iic-jku/TinyWhisper/presentations/README.md

# Presentations

## EasterHegg 2026

EasterHegg #23 took place from April 3 to 6, 2026, in Koblenz, Germany. Matthias (DL9MJ) presented TinyWhisper in his talk "Open-Source Chip Design - A New Playground for Ham Radio?".

- Homepage: https://www.easterhegg.eu/category/easterhegg-2026/
- Slides: [EasterHegg_04042026.pdf](EasterHegg_04042026.pdf)
- Video: https://media.ccc.de/v/eh23-open-source-chip-design-a-new-playground-for-ham-radio

## CERN 2026

During his sabbatical, Harald visited CERN in Switzerland and presented TinyWhisper in his talk "From Schematic to Silicon: Mixed‑Signal IC Design in Open‑Source Flows" on May 4, 2026.

- Slides & Video: https://indico.cern.ch/event/1680490/

## FSiC 2026

The Free Silicon Conference (FSiC) took place from July 6 to 8, 2026, at the University of Ljubljana, Slovenia. Simon (OE3SDE) presented TinyWhisper in his talk "From Idea to Tapeout: An Open-Source Analog Mixed-Signal Design Flow with the IHP Open-PDK".

- Homepage: https://wiki.f-si.org/index.php?title=FSiC2026
- Talk page: https://wiki.f-si.org/index.php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
- Slides: [FSiC2026_OSICD-Flow_Final.pdf](https://wiki.f-si.org/images/8/86/FSiC2026_OSICD-Flow_Final.pdf)

## QSP Article

The Austrian Experimental Radio Society (Österreichischer Versuchssenderverband - ÖVSV) is celebrating its 100th anniversary in 2026. This milestone marks a century of technical innovation, experimentation, and community in the amateur radio world. To mark this occasion, Simon (OE3SDE) submitted a QSP article (German only) for the anniversary issue, which will be published in August.

- Copies of the ÖVSV amateur radio journal QSP can be downloaded here approximately six months after publication: https://www.oevsv.at/downloads/
