iic-jku/TinyWhisper/enclosure/README.md

# 3D-printed Enclosure

- 3D drawing with [FreeCAD](https://www.freecad.org/)
- 3D printing @ JKU / JMU
