iic-jku/TinyWhisper/ihp130/macros/README.md

# Macros

Every folder here is one macro with its own `Makefile` and `README.md`, following the same conventions as the chip top-level (`make help`, `make all`, `make clean`). The chip builds them through `make build-<macro>` and cleans them through `make clean-all` in the top-level [`Makefile`](../Makefile). The three macros are the three kinds of block a new one starts from:

| Macro | Kind | Source of truth | Flow |
| --- | --- | --- | --- |
| [`riscv/`](riscv/) | digital | SystemVerilog in `rtl/` | Verilator lint, Icarus Verilog and cocotb simulation, LibreLane hardening with DRC and LVS inside the run, a committed XSPICE model for the mixed-signal Xschem simulation, FPGA emulation on three boards |
| [`iqmod/`](iqmod/) | analog | Xschem schematics and hand-drawn GDS in `layout/` | Xschem testbenches, KLayout and Magic DRC, LVS and PEX, LEF, Liberty and Verilog stub export by Magic, CACE characterization |
| [`coupled_resonator_lc_bpf/`](coupled_resonator_lc_bpf/) | schematic-only | Xschem schematics | Xschem testbenches |

The `Makefile` in this folder has one job: it starts a new macro as a renamed copy of an existing one.

## Directory Structure

```text
📁 macros/
├─ 📁 coupled_resonator_lc_bpf/   schematic-only macro, see coupled_resonator_lc_bpf/README.md
├─ 📁 iqmod/                      analog macro, see iqmod/README.md
├─ 📁 riscv/                      digital macro, see riscv/README.md
├─ 📁 scripts/
│  └─ rename_gds_cells.py         renames the cells inside a GDS, used by make macro
├─ Makefile
└─ README.md
```

## Makefile Targets

### Show Available Targets

```sh
make help
```

### PDK Guard

`make macro` needs the `ihp-sg13g2` PDK, only `help` is exempt. The target renames the cells inside the copied GDS with KLayout and produces a macro that the chip flow builds against `ihp-sg13g2`, so a wrong `$PDK` is caught before it starts:

```sh
$ make macro FROM=iqmod NAME=mixer
Makefile:18: *** PDK is "ihp-sg13cmos5l", but the macros need "ihp-sg13g2". Run `sak-pdk ihp-sg13g2` in this shell and retry, or pass REQUIRED_PDK= to skip this check.  Stop.
```

The check is a parse-time conditional at the top of the Makefile, the same one every macro and IP Makefile carries. Switch the PDK with `sak-pdk ihp-sg13g2`, or pass `REQUIRED_PDK=` to skip the check.

### Start a New Macro from an Existing One

```sh
make macro FROM=<macro> NAME=<name>
```

`FROM` is the macro to copy, `iqmod` for an analog block, `riscv` for a digital one, `coupled_resonator_lc_bpf` for a schematic-only one, or any macro of your own that is already here. `NAME` is the name of the new macro: a lowercase letter followed by lowercase letters, digits or underscores, so that it works as a file name, a GDS cell name and a Verilog module name alike. The top cell follows the convention of the copied macro, so `NAME=amp` gives `amp_top` with the `amp_mfb_lpf`, `amp_mixer` and `amp_spdt_switch` cells from `iqmod`, and `NAME=cpu` gives the module `cpu_top` from `riscv`.

The target refuses to run when `NAME` exists already. Otherwise it does, in this order:

1. Copies every file of `FROM` that git knows about, tracked or untracked but not ignored. LibreLane runs, `sim_build/`, `__pycache__/` and the other ignored build outputs stay behind. A tracked file missing from the working tree, for example after `make clean` in `FROM`, is skipped. Outside a git checkout it falls back to copying the whole folder.
2. Runs `make clean` in the copy, so that the committed build outputs of the copied macro (`final/`, `netlist/`, `render/img/`, the reports) are gone as well.
3. Renames every file and folder whose name carries `FROM`.
4. Replaces `FROM` inside every text file, in its three spellings `iqmod`, `Iqmod` and `IQMOD`. That covers `TOP` in the `Makefile` and in every `fpga/<board>/Makefile`, `DESIGN_NAME` and `VERILOG_FILES` in `flow/librelane/config.yaml`, the symbol instances and the `.include` lines in the Xschem testbenches, `name:`, `template:` and `script:` in the CACE yaml, the file names in the plot scripts, the module names and include guards in the RTL, and `lib_name` and `lib_path` in the `.klib` library maps.
5. Renames the cells inside every GDS in `layout/` with [`scripts/rename_gds_cells.py`](scripts/rename_gds_cells.py). The DRC, LVS and PEX targets pass the file name as the cell name, so the two must match. A `.klay.gds` references cells from the libraries that its `.klay.klib` maps to other GDS files, and each link is stored inside the GDS by library name and cell name, where no text edit reaches it. The script processes the files in dependency order, libraries before the layouts that use them, and relinks every reference to the renamed cell of the renamed library, which is what KLayout resolves through its Library Manager plugin when you open the layout afterwards. It runs without the PDK, so the PCells stay frozen exactly as the source saved them instead of being re-evaluated against the installed PDK. The geometry does not change, an XOR of every layer against the source with the library maps resolved is empty.
6. Lists what still carries the old name. Markdown files and notebooks are left alone on purpose, they describe the copied design rather than reference it, and a blind rename would turn their prose into nonsense. Anything else in that list is something the target could not know about.

The copy is a complete macro that builds as one: `make all` in the new folder passes exactly as it does in the source, because nothing but names has changed. So the copy is the moment to commit, before the real work starts.

Run `make all` in the copy before any single simulation target. Step 2 removed the generated netlists, and the testbenches include them: `final/nl/` in the gate-level cocotb simulation of a `riscv` copy, whose XSPICE model stays because `make clean` keeps `netlist/xspice/`. An `iqmod` copy needs more than `make all`. Its 35 Xschem testbenches include nine extracted netlists under legacy names, `netlist/pex/<cell>_pex.spice`, which no target writes (`magic-pex` and `klayout-pex` write `<cell>_magic_pex_<mode>.spice` and `<cell>_klayout_pex_<mode>.spice`). Step 2 deletes them for good, so every testbench stops at its missing include until the `.include` line points at a netlist that exists.

For a new analog macro named `amp` and a new digital macro named `cpu`:

```sh
cd macros
make macro FROM=iqmod NAME=amp
make macro FROM=riscv NAME=cpu
```

> [!NOTE]
> The target runs in the IIC-OSIC-TOOLS container: it needs GNU `find`, `grep`, `sed` and `xargs`, and `klayout` for the GDS step.

### What Is Left to Do

The new macro still implements the copied design under its new name. What follows is the work the target cannot do.

#### From iqmod (Analog)

1. Replace the design: the schematics and symbols in `schematic/xschem/`, the layout sources in `layout/` (`<NAME>_top.klay.gds` and the `.klay.gds` files it pulls in through the `.klib` library maps, down to the unit cell `.gds` files) and the export `layout/<NAME>_top.gds`, see [Layout Sources and the Exported Tapeout GDS](iqmod/README.md#layout-sources-and-the-exported-tapeout-gds). Keep the box on the `prBoundary` layer (`189/0`) around the top cell and resize it with the macro, `make check-boundary` verifies it.
2. Rewrite the testbenches in `testbenches/xschem/` and the plot scripts in `testbenches/xschem/plot_simulations/` for the new pins and measurements, and the testbench list of `sim-all` in the `Makefile`. `make symbol-pex` rebuilds `<CELL>_pex.sym` from the cell symbol, so only the cell symbols need drawing.
3. Adapt the CACE datasheets in `verification/cace/` with their templates and scripts, or delete the folder together with the `sim-cace` line of `sim-all`.
4. The sizing notebooks in `scripts/sizing/`, the filter designer in `scripts/filter_designer/` and the PWM generator in `scripts/pwm_generator/` are specific to the IQ modulator, adapt or delete them.
5. Rewrite `README.md` and `render/blender/README.md`.

#### From riscv (Digital)

1. Replace the RTL in `rtl/` and adjust `MODULES_SYNTH` and `MODULES_SIM` in the `Makefile` when you add or drop files. `rtl/constants.sv` keeps its name, its macros were renamed with the rest.
2. When the ports change, delete both symbols in `schematic/xschem/` instead of editing them. An edited copy of the riscv symbol looks plausible, but `make symbol-check` rejects every pin that no longer matches a port. Harden once, scaffold the symbol from the ports of the hardened design, arrange it, and only then run the full flow:

    ```sh
    make librelane        # harden the new design
    make copy-netlist     # brings netlist/pnl/<TOP>.pnl.v into the tree
    make symbol-gl        # scaffold schematic/xschem/<TOP>.sym from its ports
    xschem schematic/xschem/<TOP>.sym   # rename pins to house style, arrange, draw the body
    make all
    ```

    The XSPICE model in `netlist/xspice/` is a committed source file of this macro that `clean` keeps, and `generate-xspice` rebuilds it only while the free-running frequency generation in `rtl/memory.sv` is active, see [Generate XSPICE File](riscv/README.md#generate-xspice-file). Wire the Xschem testbench to the finished symbol afterwards, because its pins are what the testbench connects to by coordinate. See [Build the Xschem Symbol](riscv/README.md#build-the-xschem-symbol).
3. Update `CLOCK_PORT` and `DIE_AREA` in `flow/librelane/config.yaml`, the pin placement in `flow/librelane/pin_order.cfg`, and the constraints in `impl.sdc` and `signoff.sdc`.
4. Rewrite the testbenches in `testbenches/verilog/`, `testbenches/cocotb/` and `testbenches/xschem/`.
5. Update `DUT_SRCS` in `fpga/dut.mk` and the pin constraint file in each `fpga/<board>/` you care about to the ports of the new design. Delete the board folders you do not need, the dispatcher derives its board list from the folders that are there. See [fpga/README.md](riscv/fpga/README.md).
6. Rewrite `README.md`, `fpga/README.md` and `render/blender/README.md`.

#### From coupled_resonator_lc_bpf (Schematic-Only)

1. Replace the schematics and symbols in `schematic/xschem/`, the testbench in `testbenches/xschem/`, and the testbench list of `sim-all` in the `Makefile`.
2. The filter design sheet in `scripts/` is specific to the coupled-resonator filter, adapt or delete it.
3. Rewrite `README.md`.

### Register the Macro at the Chip Top-Level

There is no central macro list. A new macro is added in these places, all relative to `ihp130/`:

1. `Makefile`: a `build-<NAME>` target, its line in `build-macros`, and a `clean` line in `clean-all`.
2. `rtl/tinywhisper_core.sv`: instantiate the macro.
3. `flow/librelane/config.yaml`: a `MACROS` entry with the view paths (`dir::../../macros/<NAME>/final/...`) and the instance placement. The placement of an analog macro snaps to the Metal3 routing grid, see [doc/floorplan.md](../doc/floorplan.md).
4. `flow/librelane/pdn_cfg.tcl`: a `define_pdn_grid -macro` block when the power pins of the macro are not on the layers of the default grid, see the `iqmod_top` block at the end of the file.
5. `schematic/xschem/xschemrc`: a `source` line for the `xschemrc` of the new macro, without it the symbols of the macro do not resolve at the chip top-level.
6. `schematic/xschem/tinywhisper.sch` or `tinywhisper_top.sch`: place the symbol of the macro where the chip instantiates it.
7. `testbenches/cocotb/tinywhisper_top_tb.py`: the `sources` list names the netlist or RTL and the stub of every macro.
8. The documentation: [doc/floorplan.md](../doc/floorplan.md), [doc/specifications.md](../doc/specifications.md), [doc/pinout.md](../doc/pinout.md) when pins change, and the chip [README.md](../README.md).

`.gitignore` and `REUSE.toml` need no line: their `ihp130/macros/*/` patterns already cover the build outputs and the files without a license header of every macro, so a new macro passes `reuse lint` and keeps its simulation outputs out of `git status` from the first build. Add the macro to git before running `reuse lint`: git does not report the ignored paths inside a folder it does not track yet, so the lint lists the build outputs of an untracked macro.
