iic-jku/TinyWhisper/ihp130/doc/README.md

# Documentation

Reference material for this chip and for the IHP SG13G2 Open-PDK it is built on.

## This chip

| Document | Contents |
| --- | --- |
| [specifications.md](specifications.md) | Top-level specifications: technology, supplies, clock, corner list, macro inventory, functional behaviour of every block. |
| [pinout.md](pinout.md) | The full 56-pad table (14 per side), with the `tinywhisper_top` port and the role each pad carries inside `tinywhisper_core`. [pinout.pdf](pinout.pdf) is the drawn version of the same table. |
| [floorplan.md](floorplan.md) | Die and core geometry, hard-macro placement coordinates, the RF and analog routing rules and the floorplan description. |

The three are cross-linked and are written against the design files, not the other way round. If you change a number in [flow/librelane/config.yaml](../flow/librelane/config.yaml), [rtl/](../rtl/) or [packaging/config.yaml](../packaging/config.yaml), mirror it here.

## Tools

| Document | Contents |
| --- | --- |
| [klayout/klayout_cheatsheet.md](klayout/klayout_cheatsheet.md) | KLayout for this PDK: shortcuts, the `SG13_dev` PCell list, layer roles, padframe components, the DRC and LVS menu entries. |
| [librelane/librelane_cheatsheet.md](librelane/librelane_cheatsheet.md) | LibreLane `final/` directory anatomy, non-default routing rules, the complete SG13G2 via and metal-stack tables, the eight LEF/DEF orientations. |
| [naming/](naming/) | The file and VHDL naming conventions this repository follows. |

## PDK

| Document | Contents |
| --- | --- |
| [ihp-sg13g2-Open-PDK/sg13g2_os_layout_cheatsheet.xlsx](ihp-sg13g2-Open-PDK/sg13g2_os_layout_cheatsheet.xlsx) | One sheet of formulas for wire resistance, parasitic capacitance and DC current limits. Read the caveats below before using it. |
| [ihp-sg13g2-Open-PDK/sg13g2_ngspice_mc_mm_guide.md](ihp-sg13g2-Open-PDK/sg13g2_ngspice_mc_mm_guide.md) | How the ngspice model files fit together, what `mm_ok` and `num_sigmas` do, and which corner, Monte Carlo and mismatch runs are possible per device family. |
| [sizing/](sizing/) | gm/ID techsweep plot overviews for the LV and HV MOS devices, the data behind the sizing notebooks in [macros/iqmod/scripts/sizing/](../macros/iqmod/scripts/sizing/). |

## Provenance and caveats

- **The IHP PDF documents are deliberately not tracked here.** `sg13g2_os_layout_rules.pdf` and `sg13g2_os_process_spec.pdf` are listed in [.gitignore](../../.gitignore), so this folder may hold local copies that are invisible to git. Take them from `$PDK_ROOT/$PDK/libs.doc/doc/` when you need them, which also means they are never stale. The layout rules are the authoritative source when a tool deck and a datasheet disagree.
- **The layout cheatsheet is a convenience, not a rule source.** Its resistance columns assume bulk-aluminium resistivity and come out roughly a factor of two optimistic against the `RESISTANCE RPERSQ` values in `sg13g2_tech.lef`, and its "min. Width" column lists 0.42 um for TopMetal1 and 0.2 um for TopMetal2 where the tech LEF says 1.64 um and 2.0 um (0.42 is the TopVia1 cut size). Take widths from the DRC deck, resistance from the tech LEF or from PEX, and the DC current limits from the tables in the [LibreLane cheatsheet](librelane/librelane_cheatsheet.md), which are read out of the tech LEF. The sheet's `Contact` current limit of 0.3 mA per cut exists only there, the tech LEF has no `DCCURRENTDENSITY` entry for `Cont`.
- **Only the files listed above are tracked.** Other folders may appear here in a working copy (tool cheatsheets, course material, vendor PDFs) and are gitignored.
- **Nothing in `doc/` is generated by a make target.** It is all hand-maintained.
