iic-jku/TinyWhisper/ihp130/macros/coupled_resonator_lc_bpf/scripts/Double-Terminated Double-Tuned LC Bandpass Filters.pdf

Double-Terminated Double-Tuned LC Bandpass Filters | TinyWhisper

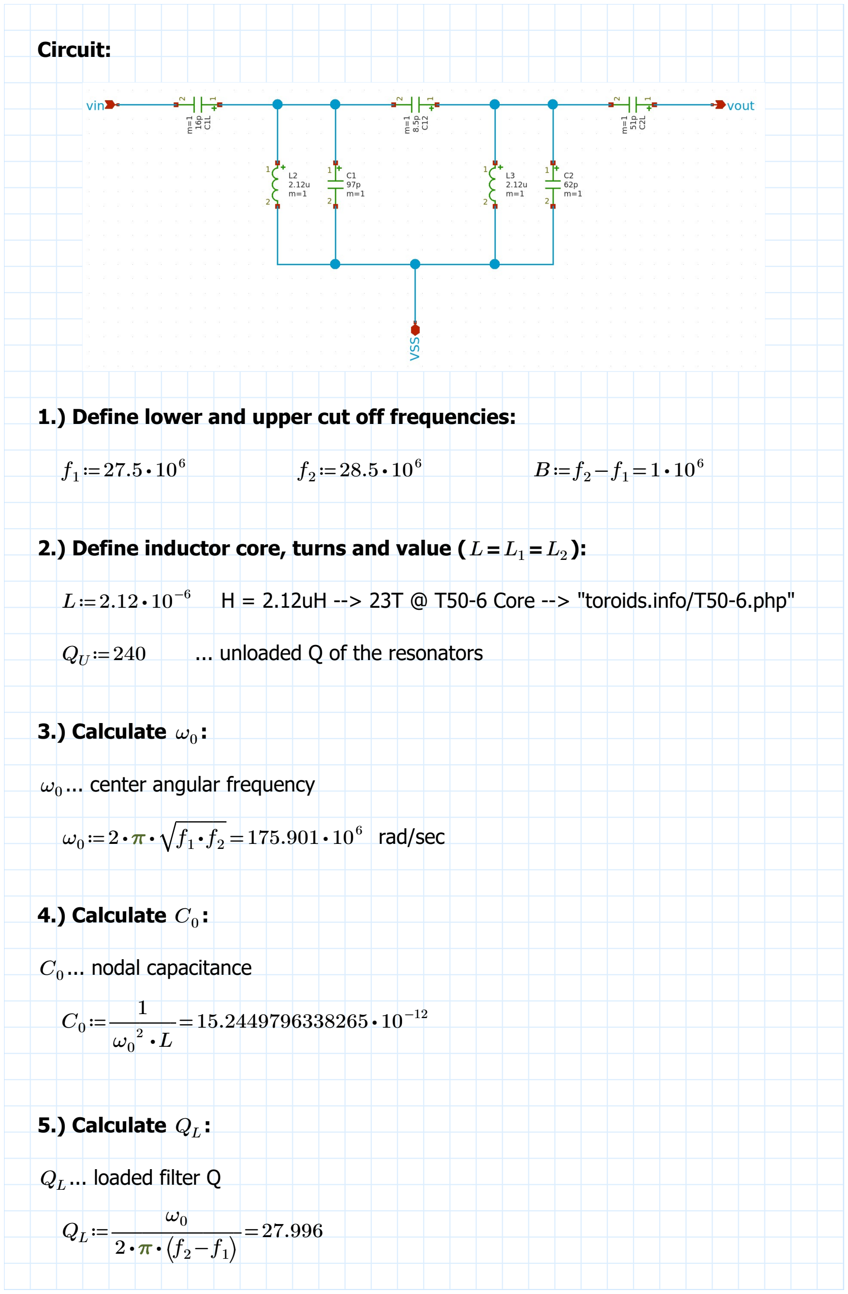
[picture p10: figure]
Circuit:; ... unloaded Q of the resonators; 3.) Calculate ω : 0; ... center angular frequency; rad/sec; 4.) Calculate C : 0; ... nodal capacitance; 5.) Calculate Q : L; ... loaded filter Q

1.) Define lower and upper cut off frequencies:

f1≔27.5 ⋅ 10⁶ | f2≔28.5 ⋅ 10⁶ | B≔f2-f1=1 ⋅ 10⁶
2.) Define inductor core, turns and value (L＝L | ＝ | ): 1 | L2
L≔2.12 ⋅ 10⁻⁶ | H = 2.12uH --> 23T @ T50-6 Core --> "toroids.info/T50-6.php"

Page 1 of 3

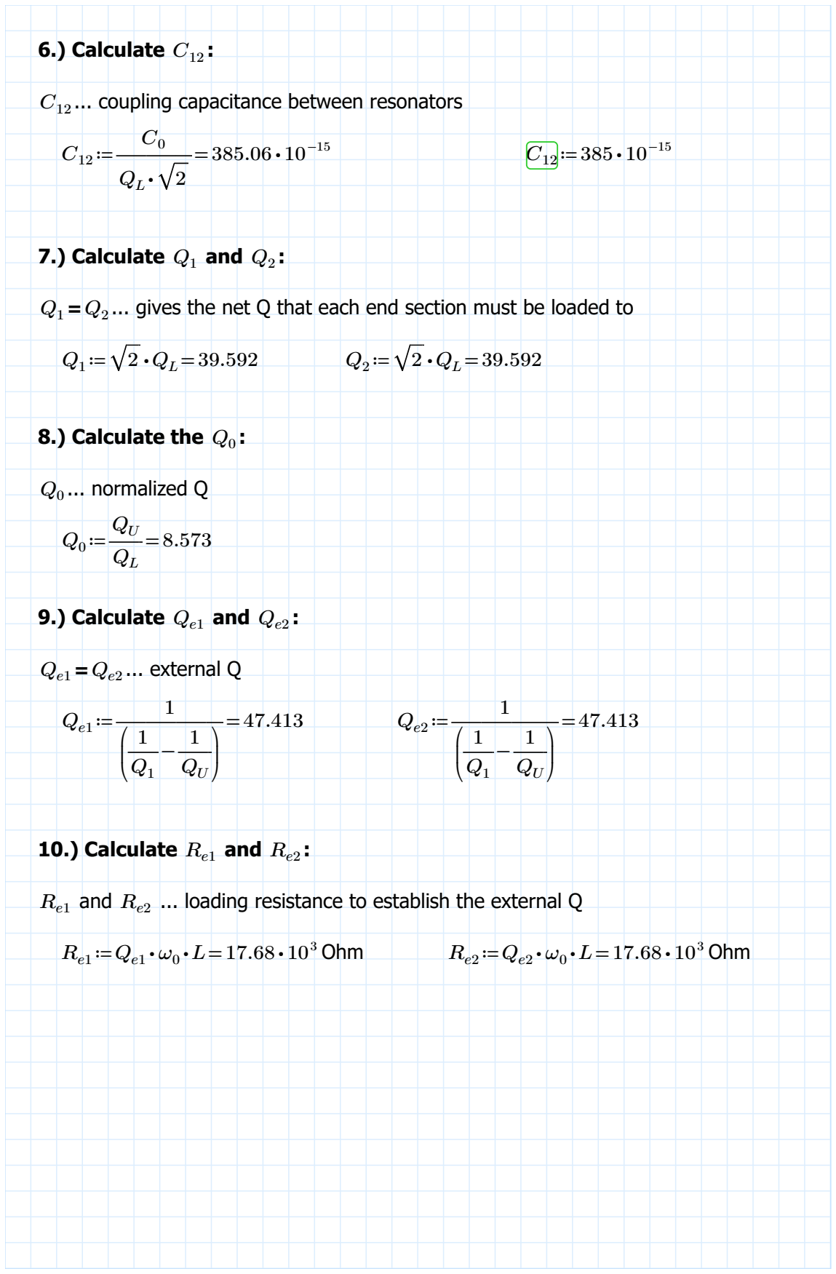
[picture p11: figure]
6.) Calculate C : 12; 7.) Calculate Q and; 8.) Calculate the; ... normalized Q; 9.) Calculate Q; and; Qe1＝Qe2 ... external Q; 10.) Calculate; ⋅L=17.68 ⋅ 10³ Ohm

C ... coupling capacitance between resonators 12

... gives the net Q that each end section must be loaded to

Re1 and Re2 ... loading resistance to establish the external Q

Page 2 of 3

11.) Calculate | C | and | : 1L | C2L
C1L | and C2L ... couple capacitor --> couple input load to | Re1 and output load toRe2
RIN≔1 ⋅ 10³ | Ohm | ... input load
ROUT≔50 | Ohm | ... output load

C1L≔―――――――=

1
ω | ⋅ 0
- R ⋅ e1 | RIN | RIN

2

1.39 ⋅ 10⁻¹² | C1L≔1.4 ⋅ 10⁻¹²

C2L≔――――――――=

1
ω | ⋅ 0
- R ⋅ e2 | ROUT | ROUT

2

6.05 ⋅ 10⁻¹² | C2L≔6.0 ⋅ 10⁻¹²
12.) Calculate | C | and | : 1 | C2
C | and | ... resonator tune capacitors 1 | C2

C1≔C0-C1L-C12=13.46 ⋅ 10⁻¹²

C2≔C0-C2L-C12=8.86 ⋅ 10⁻¹²

Formulas: https://archive.org/details/SolidStateDesignForTheRadioAmateur1986/page/n239

Page 3 of 3
