iic-jku/TinyWhisper/sky130/macros/iqmod/doc/TinyWhisper_SKY130.pdf

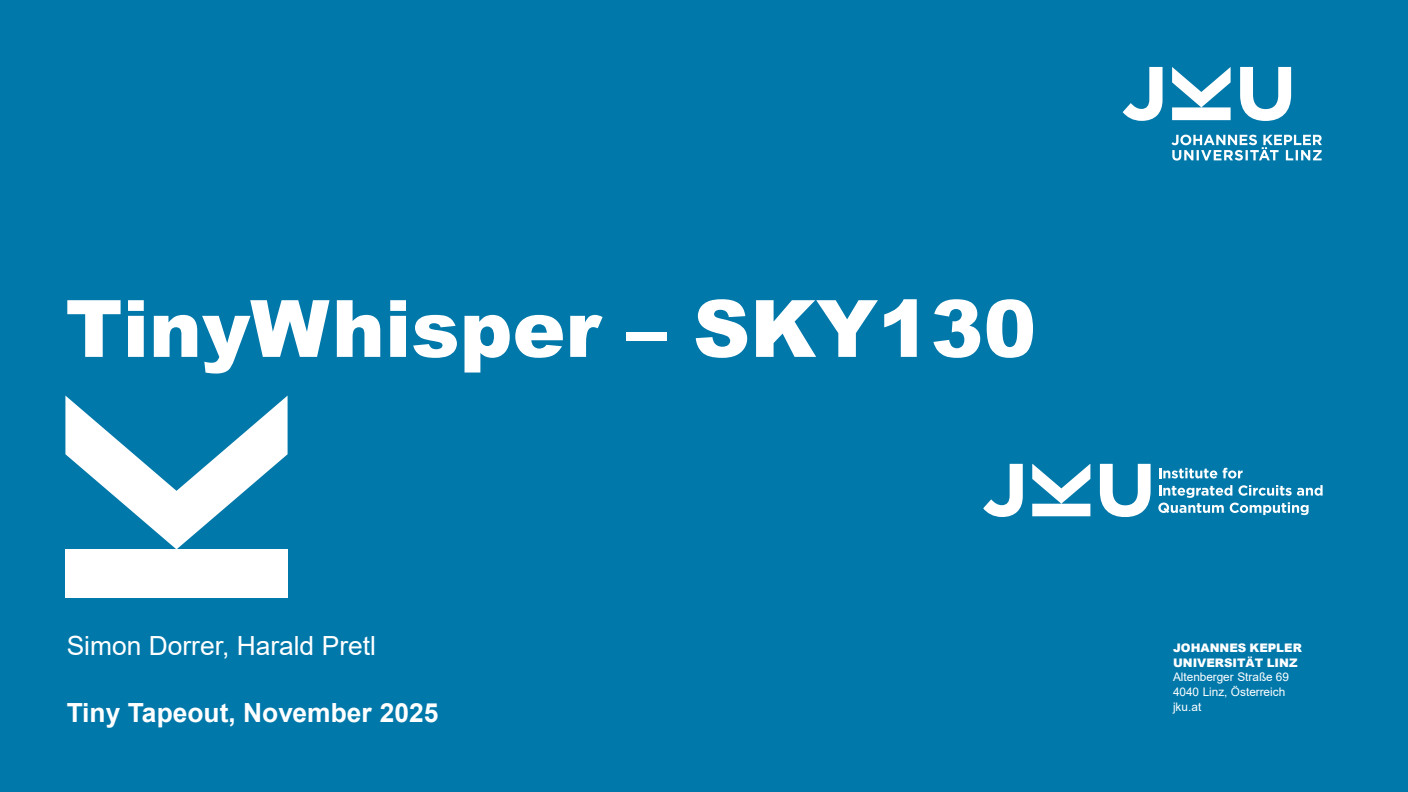
[picture p12: page 1]
JOHANNES KEPLER UNIVERSITÄT LINZ Altenberger Straße 69 4040 Linz, Österreich jku.at; TinyWhisper – SKY130

Simon Dorrer, Harald Pretl

Tiny Tapeout, November 2025

## Top-Level Schematic

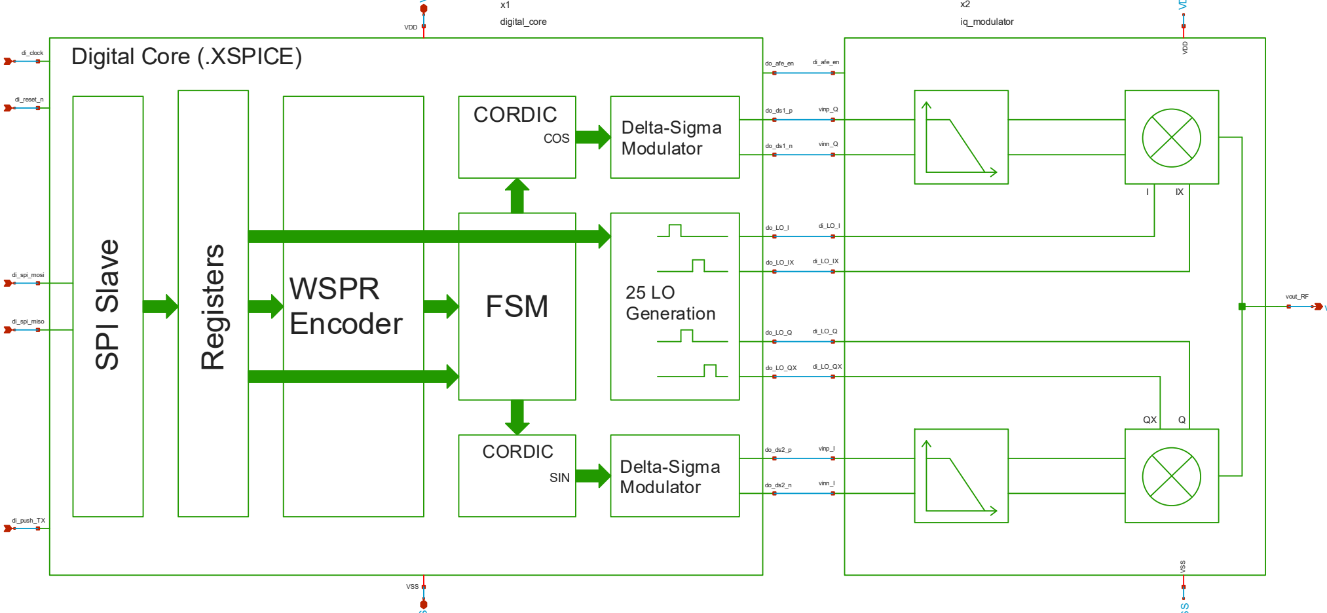
[picture p13: figure]

# Inverter-Based OTA

## Schematic – Inverter

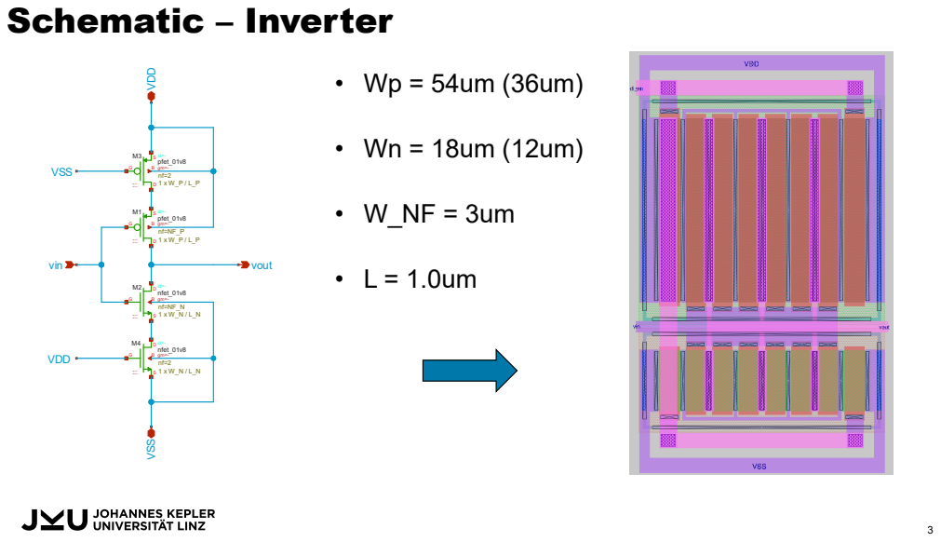
[picture p14: page 4]

## Schematic

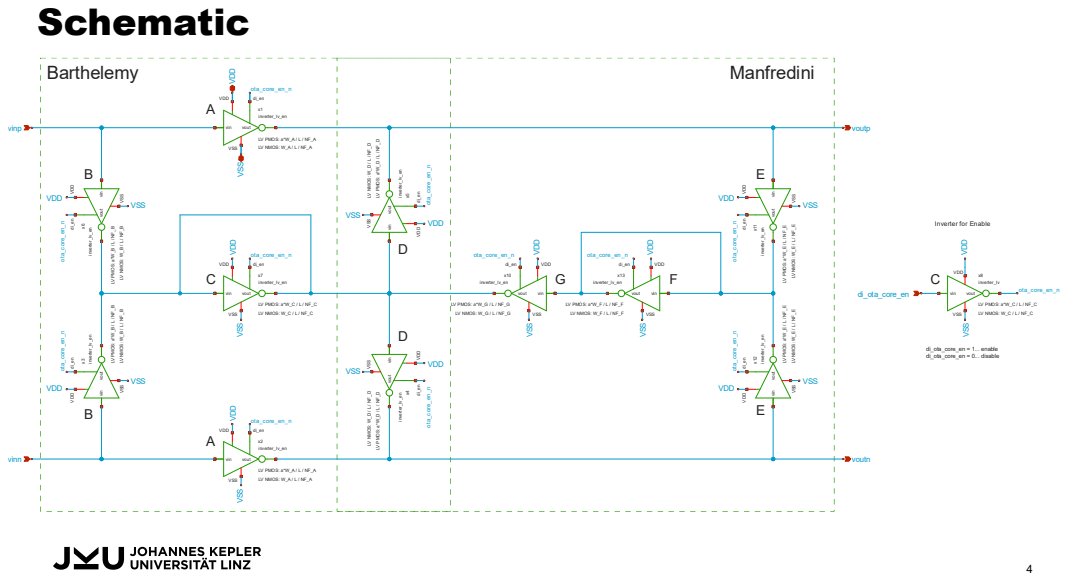
[picture p15: page 5]

## Layout

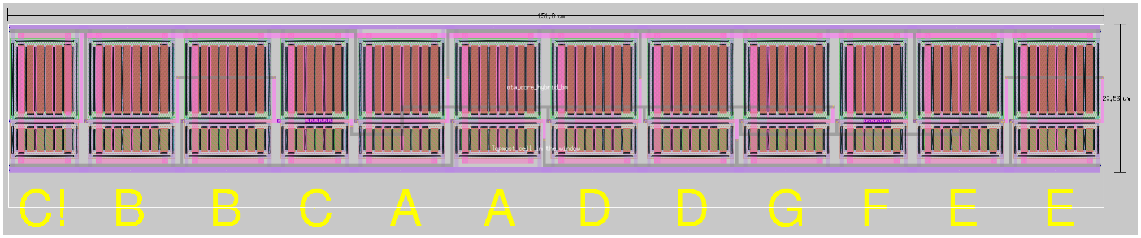
[picture p16: figure]

## DC Testbench – Output Voltage Swing

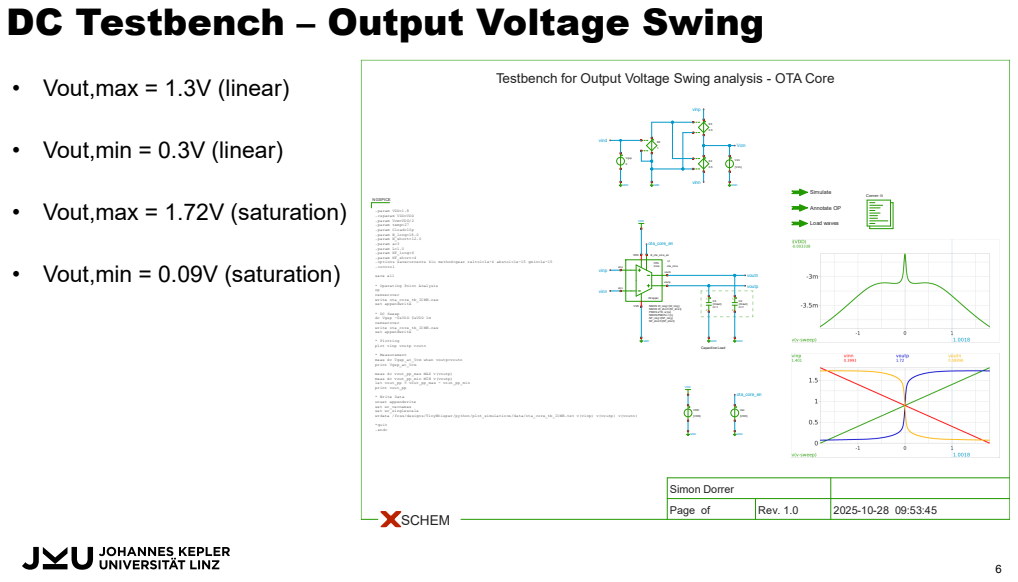
[picture p17: page 7]

• Vout,max = 1.3V (linear)

• Vout,min = 0.3V (linear)

• Vout,max = 1.72V (saturation)

• Vout,min = 0.09V (saturation)

## AC Testbench – Open-Loop Gain

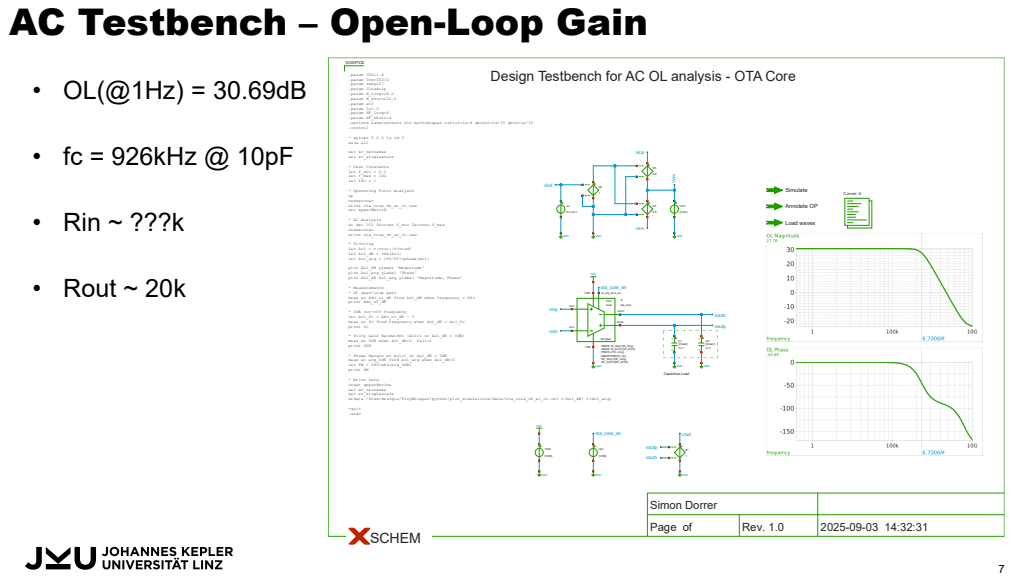
[picture p18: page 8]
• fc = 926kHz @ 10pF; • Rin ~ ???k; • Rout ~ 20k

## CACE – Open-Loop Gain

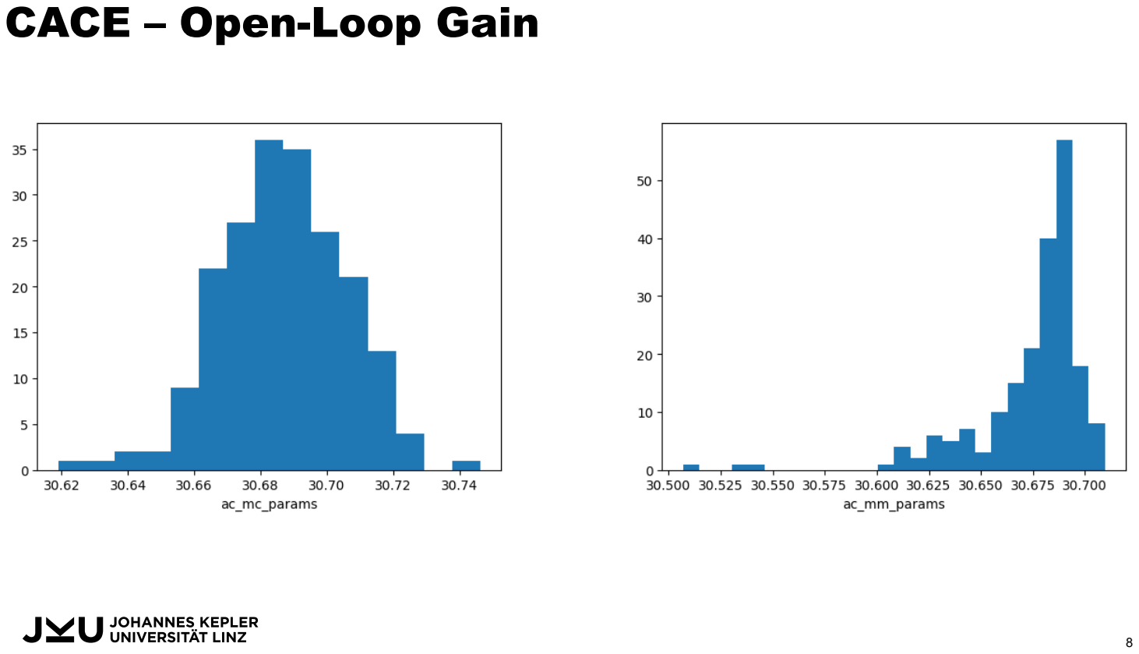
[picture p19: page 9]

## CACE – Corner Frequency

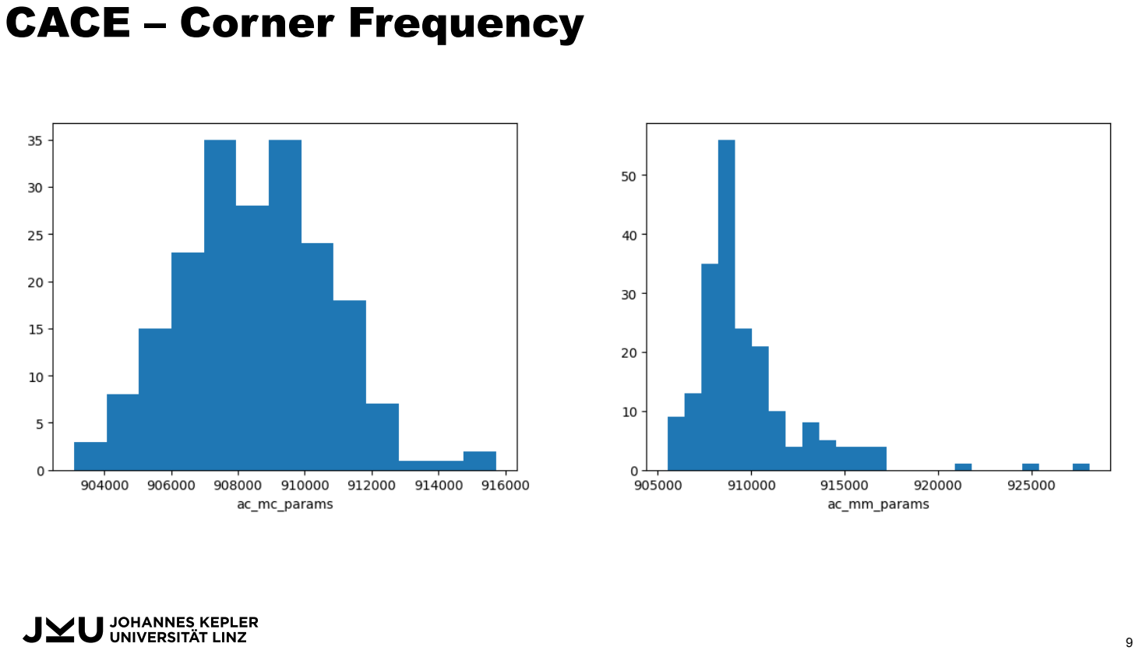
[picture p20: page 10]

# Multiple Feedback Filter

## Schematic

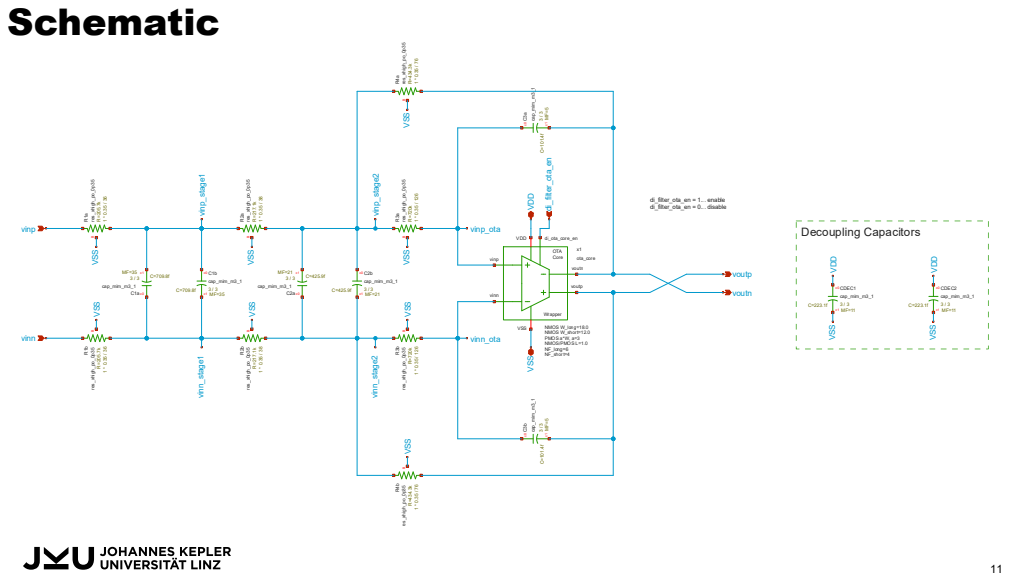
[picture p21: page 12]

## Layout

- ToDo

## AC Testbench – Closed-Loop Gain

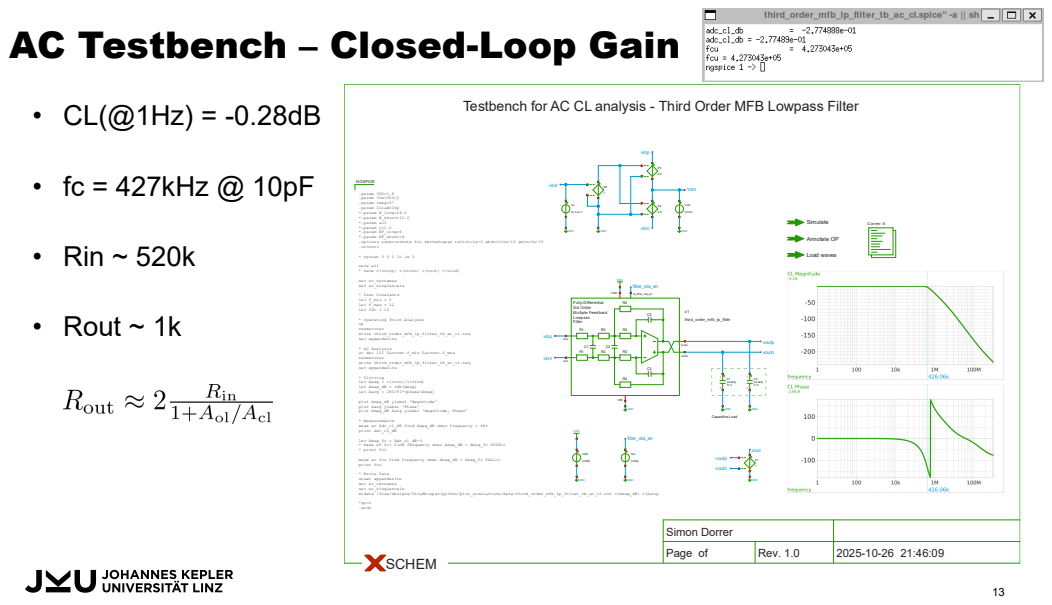
[picture p22: page 14]
• fc = 427kHz @ 10pF; • Rin ~ 520k; • Rout ~ 1k

## CACE – Closed-Loop Gain

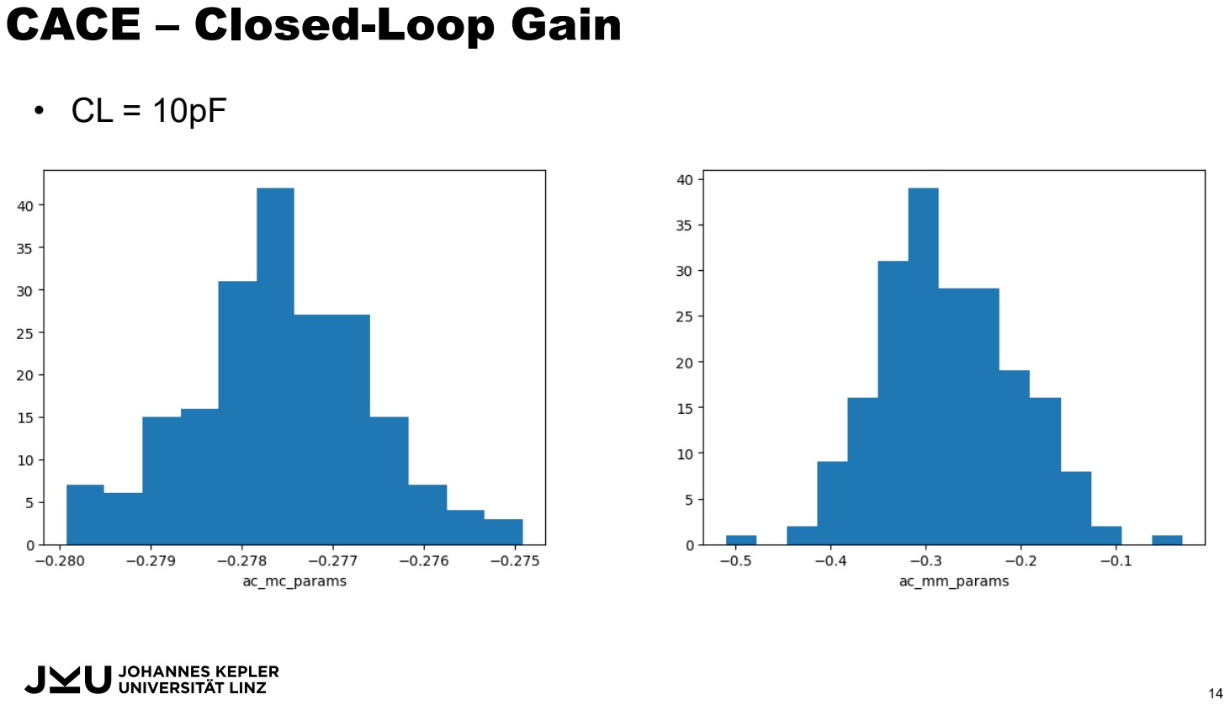
[picture p23: page 15]

- CL = 10pF

## CACE – CMRR

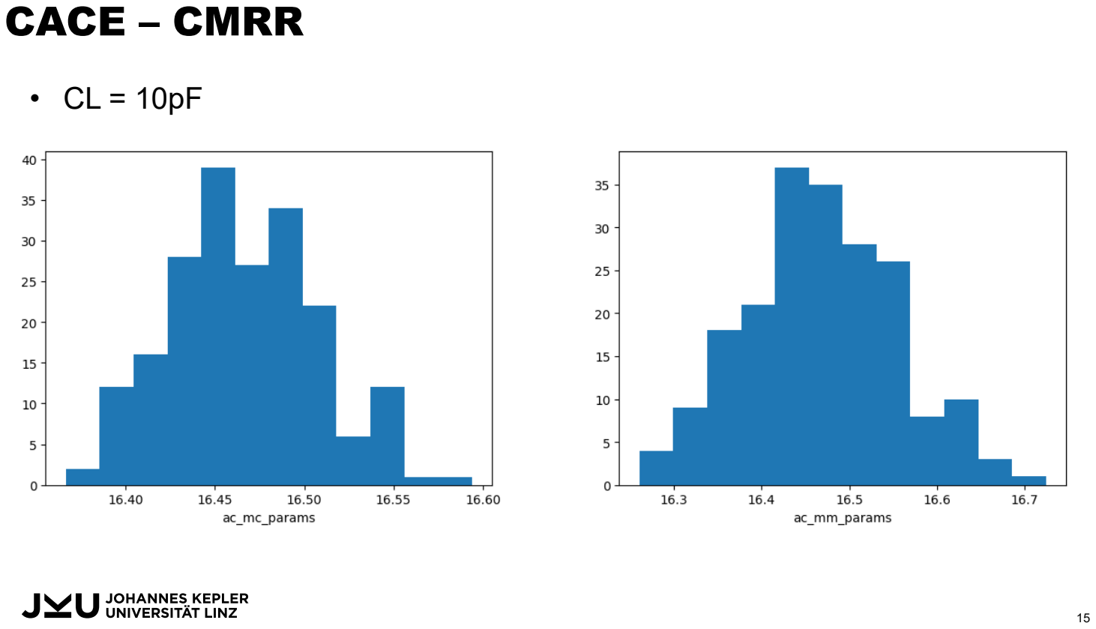
[picture p24: page 16]

- CL = 10pF

## CACE – Corner Frequency

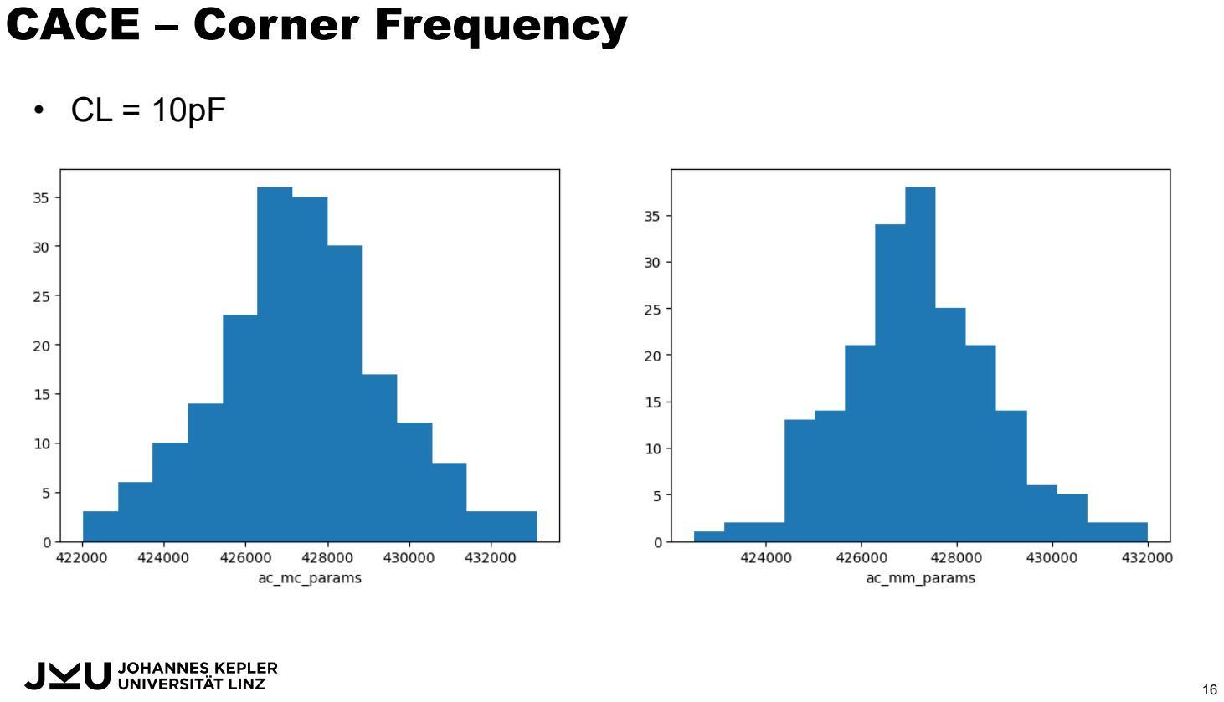
[picture p25: page 17]

- CL = 10pF

## AC Testbench – Loop Gain

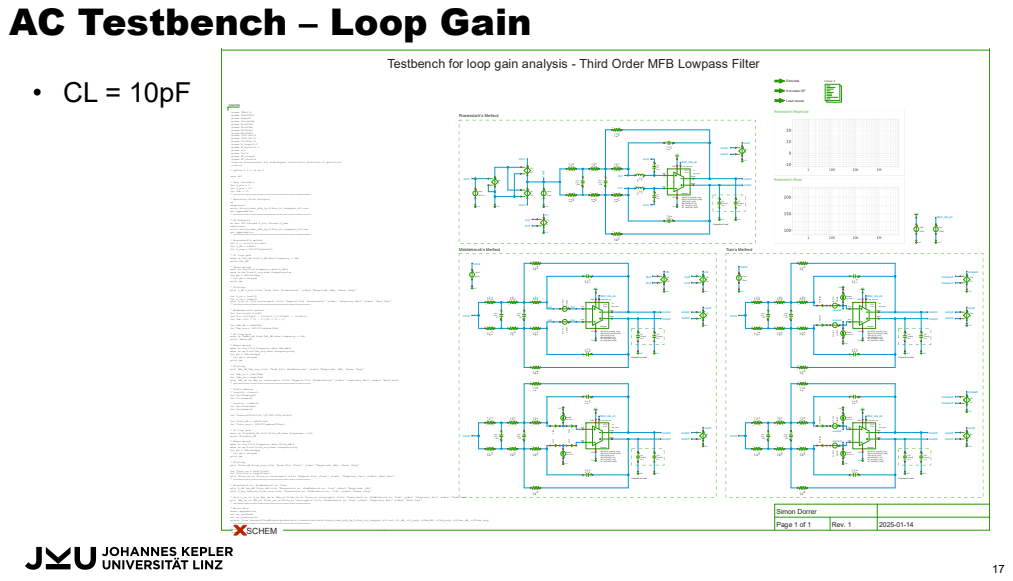
[picture p26: page 18]

## AC Testbench – Loop Gain

- PM = 111°

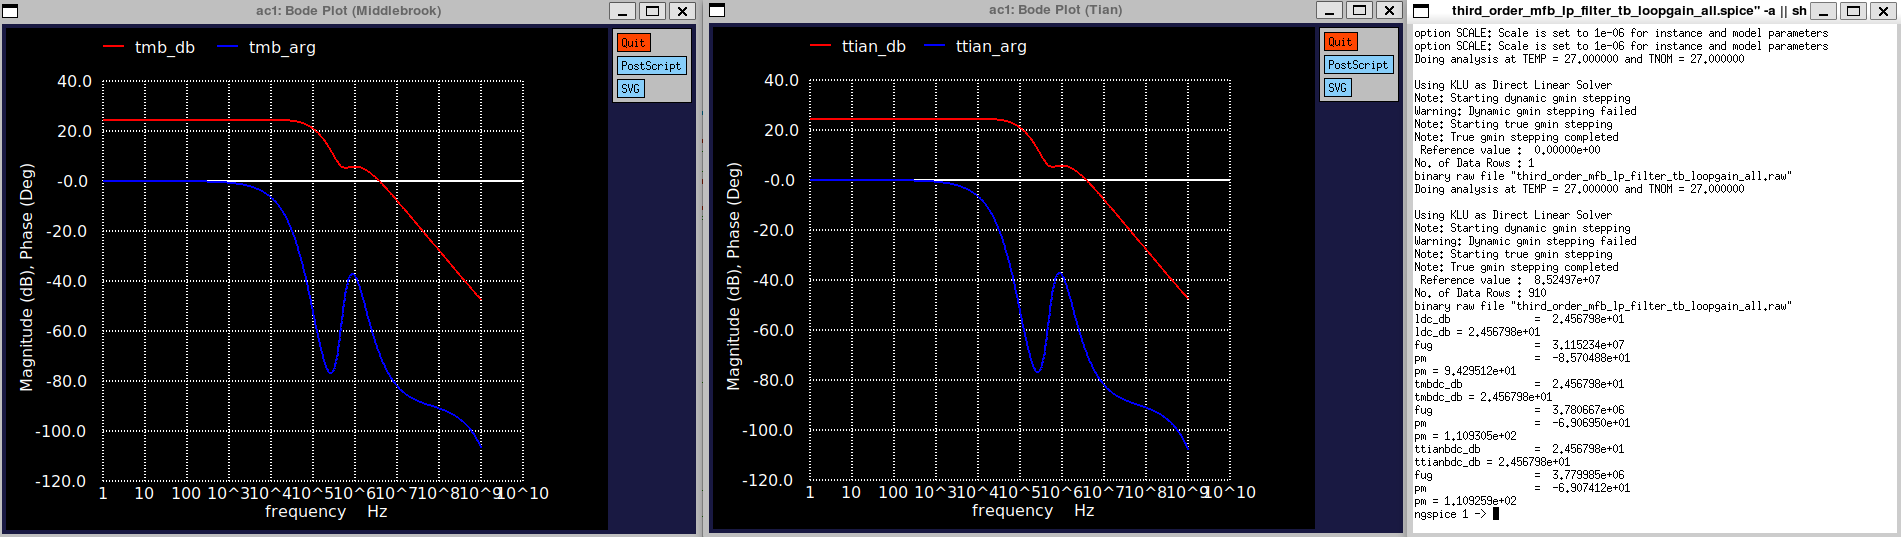
[picture p27: figure]

## Transient Testbench

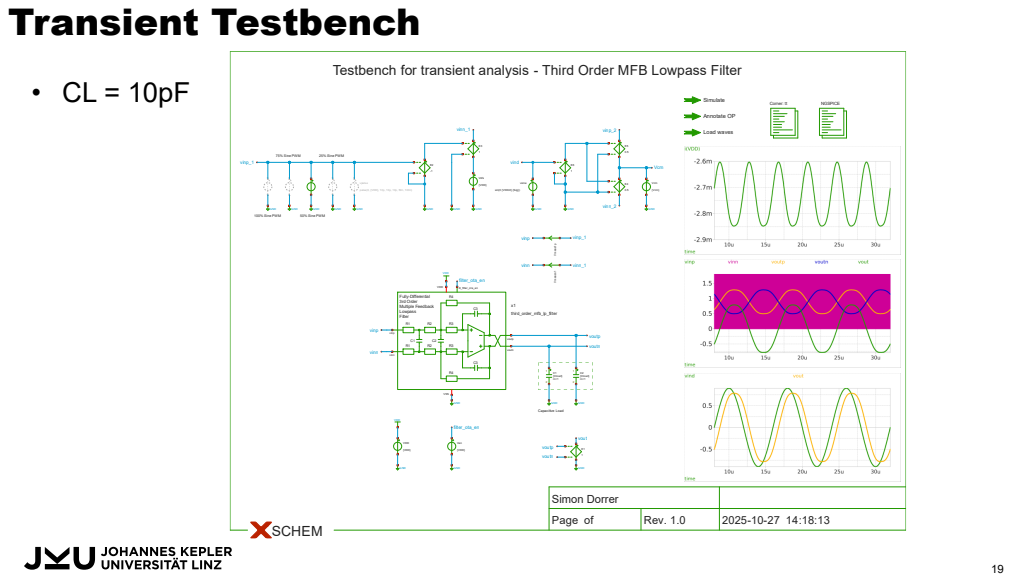
[picture p28: page 20]

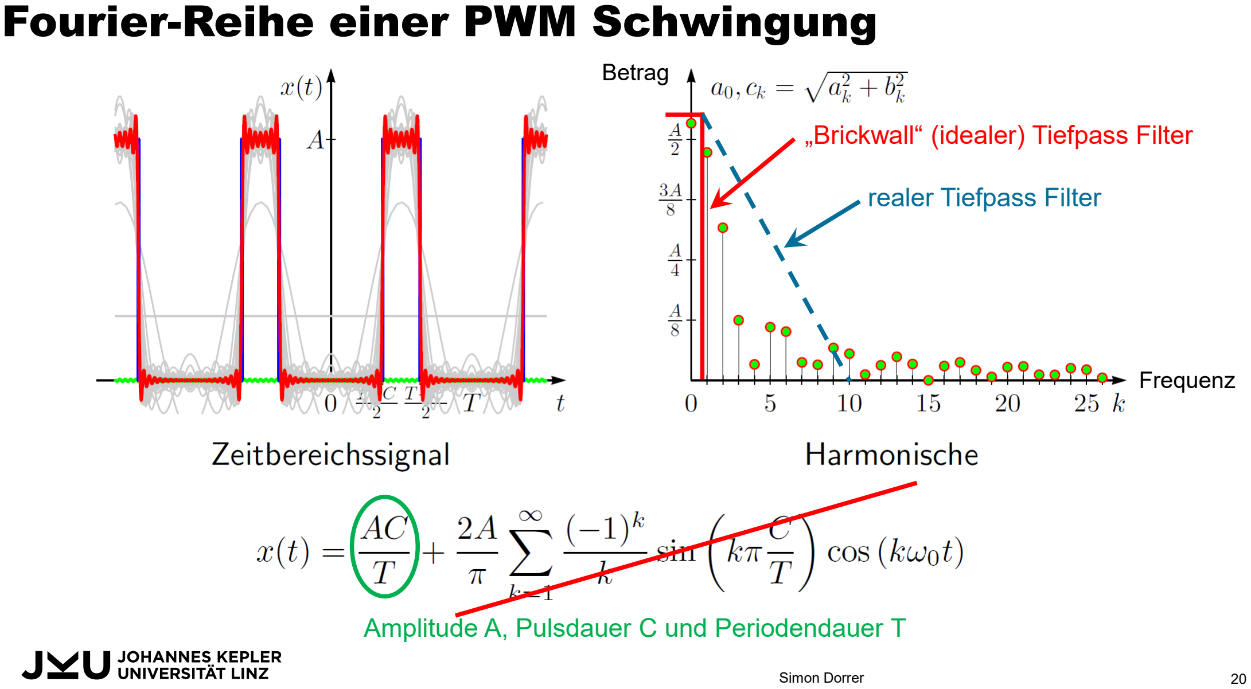
[picture p29: page 21]

### Fourier-Reihe einer PWM Schwingung

Simon Dorrer | 20

Amplitude A, Pulsdauer C und Periodendauer T

„Brickwall“

realer Tiefpass Filter

Frequenz

Betrag

## Simulation Results

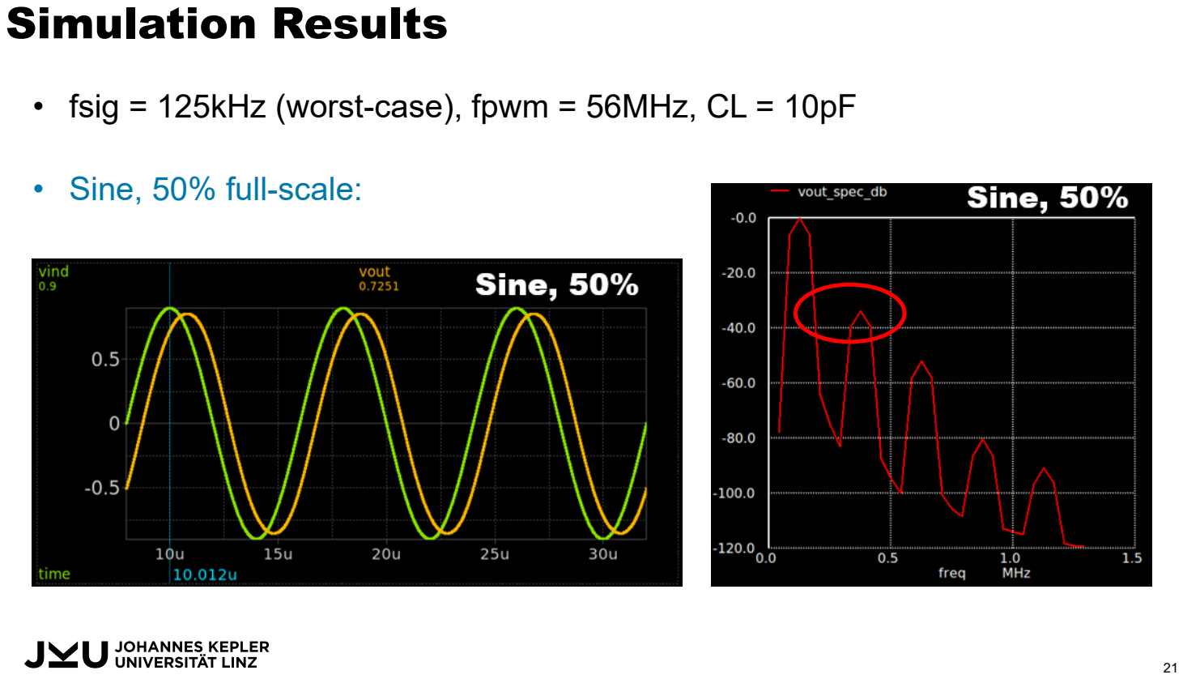
[picture p30: page 22]

- fsig = 125kHz (worst-case), fpwm = 56MHz, CL = 10pF
- Sine, 50% full-scale:

## Simulation Results

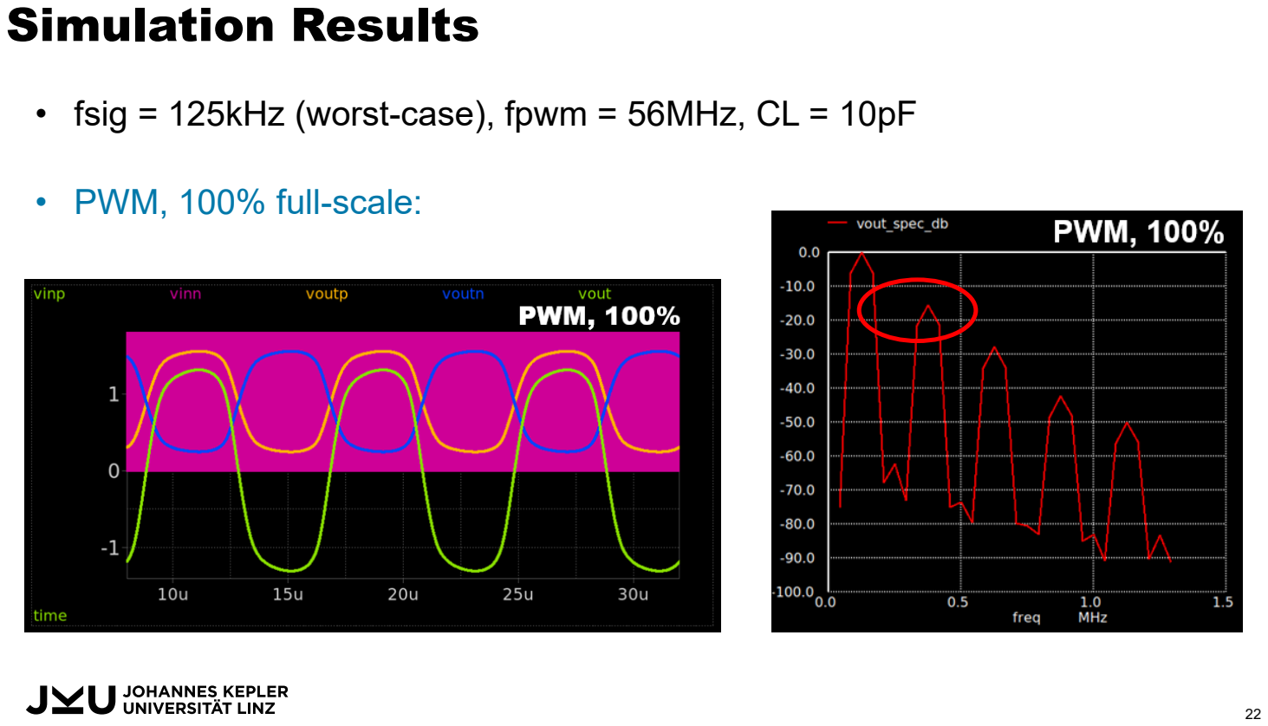
[picture p31: page 23]

- fsig = 125kHz (worst-case), fpwm = 56MHz, CL = 10pF
- PWM, 100% full-scale:

## Simulation Results

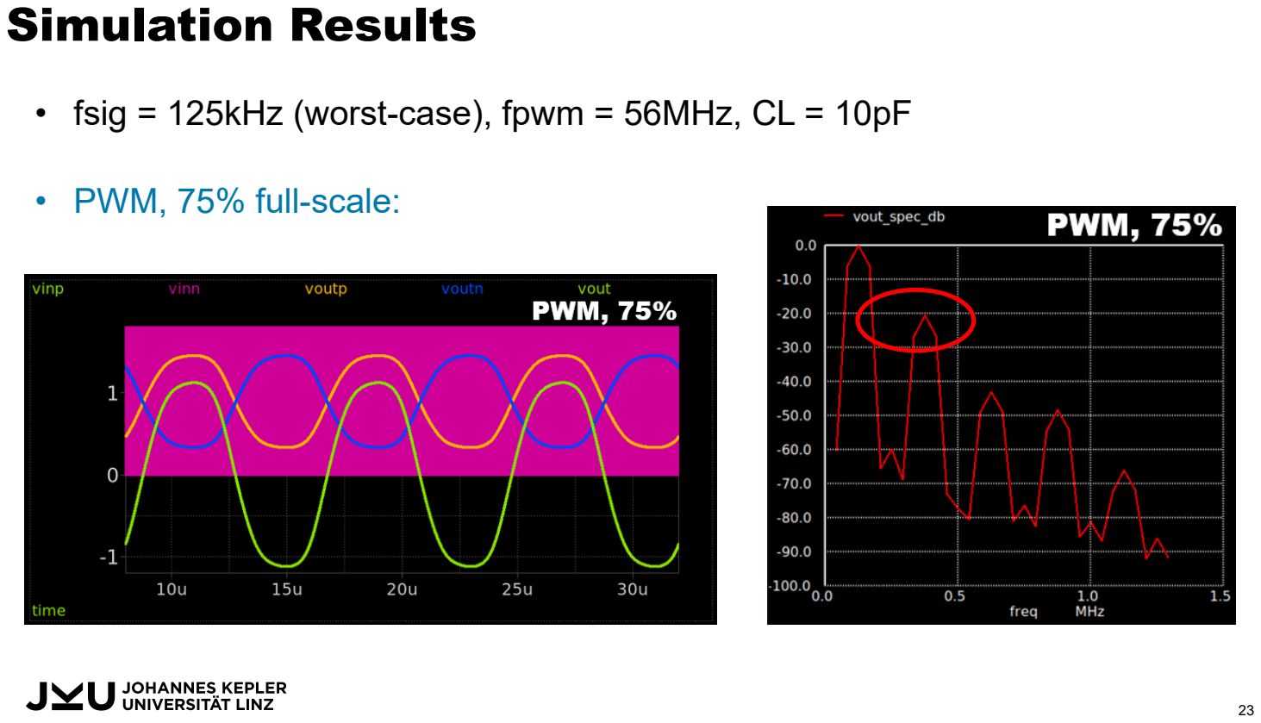
[picture p32: page 24]

- fsig = 125kHz (worst-case), fpwm = 56MHz, CL = 10pF
- PWM, 75% full-scale:

## Simulation Results

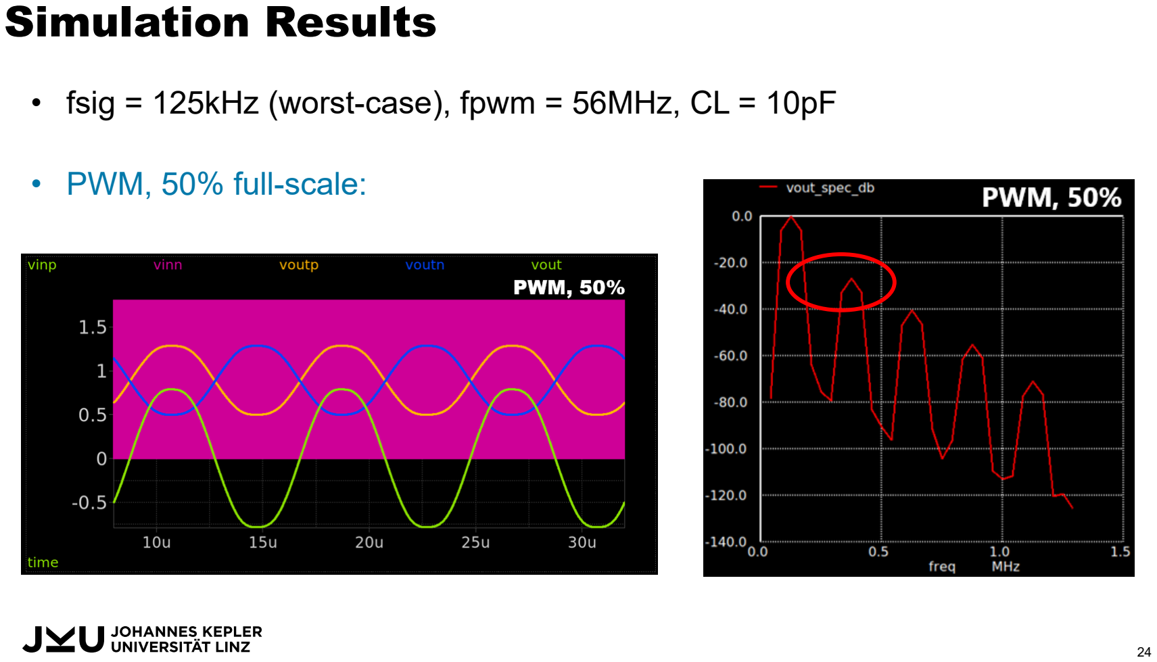
[picture p33: page 25]

- fsig = 125kHz (worst-case), fpwm = 56MHz, CL = 10pF
- PWM, 50% full-scale:

## Simulation Results

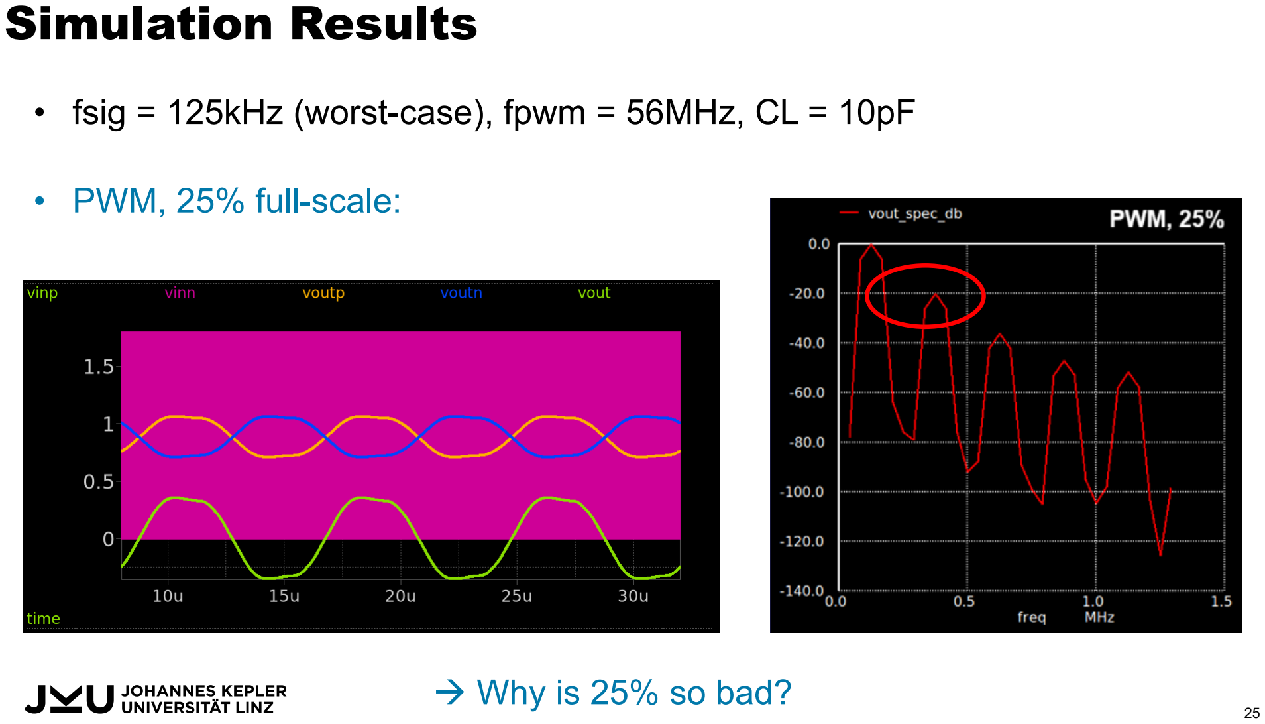
[picture p34: page 26]

- fsig = 125kHz (worst-case), fpwm = 56MHz, CL = 10pF
- PWM, 25% full-scale:

→ Why is 25% so bad?

# Voltage-Mode Passive Mixer

## Schematic – LO Logic

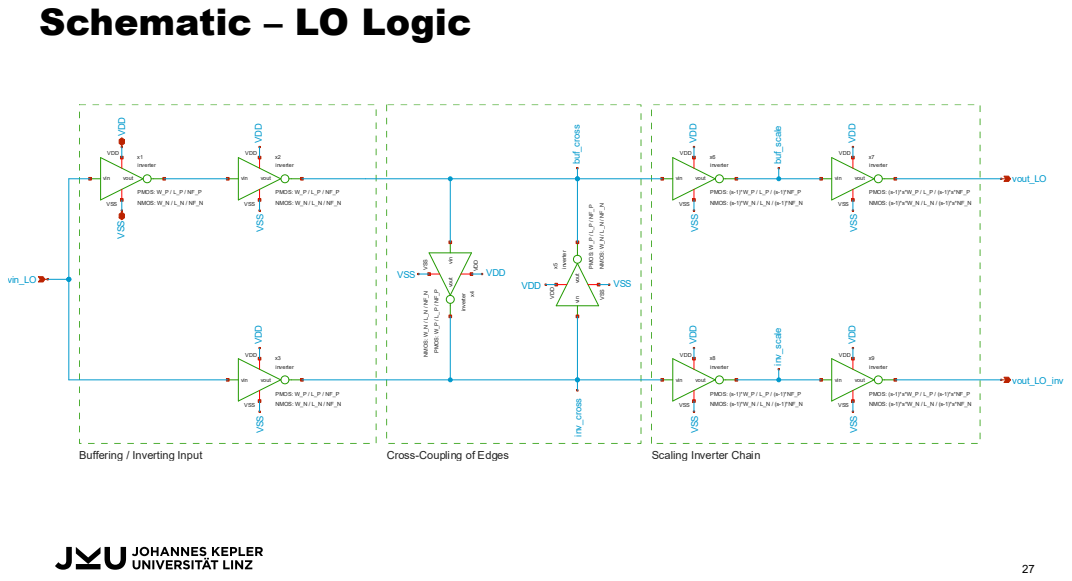
[picture p35: page 28]

## Layout – LO Logic

- ToDo

## Schematic – Transmission Gate /w Dummy

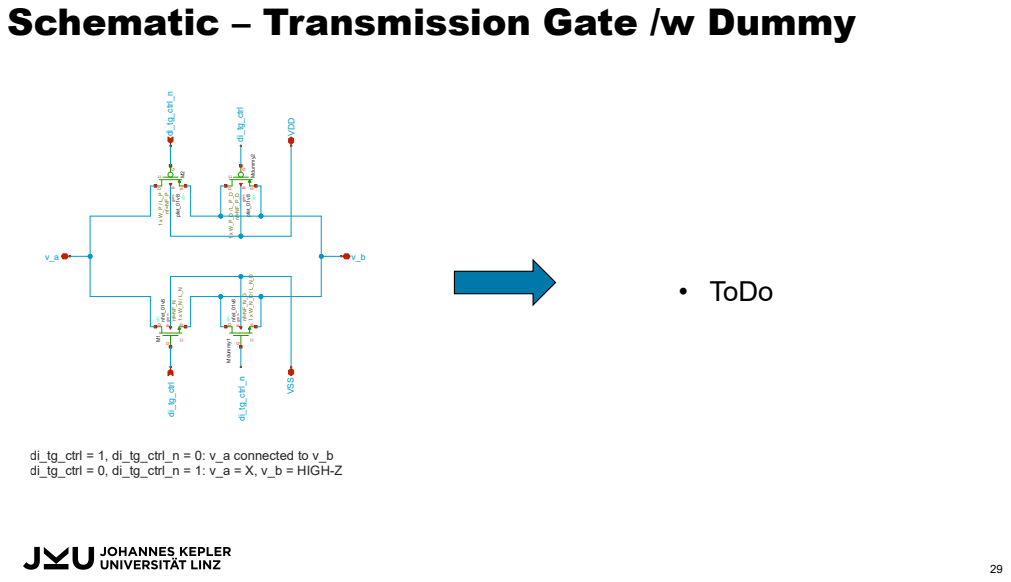
[picture p36: page 30]
• ToDo

## Rdson – Transmission Gate /w Dummy

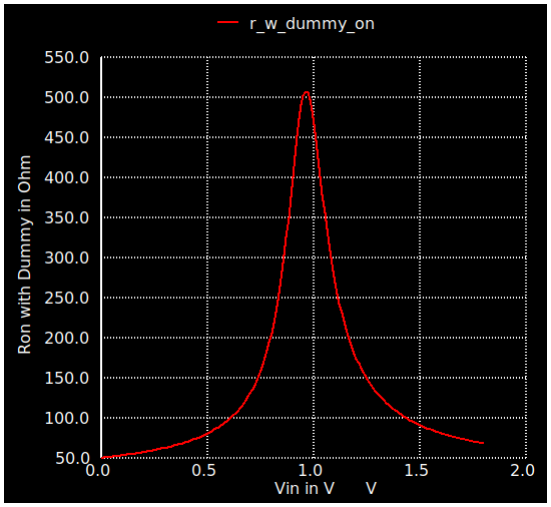
[picture p37: figure]

- Wp = 54um
- Wn = 18um
- W_NF = 3um
- L = 0.15um

## Schematic

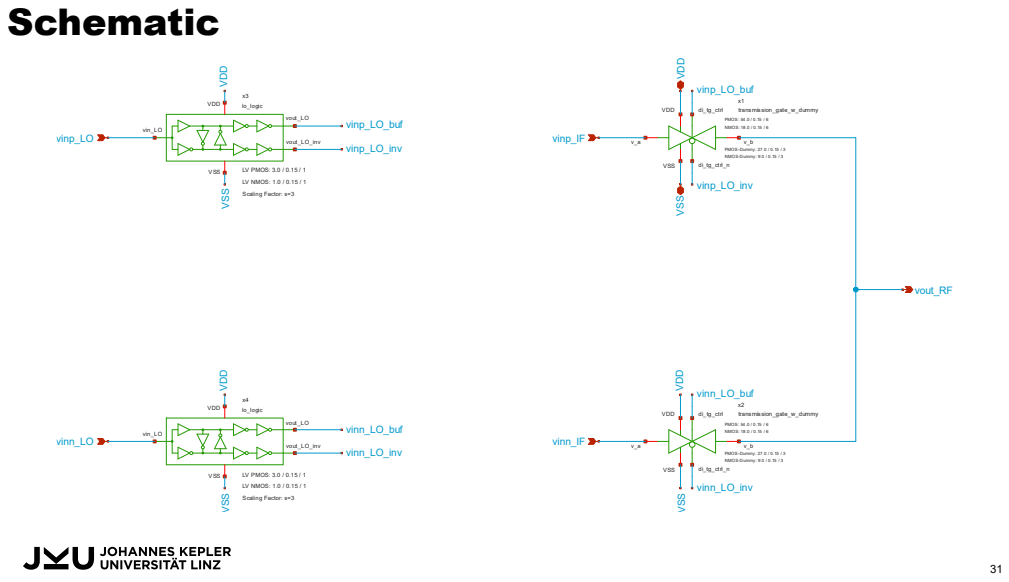
[picture p38: page 32]

## Layout

- ToDo

## Transient Testbench

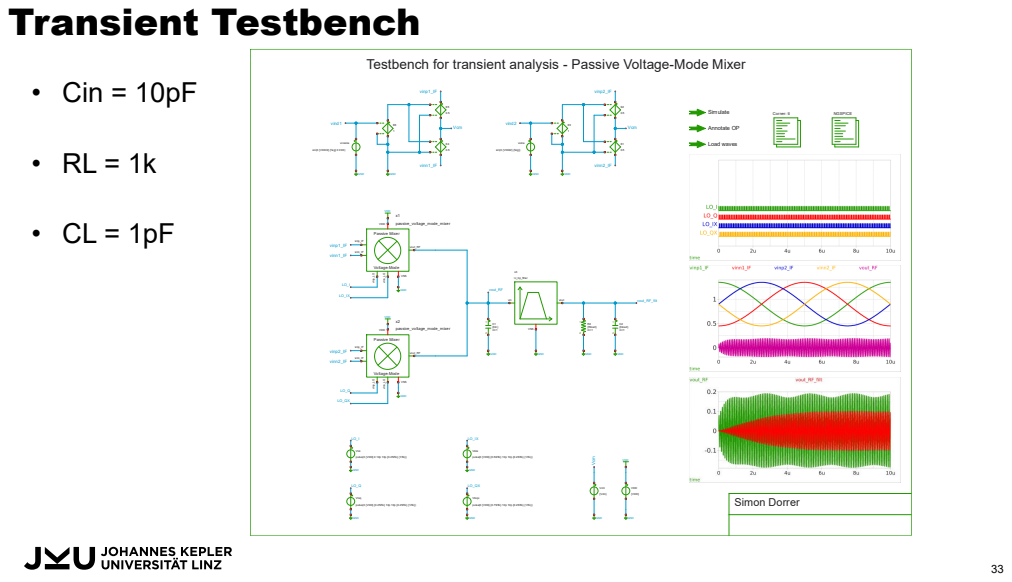
[picture p39: page 34]
• Cin = 10pF

## Simulation Results

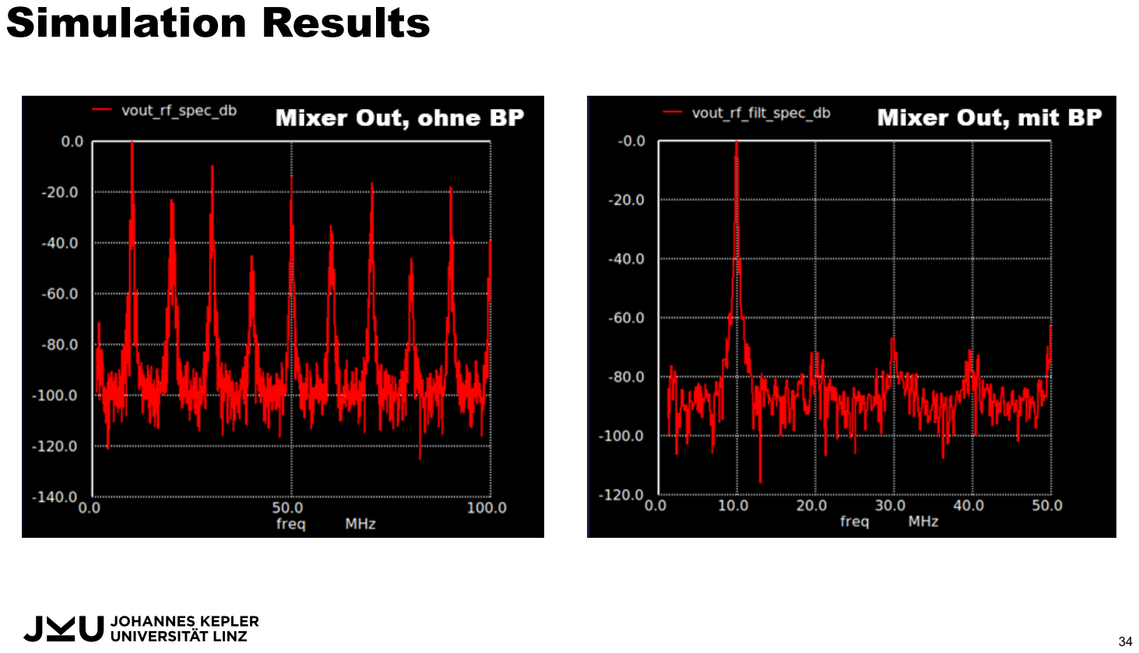
[picture p40: page 35]

# External 3rd Order LC Bandpass Filter

## Design in „Elsie”

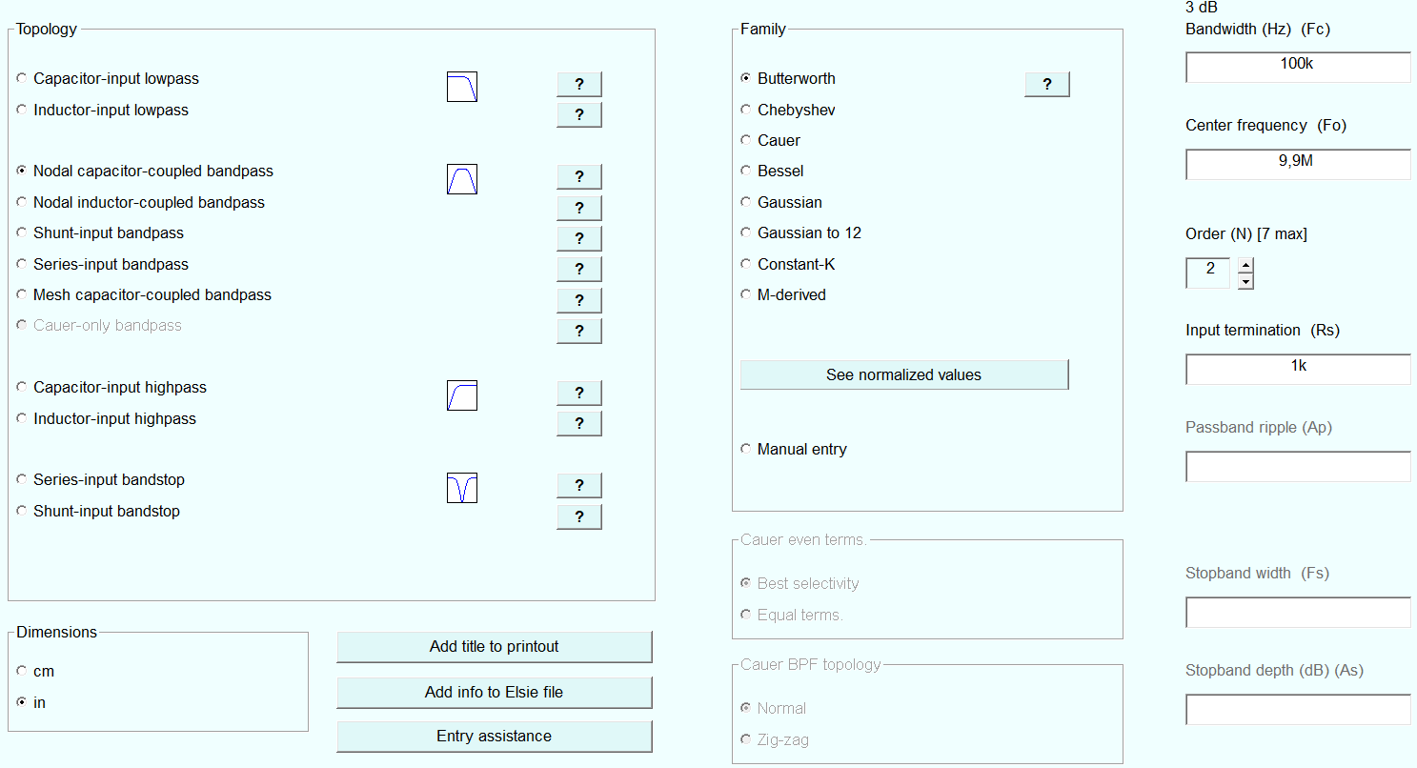
[picture p41: figure]

## Schematic

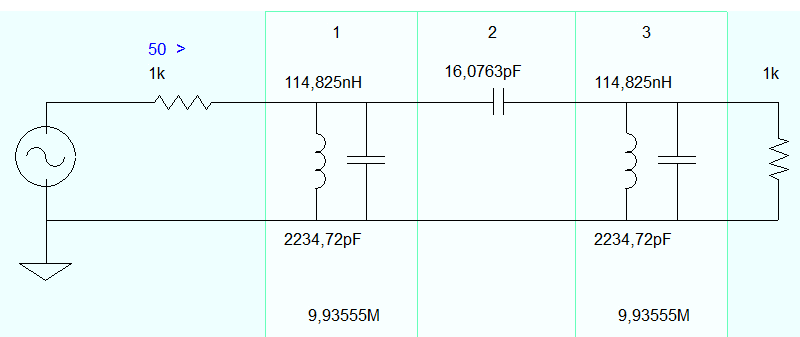
[picture p42: figure]

## Simulation Results

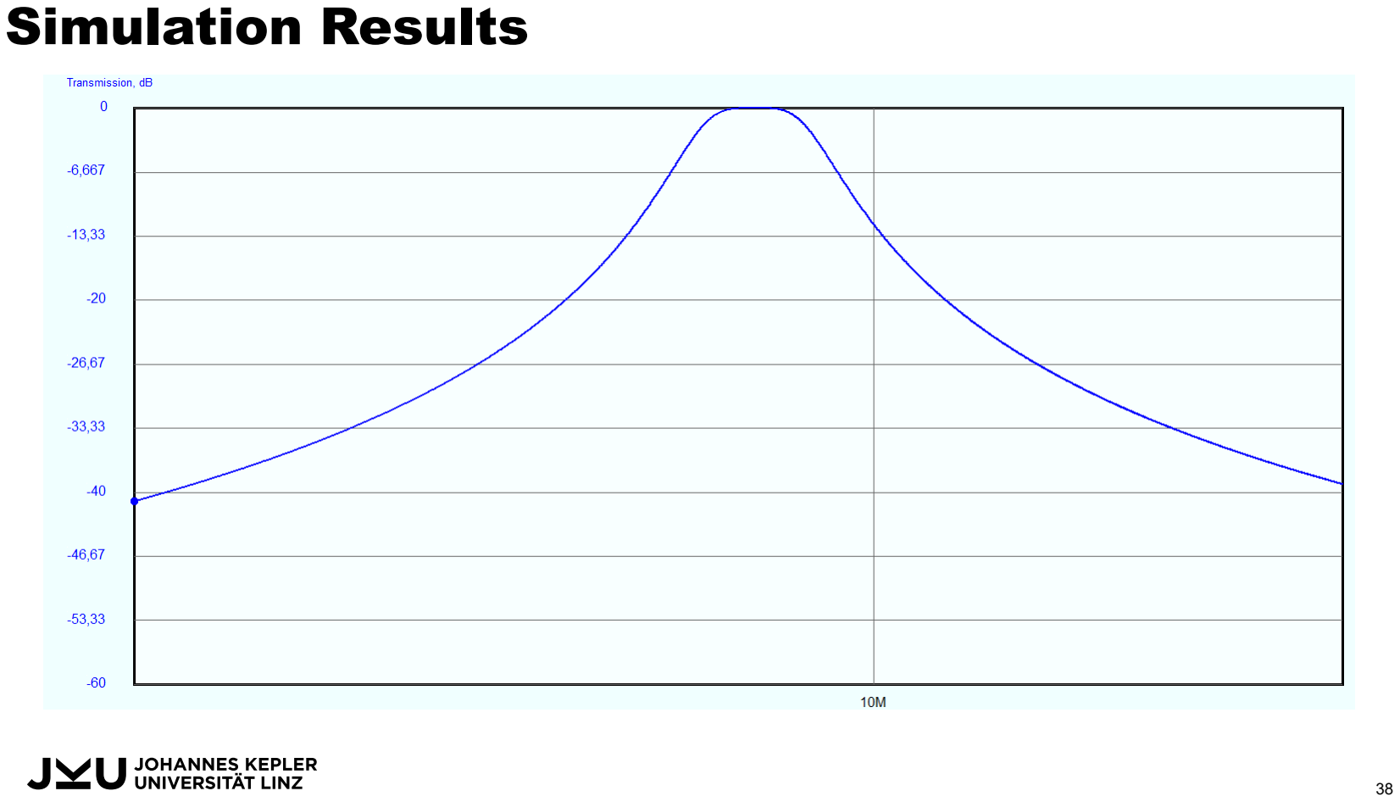
[picture p43: page 39]

## Simulation Results

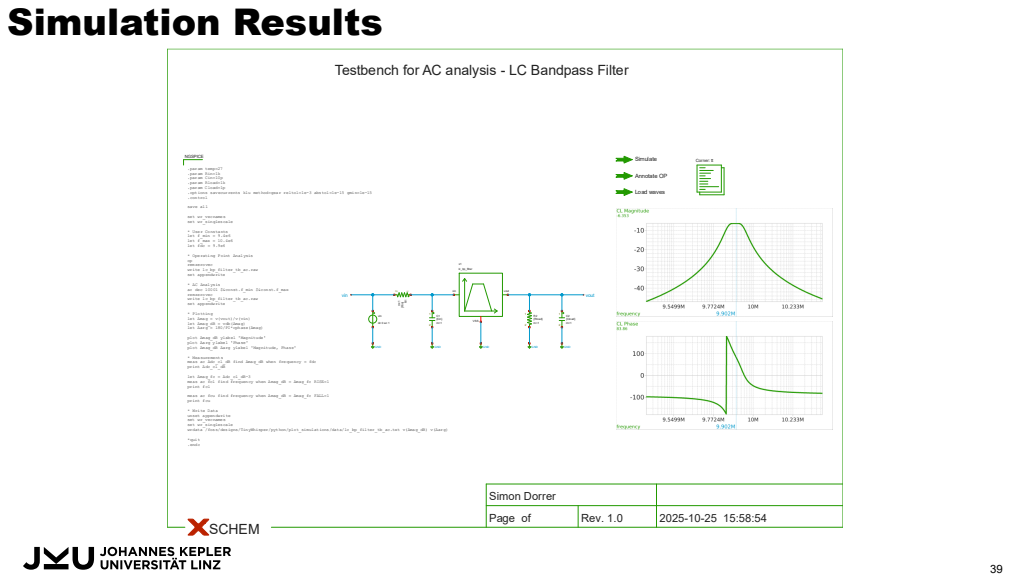
[picture p44: page 40]

# IQ Modulator

## Schematic

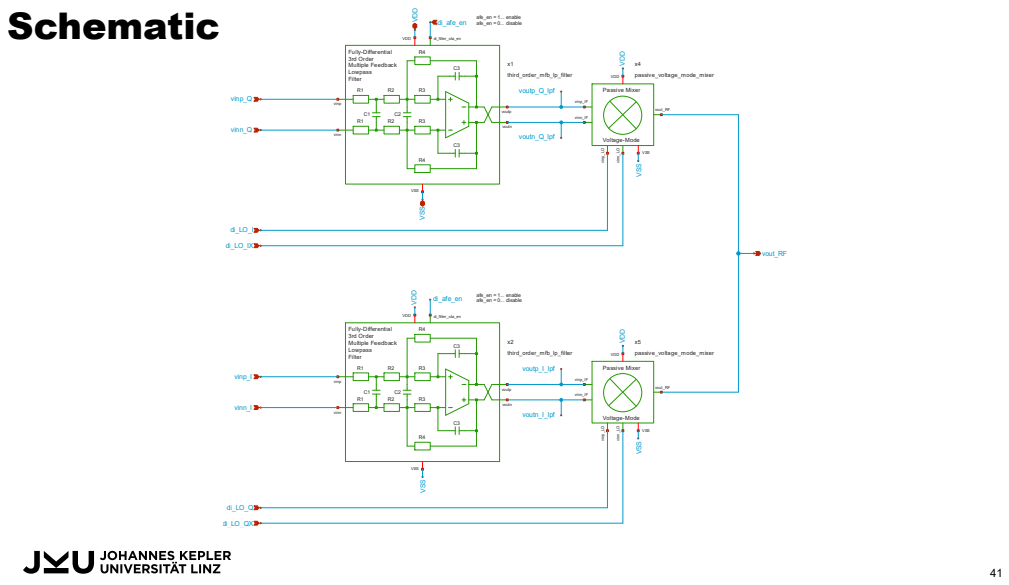
[picture p45: page 42]

## Layout

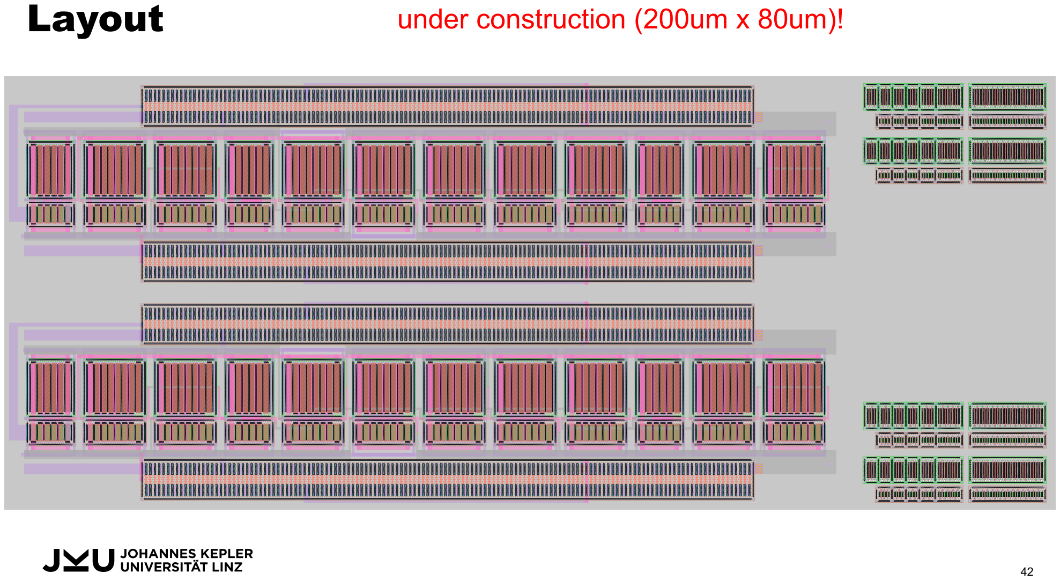
[picture p46: page 43]

under construction (200um x 80um)!

## Transient Testbench

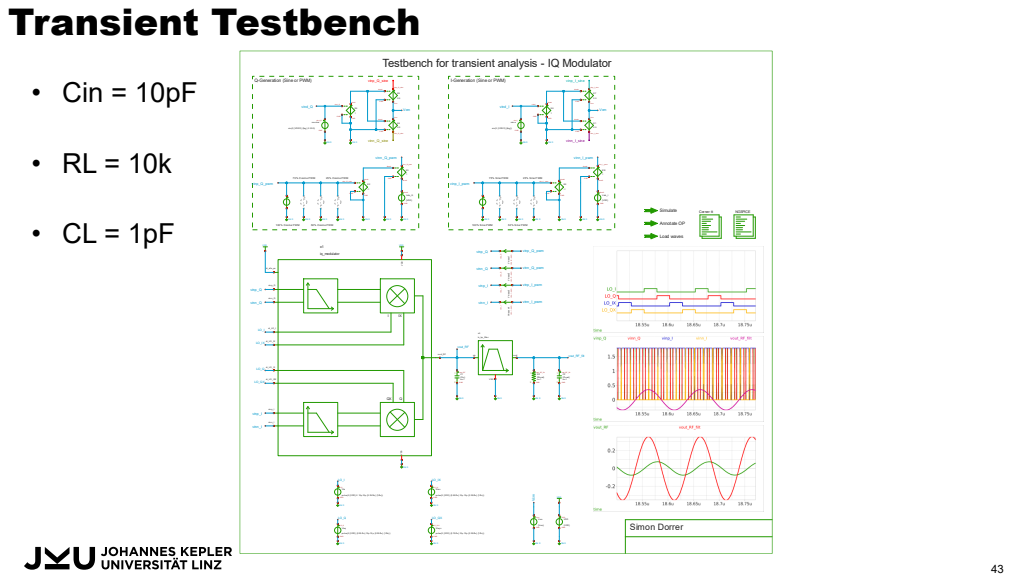
[picture p47: page 44]
• Cin = 10pF

## Simulation Results

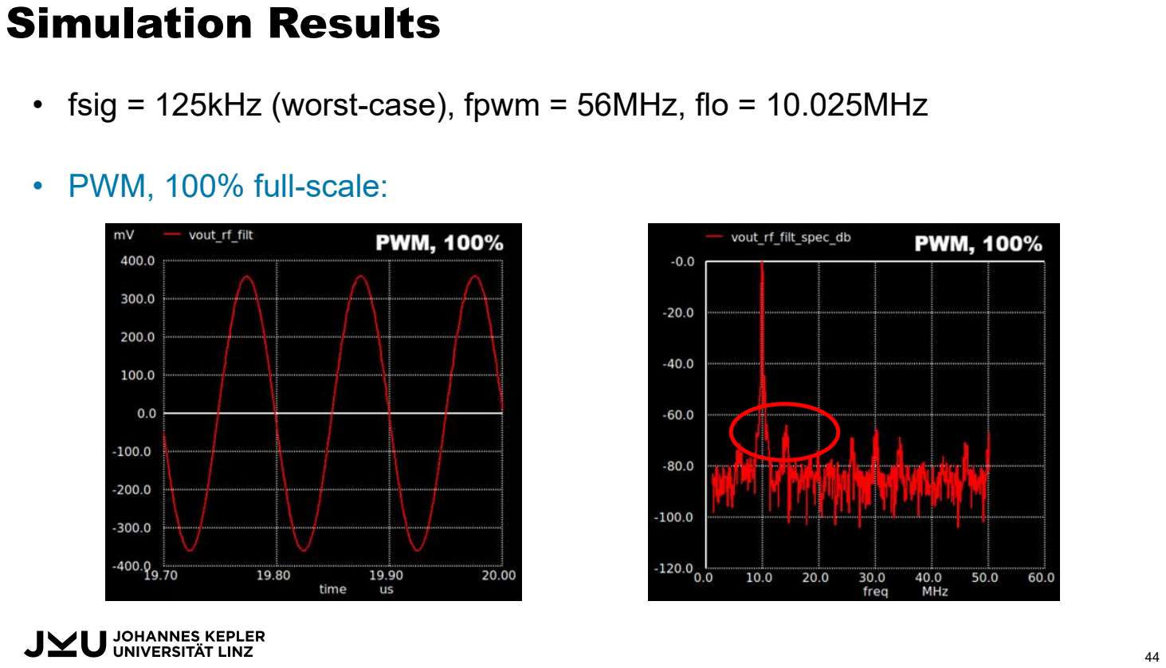
[picture p48: page 45]

- fsig = 125kHz (worst-case), fpwm = 56MHz, flo = 10.025MHz
- PWM, 100% full-scale:

## Simulation Results

- fsig = 125kHz (worst-case), fpwm = 56MHz, flo = 10.025MHz
- PWM, 100% full-scale:

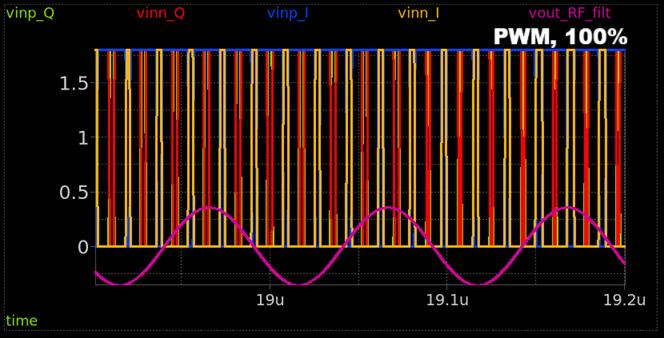
[picture p49: figure]

## Simulation Results

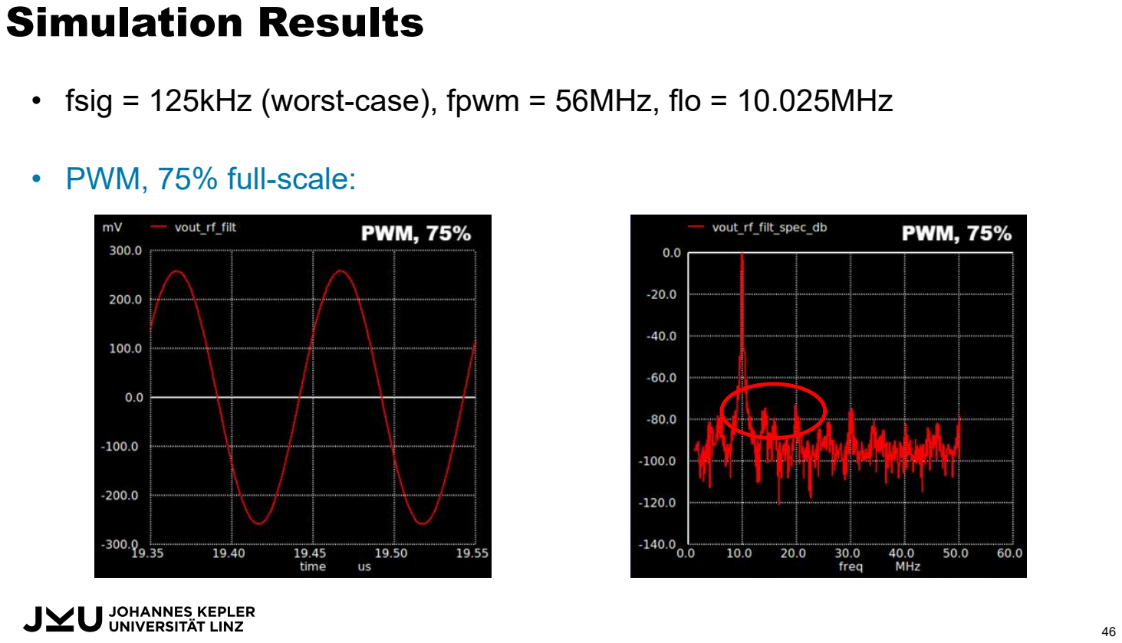
[picture p50: page 47]

- fsig = 125kHz (worst-case), fpwm = 56MHz, flo = 10.025MHz
- PWM, 75% full-scale:

## Simulation Results

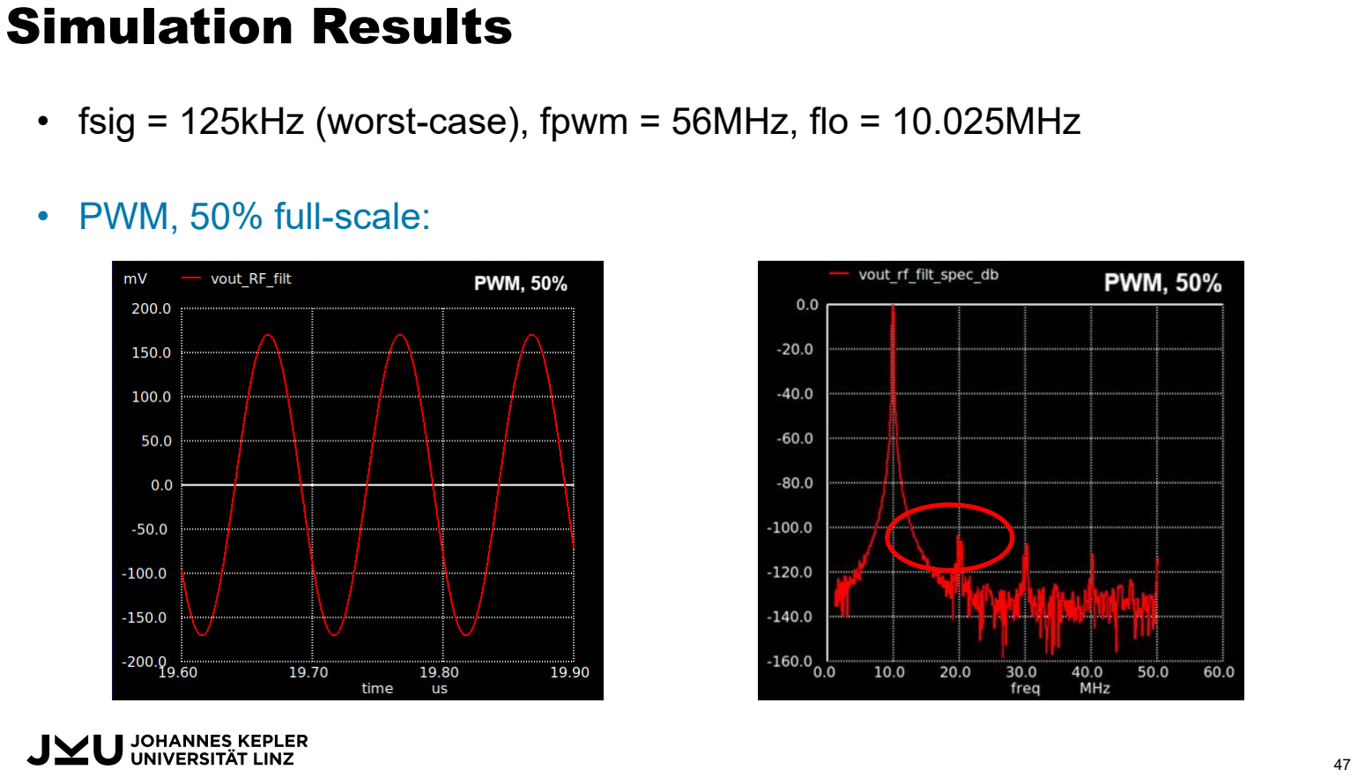
[picture p51: page 48]

- fsig = 125kHz (worst-case), fpwm = 56MHz, flo = 10.025MHz
- PWM, 50% full-scale:

# Digital Core

## Layout – LibreLane / OpenROAD GUI

- ToDo

## Iterative CORDIC

- 10-Bit
- 10+1 Iterations
- 125kHz (worst-case)
- fs = 50MHz (later 56MHz)

## Iterative CORDIC

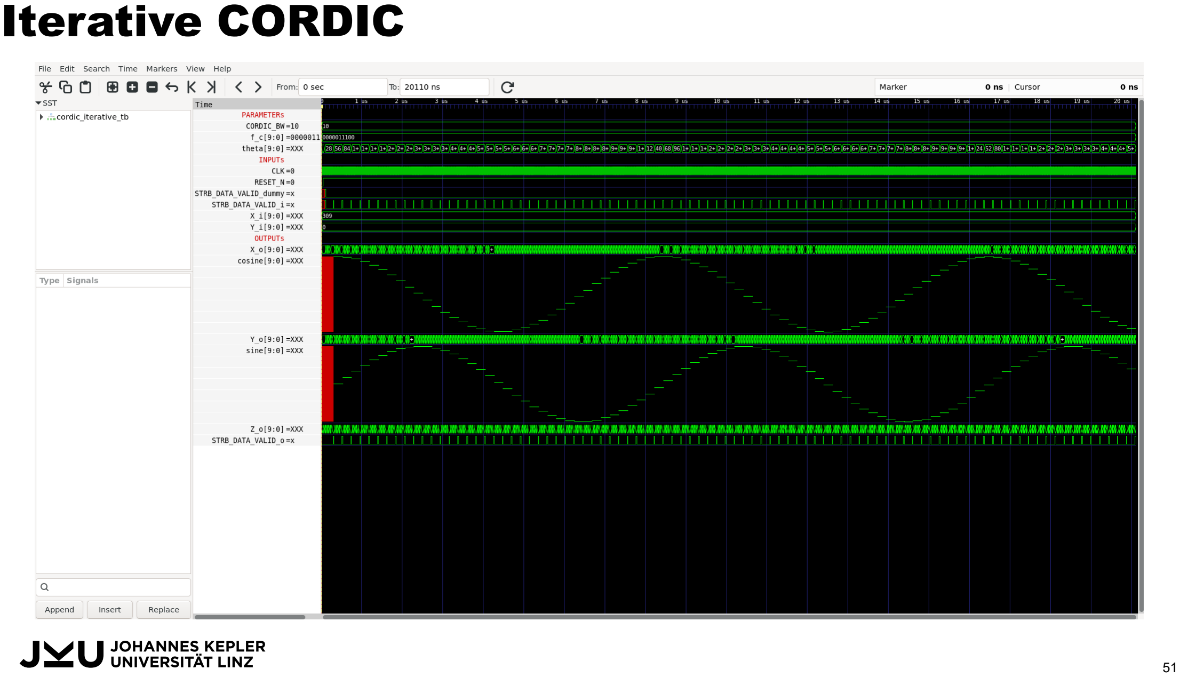
[picture p52: page 52]

## Simulation Results

- ToDo

# WSPR Transmitter

## Schematic

## Layout

- ToDo

## Simulation Results

- ToDo

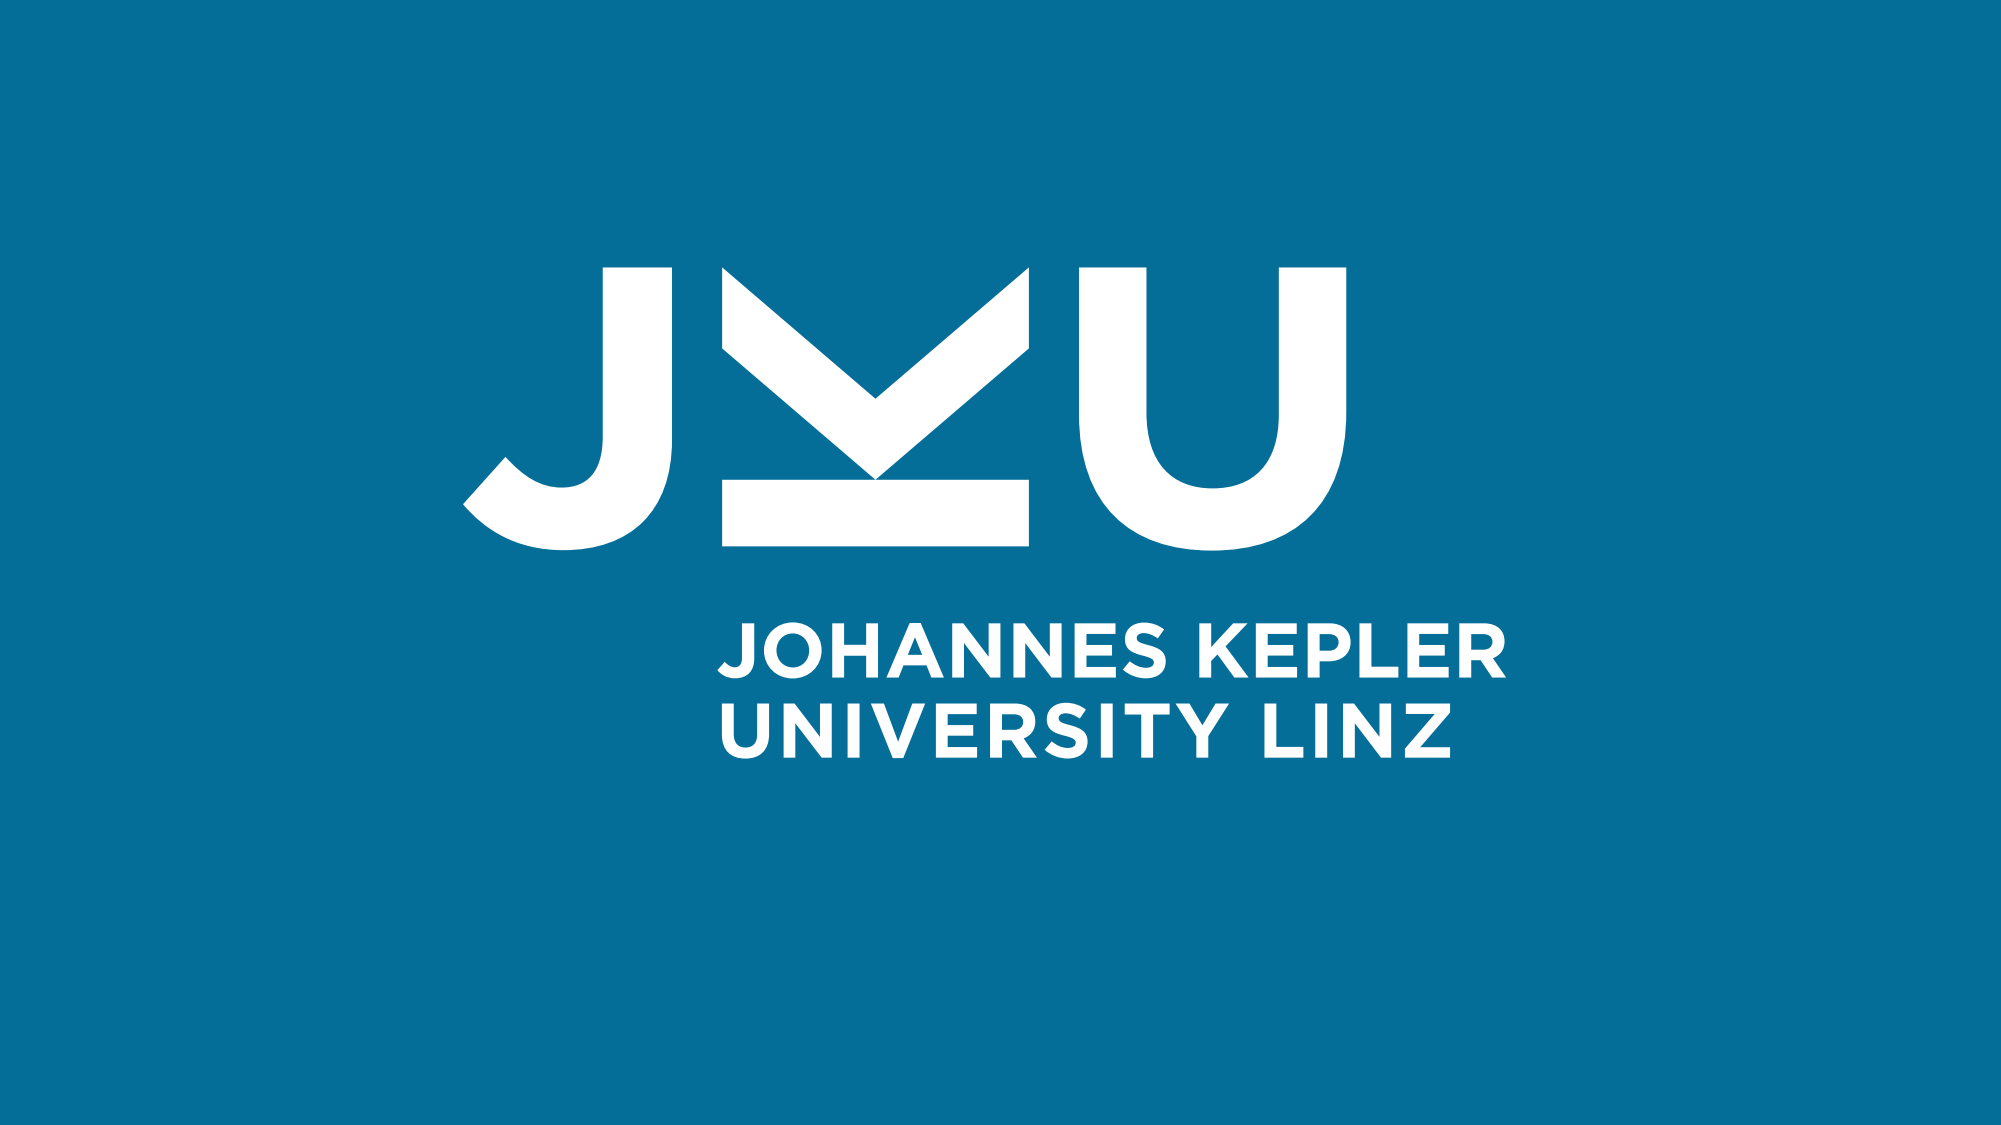
[picture p53: page 58]
