iic-jku/TinyWhisper/doc/fig/fec.tex

\documentclass{standalone}
\usepackage{circuitikz}

\begin{document}
    \begin{circuitikz}
        \tikzset{
            mybox/.style={
                draw, 
                minimum width=0.5cm, 
                minimum height=0.5cm,
                outer sep=0pt
            },
            myxor/.style={
                draw, 
                circle,
                outer sep=0pt,
                inner sep=0pt
            }
        }
        % 31 30 29 28 27 26 25 24 23 22 21 20 19 18 17 16 15 14 13 12 11 10 9  8  7  6  5  4  3  2  1  0
        % 1  1  1  1  0  0  1  0  1  1  0  1  0  0  0  0  0  1  0  1  0  0  1  1  0  1  0  1  0  0  0  1
        \draw(0,0) node[mybox](ra0){};
        \foreach \i in {1,...,31} {
            \draw(ra\the\numexpr\i-1\relax.west) node[mybox, anchor=east] (ra\i) {};
        }

        \foreach \i in {6,8,9,12,14,20,22,23,25,28,29,30,31} {
            \draw[-Triangle](ra\i.north)  to [short] ++(0,1) node[myxor, anchor=south](xa\i){+};
        }

        \foreach \i/\j in {6/8, 8/9, 9/12, 12/14, 14/20, 20/22, 22/23, 23/25, 25/28, 28/29, 29/30, 30/31} {
            \draw[-Triangle] (xa\i.west) -- (xa\j.east);
        }

        \draw[-Triangle](ra0) |- (xa6.east);

        \draw[Triangle-](ra0.east) -- ++(0.5,0) coordinate(mid) -- ++(0.5,0) node[anchor=west](){input};

        % 31 30 29 28 27 26 25 24 23 22 21 20 19 18 17 16 15 14 13 12 11 10 9  8  7  6  5  4  3  2  1  0
        %  1  1  1  0  0  1  0  0  0  1  1  0  0  0  0  1  0  0  1  1  1  1 0  0  0  1  0  0  0  1  1  1
        \draw(0,-1) node[mybox](rb0){};
        \foreach \i in {1,...,31} {
            \draw(rb\the\numexpr\i-1\relax.west) node[mybox, anchor=east] (rb\i) {};
        }

        \foreach \i in {1,2,6,10,11,12,13,16,21,22,26,29,30,31} {
            \draw[-Triangle](rb\i.south)  to [short] ++(0,-1) node[myxor, anchor=north](xb\i){+};
        }

        \foreach \i/\j in {1/2, 2/6, 6/10, 10/11, 11/12, 12/13, 13/16, 16/21, 21/22, 22/26, 26/29, 29/30, 30/31} {
            \draw[-Triangle] (xb\i.west) -- (xb\j.east);
        }

        \draw[-Triangle](rb0) |- (xb1.east);

        \draw[-Triangle](mid) to [short, -*] ++(0,0) |- (rb0.east);

        \draw(ra31) to [open, name=foo] (rb31);
        \draw(foo) ++(-1.5,0) node[spdt](spdt){};
        \draw(spdt.out 1) |- (xa31.west);
        \draw(spdt.out 2) |- (xb31.west);
        \draw(spdt.in) to [short] ++(-1,0) node[anchor=south](){output};

    \end{circuitikz}
\end{document}
