iic-jku/TinyWhisper/ihp130/doc/pinout.pdf

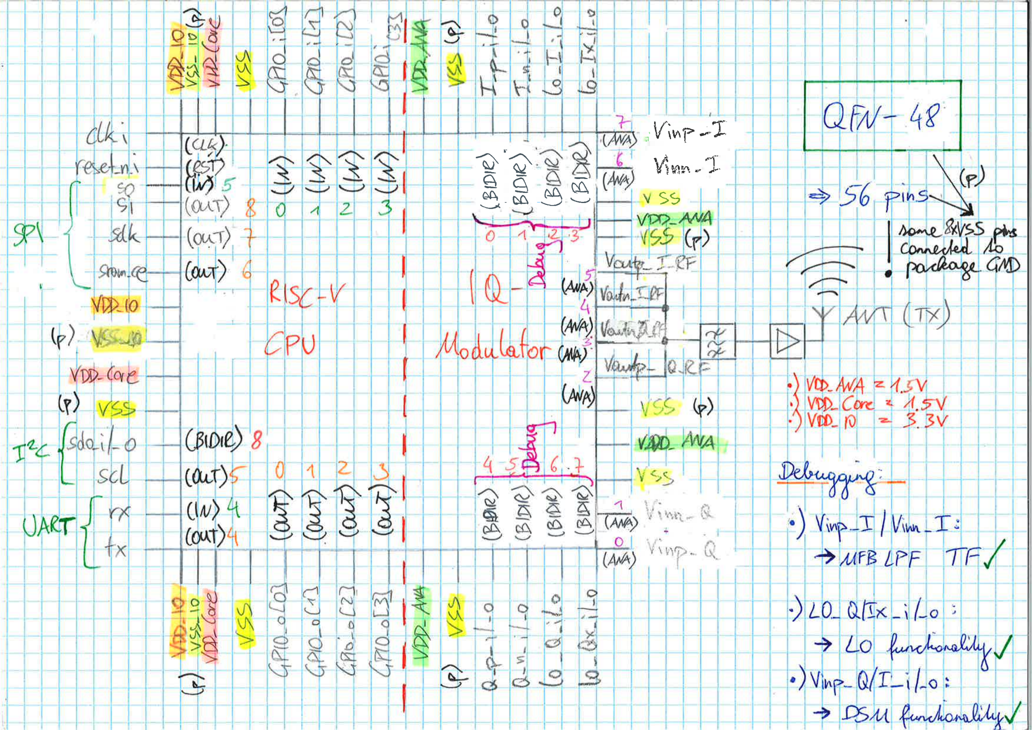
[picture p54: page 1]

\J' G

AA

q2' G
bA AA EA

; \y'i*p .-T,

'v{i'nr*.

- T-
99
