iic-jku/TinyWhisper/sky130/macros/iqmod/doc/wspr_tx_iqmod_mfb_lpf_floorplan.pdf

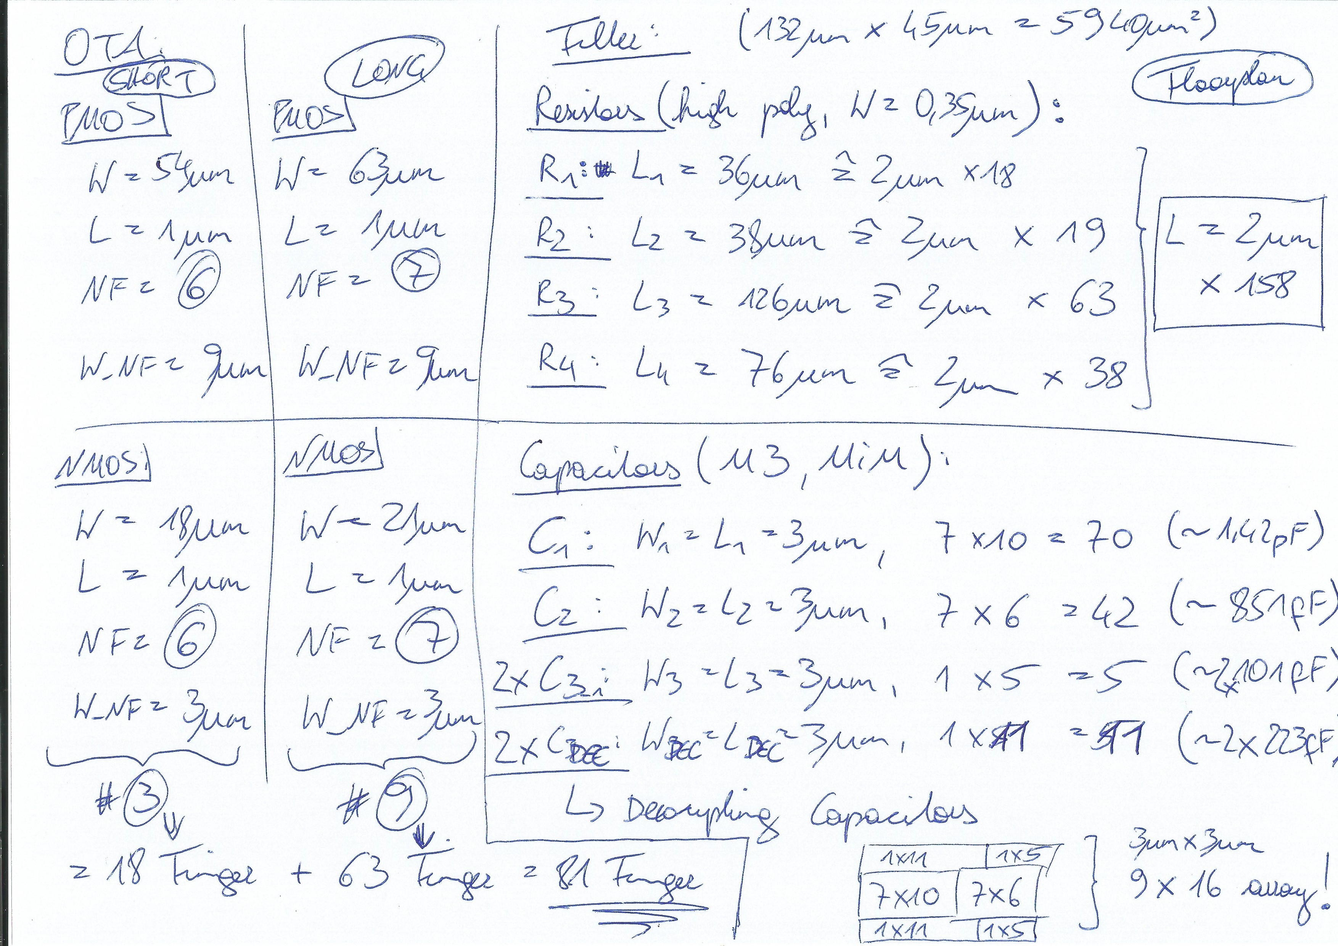
[picture p55: page 1]
