iic-jku/TinyWhisper/sky130/macros/iqmod/scripts/plot_simulations/figures/amplifier/amplifier_core_simplified_tb_ac_ol.pdf

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

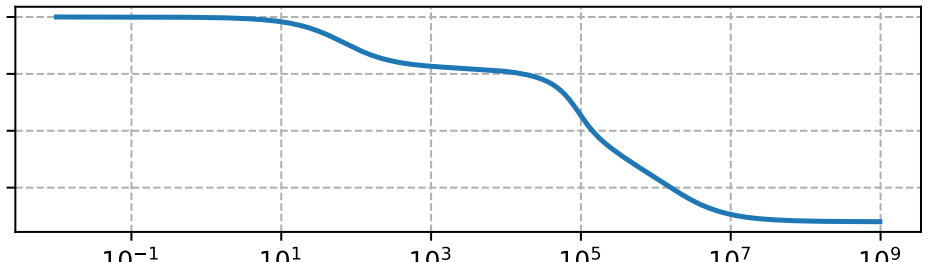
[picture p56: figure]
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
