iic-jku/TinyWhisper/ihp130/release/v.1.0.0/doc/SumbissiontoOpen-Silicon-MPW-IHP.pdf

## Open-Silicon MPW March 2026 Documentation Summary and Submission Guidance

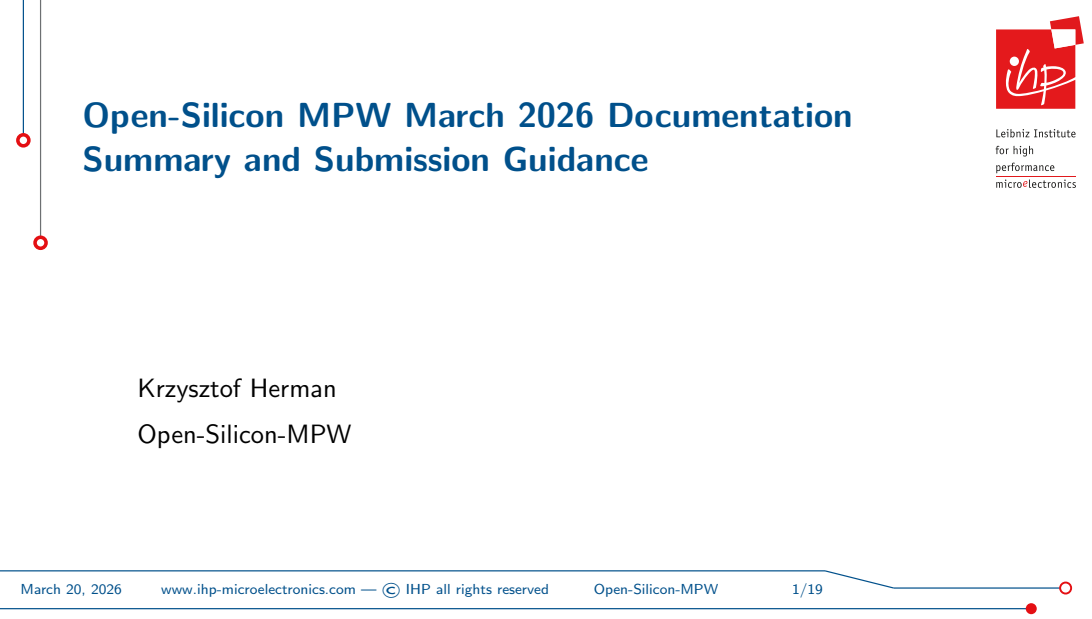
[picture p57: page 1]
March 20, 2026; www.ihp-microelectronics.com — © IHP all rights reserved; Open-Silicon-MPW; Krzysztof Herman

Open-Silicon-MPW

https://github.com/IHP-GmbH/Open-Silicon-MPW

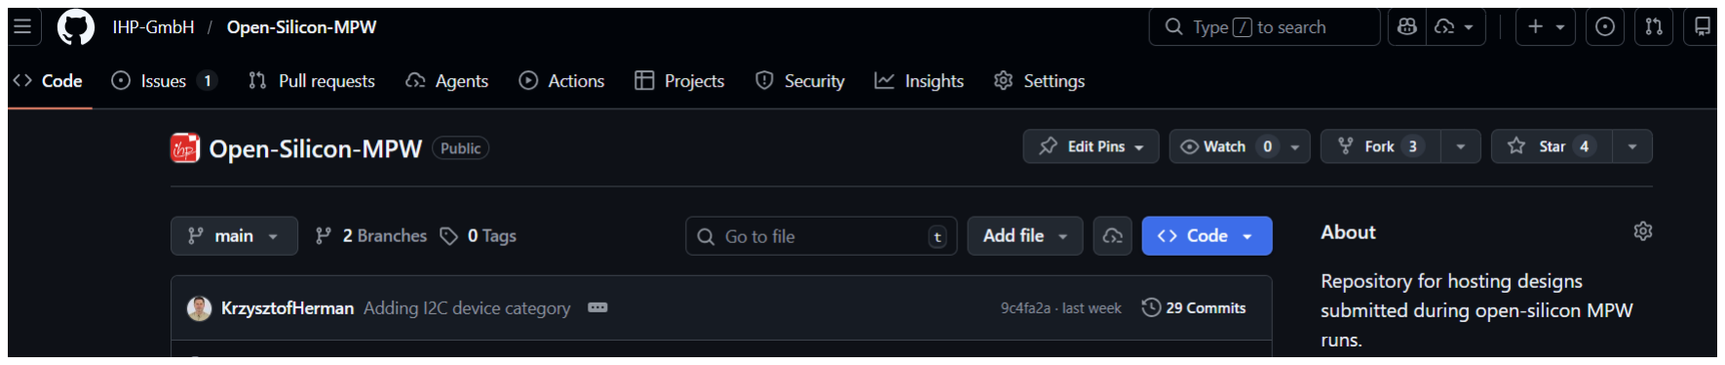
[picture p58: figure]

Aggregates production-ready IPs as submodules
dedicated locations for each MPW run (March2026, July2026 ...)

IP development happens in standalone repositories
Submodule requests include the IP under certain category
Four categories: Analog, Digital, RF, Mixed-Signal
March 20, 2026 | www.ihp-microelectronics.com — © IHP all rights reserved | Open-Silicon-MPW | 2/19

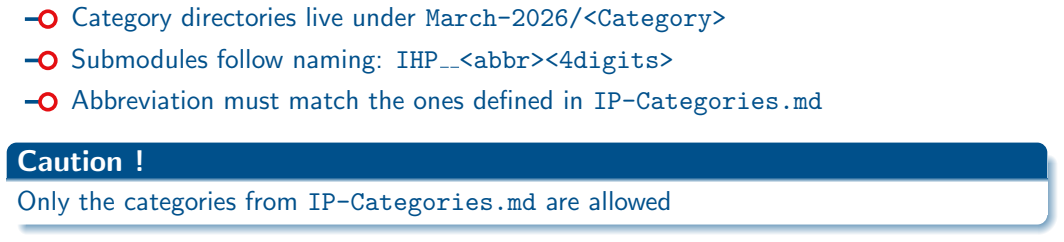
[picture p59: figure]
Category directories live under March-2026/<Category>; Submodules follow naming: IHP <abbr><4digits>; Caution !

Abbreviation must match the ones defined in IP-Categories.md

Only the categories from IP-Categories.md are allowed

March 20, 2026 | www.ihp-microelectronics.com — © IHP all rights reserved | Open-Silicon-MPW | 3/19

IHP OTA1336

Subcategories are standardized and mapped to abbreviations
Abbreviations are used in the top-level IP name and repo path
New subcategories are requested via GitHub issue
- dependencies
- doc
- measurements
- OTA1336-main
- README.md
- release
March 20, 2026 | www.ihp-microelectronics.com — © IHP all rights reserved | Open-Silicon-MPW | 4/19

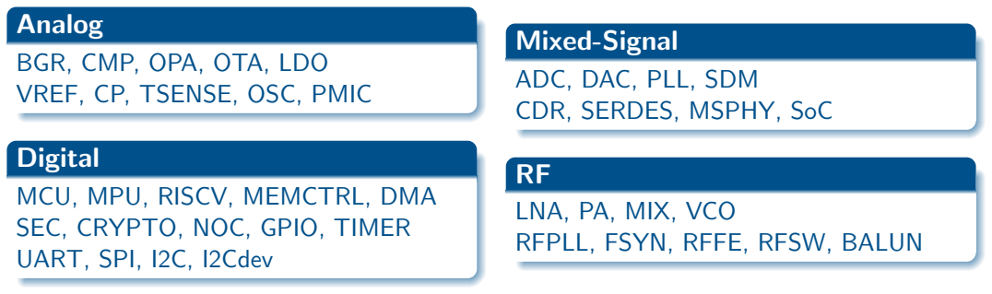
[picture p60: figure]
Analog; BGR, CMP, OPA, OTA, LDO VREF, CP, TSENSE, OSC, PMIC; Digital; MCU, MPU, RISCV, MEMCTRL, DMA SEC, CRYPTO, NOC, GPIO, TIMER UART, SPI, I2C, I2Cdev; Mixed-Signal; ADC, DAC, PLL, SDM CDR, SERDES, MSPHY, SoC; LNA, PA, MIX, VCO RFPLL, FSYN, RFFE, RFSW, BALUN

March 20, 2026 | www.ihp-microelectronics.com — © IHP all rights reserved | Open-Silicon-MPW | 5/19

Select category and subcategory abbreviation
Clone Open-Silicon-MPW to get gen structure.py

Generate IP repo: python3 gen structure.py IHP <subcategory>

Implement design and keep structure intact
Maintain doc/info.json and TRL document
Publish repo and optionally sync shared workflows
March 20, 2026 | www.ihp-microelectronics.com — © IHP all rights reserved | Open-Silicon-MPW | 6/19

<IP>-main/ with layout, netlist, schematic, verification
doc/ with Datasheet, Specification, info.json, TRL
- dependencies/
- doc/
- measurements/
- OTA1336-main/

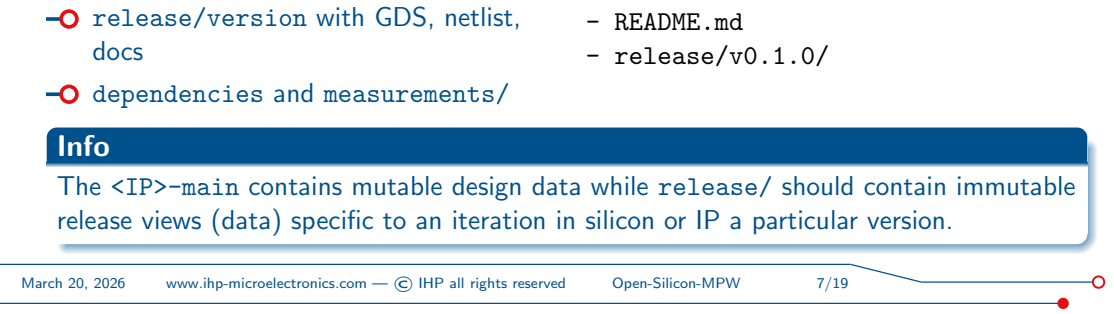
[picture p61: figure]
release/version with GDS, netlist, docs; dependencies and measurements/; - README.md - release/v0.1.0/; Info

The <IP>-main contains mutable design data while release/ should contain immutable release views (data) specific to an iteration in silicon or IP a particular version.

March 20, 2026 | www.ihp-microelectronics.com — © IHP all rights reserved | Open-Silicon-MPW | 7/19

python3 gen structure.py IHP <subcategory>

Clone Open-Silicon-MPW to get gen structure.py

Copy the gen structure.py file to the place you want to store your IP Generate the structure by executing the script
Distribute the files and keep structure intact
March 20, 2026 | www.ihp-microelectronics.com — © IHP all rights reserved | Open-Silicon-MPW | 8/19

The repository and data distribution does not imply a workflow flow. Take your data from your flow and distribute it according the directory structure. In the documentation describe your flow.

Design data

The design data are segmented by function (schematic, layout, netlist etc.) and at the very end by tool specific views (klayout, magic, xschem, Qucs-S).

Follow the naming convention of your IP. All the main views of your final cell should have the same name <IP> with the corresponding extension ie. OTA1336.gds OTA1336.sch.

March 20, 2026 | www.ihp-microelectronics.com — © IHP all rights reserved | Open-Silicon-MPW | 9/19

Caution!
Fill carefully the doc/info.json file.

assign the license
provide the link of your repository

provide the pdk commit as ”pdk version”
specify process: SG13G2, SG13CMOS5L,
information about the layout (top cell name, x and y size of the seal ring) provide relative paths to the final GDS and spice/CDL netlist used for LVS (it is critical for automatic checks of DRC and LVS)
March 20, 2026 | www.ihp-microelectronics.com — © IHP all rights reserved | Open-Silicon-MPW | 10/19

TRL checklists help self-evaluate IP maturity
Templates provided for Analog, Mixed-Signal, RF, and Digital Hard IP

self evaluate your design and provide corresponding level in info.json file

March 20, 2026 | www.ihp-microelectronics.com — © IHP all rights reserved | Open-Silicon-MPW | 11/19

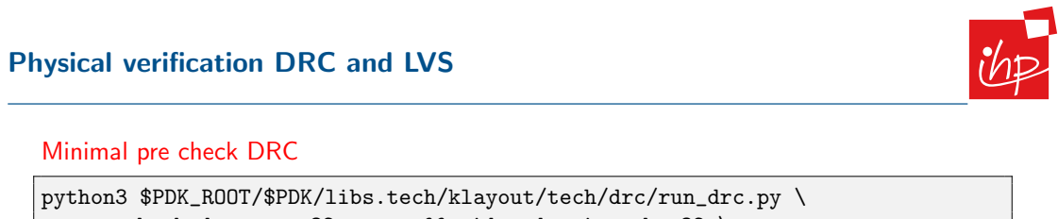
[picture p62: figure]
Physical verification DRC and LVS; Minimal pre check DRC; python3 $PDK_ROOT/$PDK/libs.tech/klayout/tech/drc/run_drc.py \

--precheck_drc --mp=32 --no_offgrid --density_thr=32 \ --no_angle --disable_extra_rules --no_recommended --path=your.gds

Regular DRC

python3 $PDK_ROOT/$PDK/libs.tech/klayout/tech/drc/run_drc.py \ --mp=32 --density_thr=32 --path=your.gds

Regular LVS

python3 $PDK_ROOT/$PDK/libs.tech/klayout/tech/lvs/run_lvs.py --layout=your.gds --layout_netlist=your.cdl

March 20, 2026 | www.ihp-microelectronics.com — © IHP all rights reserved | Open-Silicon-MPW | 12/19

Save a copy of your final gds in under release/v0.1.0/gds/ directory with the following options

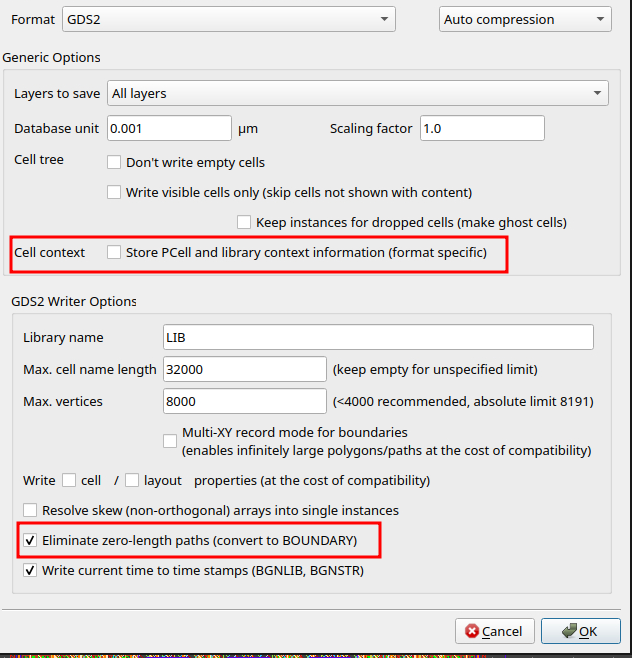
[picture p63: figure]

Save a copy of your final netlist for LVS check in under release/v0.1.0/netlist/ directory

March 20, 2026 | www.ihp-microelectronics.com — © IHP all rights reserved | Open-Silicon-MPW | 13/19

Github repository setup

Go to your github account and create a repository named using the name: IHP <abbr><4digits>

On your local machine inside your project execute:

git init
git add .
git commit -s -m "Initial␣commit"
git branch -M main
git remote add origin https://github.com/<org>/<repo>.git git push -u origin main
March 20, 2026 | www.ihp-microelectronics.com — © IHP all rights reserved | Open-Silicon-MPW | 14/19

Workflow check
The generator script automatically sets up a check-workflow-sync.yml script which will synchronize the central workflows with your repository

You need to activate it!

Workflow activation
manually copy the corresponding workflow from .github/workflows-staged/ to .github/workflows/
March 20, 2026 | www.ihp-microelectronics.com — © IHP all rights reserved | Open-Silicon-MPW | 15/19

Open an issue on Open-Silicon-MPW github webpage with the title: IHP <abbr><4digits> and the following text:

## Submodule request for March-2026 Open-Silicon MPW

### .gitmodules snippet

[submodule "March-2026/<Category>/IHP__<subcategory-abbrev><4digits>"] path = March-2026/<Category>/IHP__<subcategory-abbrev><4digits>
url = https://github.com/<org>/<repo>.git

The hard deadline for this activity is 30-th March 2026, 8 AM CET time if you can do do it earlier

March 20, 2026 | www.ihp-microelectronics.com — © IHP all rights reserved | Open-Silicon-MPW | 16/19

Instantiate a seal-ring around your design
Generate fillers
Clean up DRC errors and make sure that the waived ones are not part of the precheck.
Save your GDS under release/version/gds directory (follow naming convention) using specified klayout options.
Update doc/info.json file (top cell name, sealring size, gds path)

setup repository on github
Rise an issue on the Open-Silicon-MPW repository requesting submission before 30-th March 8 AM CET
March 20, 2026 | www.ihp-microelectronics.com — © IHP all rights reserved | Open-Silicon-MPW | 17/19

By submitting to the open-source silicon MPW program you agree upon the following points:
1. Open Source Licensing Requirement The Participant agrees that all design data submitted for fabrication under this MPW program must be released to the public under the Apache License, Version 2.0 on dedicated Github repository of provider. This includes, but is not limited to:
RTL, layout, GDSII, and associated design files

Documentation and design scripts
Any PDK-specific modifications or enhancements (where applicable)

The release must be completed latest before estimated shipment date of the samples.

March 20, 2026 | www.ihp-microelectronics.com — © IHP all rights reserved | Open-Silicon-MPW | 18/19

2. Measurement and Evaluation Transparency
Document and publish all post-silicon measurement data and evaluation results on the same dedicated Github repository as design data.

This needs to include clear measurement procedures, test setups, and associated test software or scripts where applicable.

March 20, 2026 | www.ihp-microelectronics.com — © IHP all rights reserved | Open-Silicon-MPW | 19/19

## Thank you for your attention!

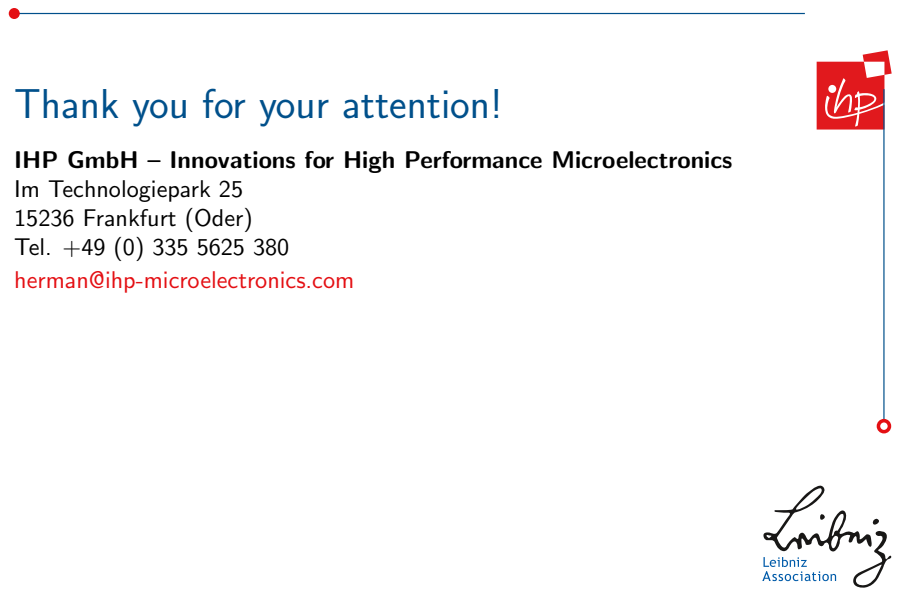
[picture p64: page 20]

IHP GmbH – Innovations for High Performance Microelectronics
Im Technologiepark 25
15236 Frankfurt (Oder)
Tel. +49 (0) 335 5625 380
herman@ihp-microelectronics.com
