iic-jku/TinyWhisper/doc/fig/tinywhisper_top_white.png

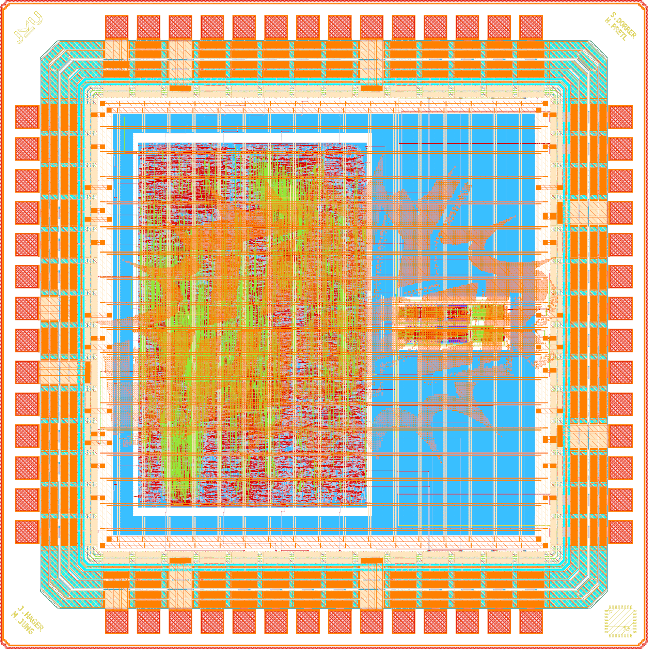
doc/fig/tinywhisper_top_white.png
