iic-jku/TinyWhisper/ihp130/macros/iqmod/render/img/iqmod_top_black.png

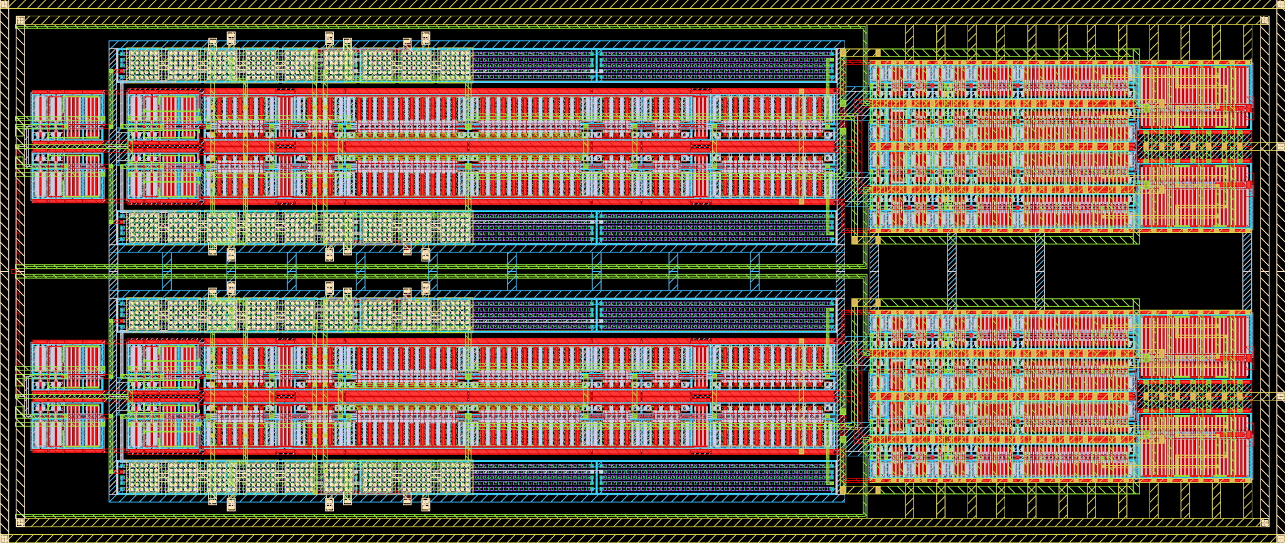
ihp130/macros/iqmod/render/img/iqmod_top_black.png
