iic-jku/TinyWhisper/ihp130/macros/riscv/render/img/riscv_top_black.png

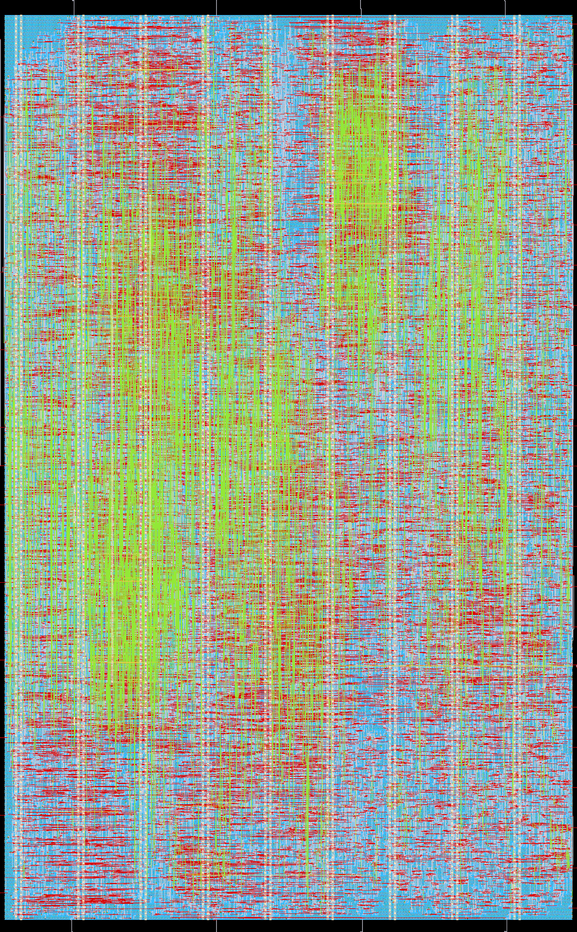
ihp130/macros/riscv/render/img/riscv_top_black.png
