iic-jku/TinyWhisper/ihp130/packaging/render/tinywhisper_bondplan_black.png

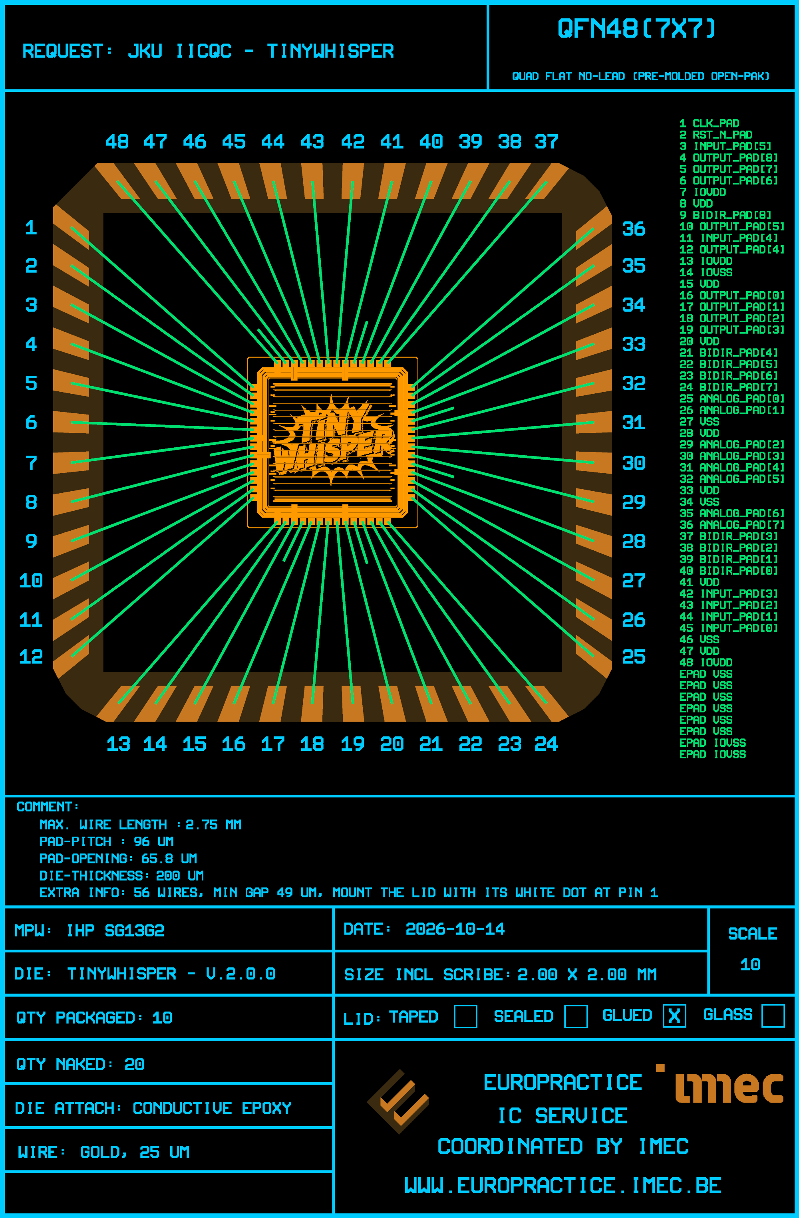
ihp130/packaging/render/tinywhisper_bondplan_black.png
