iic-jku/TinyWhisper/ihp130/release/v.2.0.0/img/tinywhisper_top_librelane.png

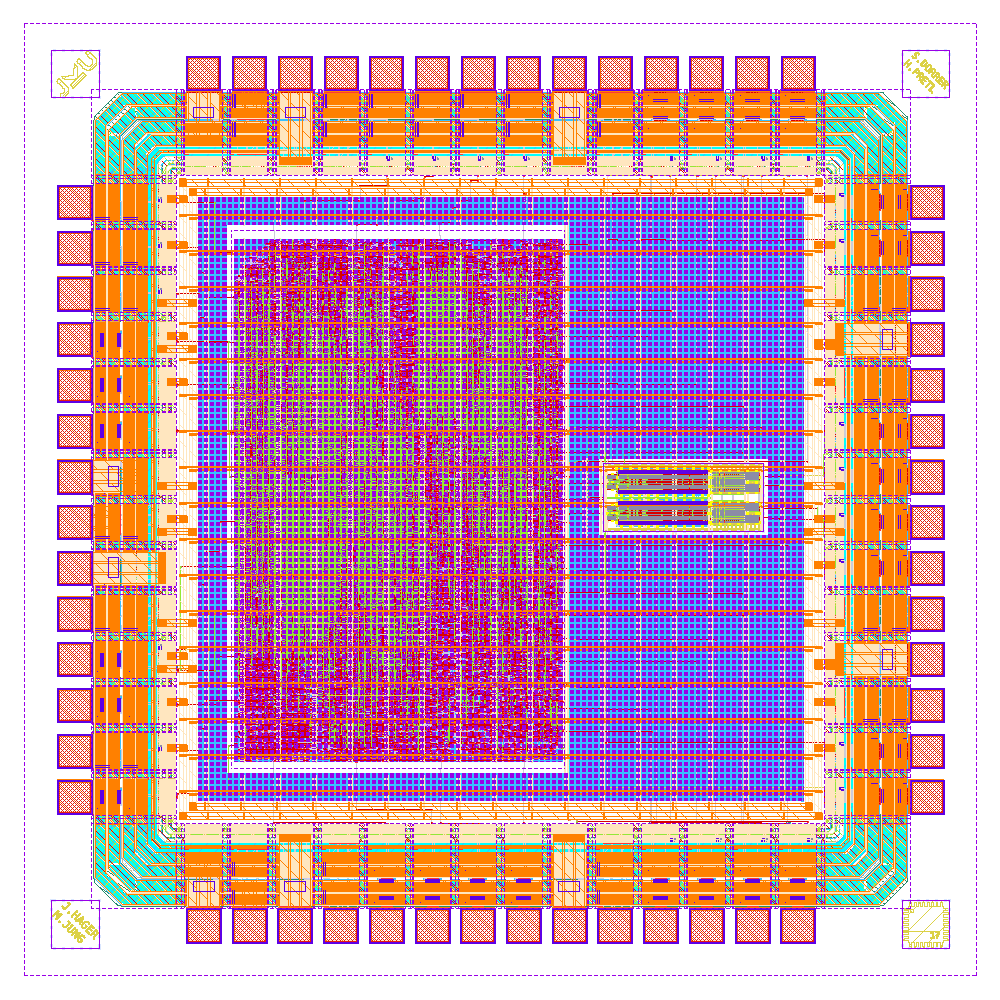
ihp130/release/v.2.0.0/img/tinywhisper_top_librelane.png
