iic-jku/TinyWhisper/ihp130/render/img/tinywhisper_top_black_M5.png

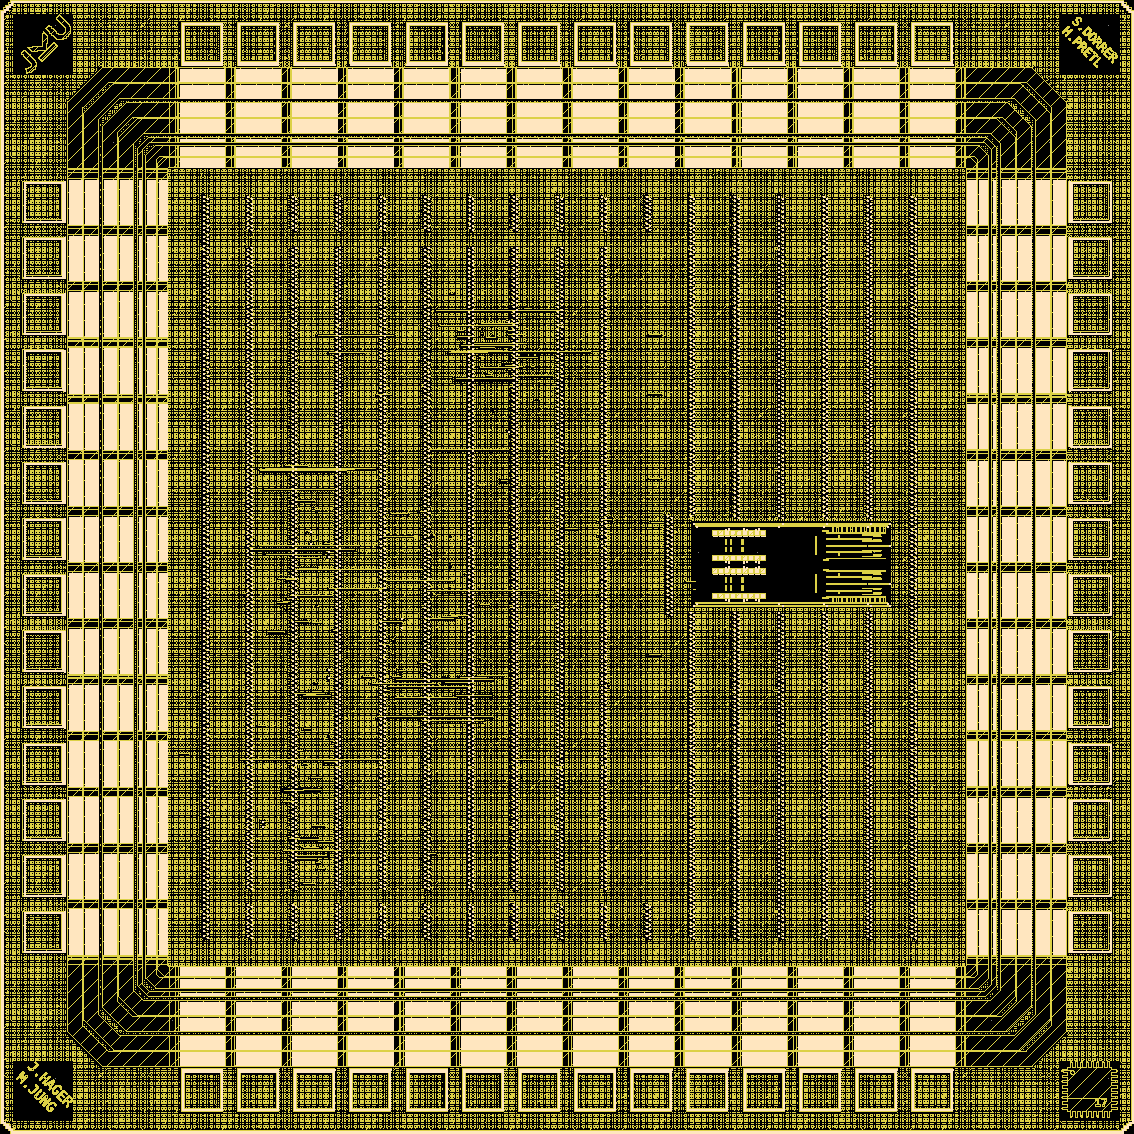
ihp130/render/img/tinywhisper_top_black_M5.png
