iic-jku/TinyWhisper/sky130/macros/iqmod/schematic/figures/simulations/dc_TG_Ron.png

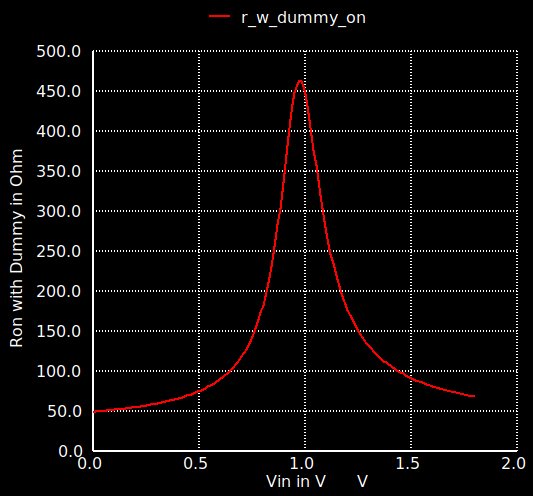
sky130/macros/iqmod/schematic/figures/simulations/dc_TG_Ron.png
