iic-jku/TinyWhisper/sky130/macros/iqmod/schematic/figures/simulations/fft_filter_out_pwm_75%_in.png

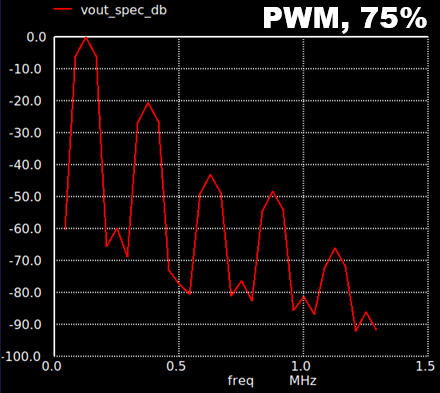
sky130/macros/iqmod/schematic/figures/simulations/fft_filter_out_pwm_75%_in.png
