iic-jku/TinyWhisper/sky130/macros/iqmod/schematic/figures/simulations/fft_iq_modulator_pwm_100%_zoomed.png

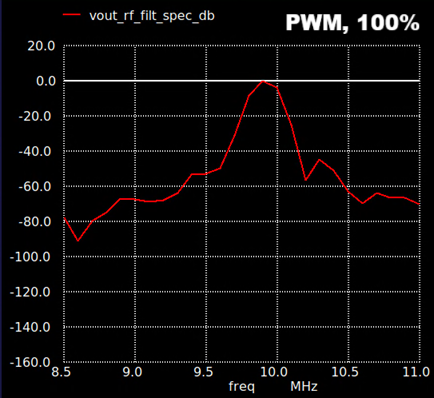
sky130/macros/iqmod/schematic/figures/simulations/fft_iq_modulator_pwm_100%_zoomed.png
