iic-jku/TinyWhisper/sky130/macros/iqmod/schematic/figures/simulations/fft_mixer_out_w_BP.png

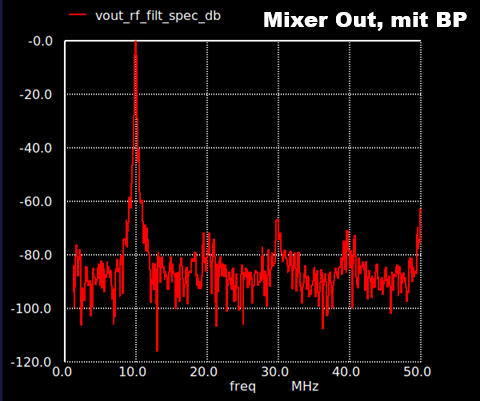
sky130/macros/iqmod/schematic/figures/simulations/fft_mixer_out_w_BP.png
