iic-jku/TinyWhisper/sky130/macros/iqmod/schematic/figures/simulations/fft_mixer_out_w_BP_zoomed.png

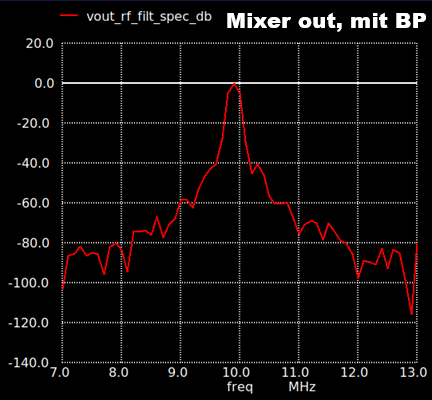
sky130/macros/iqmod/schematic/figures/simulations/fft_mixer_out_w_BP_zoomed.png
