iic-jku/TinyWhisper/sky130/macros/iqmod/schematic/figures/simulations/fft_mixer_out_wo_BP.png

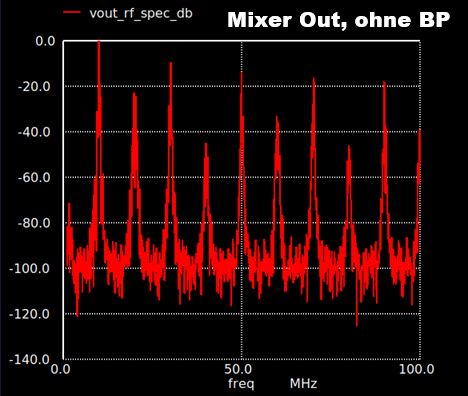
sky130/macros/iqmod/schematic/figures/simulations/fft_mixer_out_wo_BP.png
