iic-jku/TinyWhisper/sky130/macros/iqmod/schematic/figures/simulations/tran_filter_out_pwm_75%_in.png

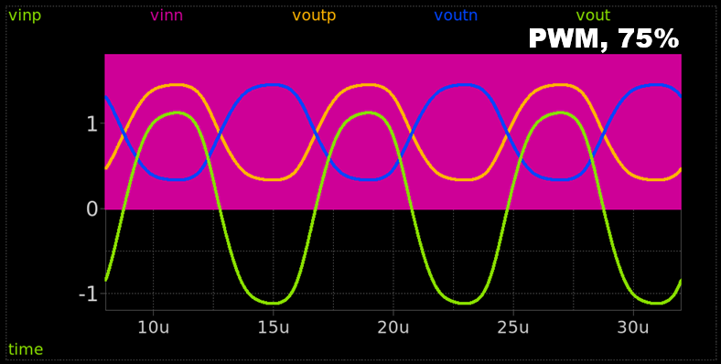
sky130/macros/iqmod/schematic/figures/simulations/tran_filter_out_pwm_75%_in.png
