iic-jku/TinyWhisper/sky130/macros/iqmod/schematic/figures/simulations/tran_iq_modulator_100%.png

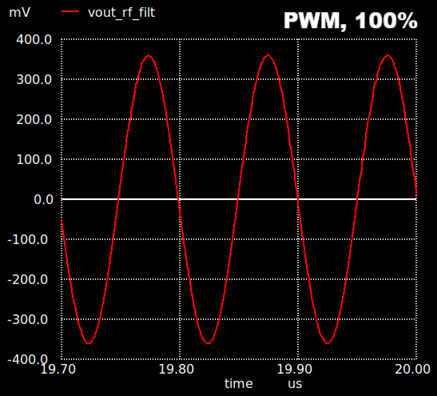
sky130/macros/iqmod/schematic/figures/simulations/tran_iq_modulator_100%.png
