iic-jku/TinyWhisper/sky130/macros/iqmod/schematic/figures/simulations/tran_iq_modulator_pwm_50%.png

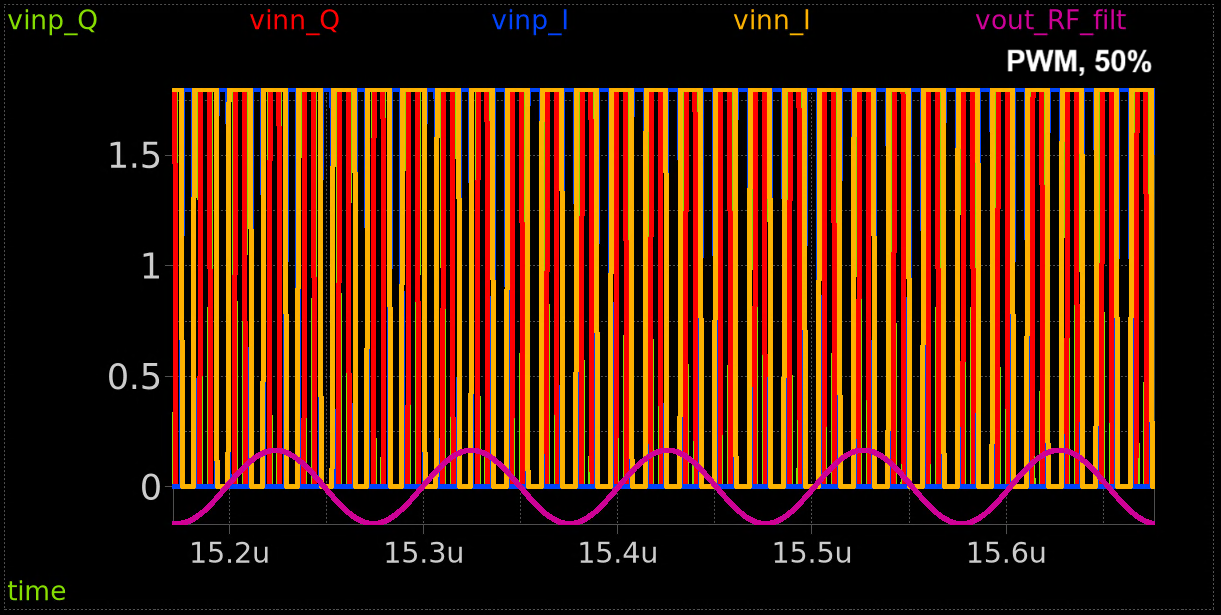
sky130/macros/iqmod/schematic/figures/simulations/tran_iq_modulator_pwm_50%.png
