iic-jku/TinyWhisper/sky130/macros/iqmod/schematic/figures/simulations/wspr_tx_iqmod_mixer_ideal_vs_post-layout_tran_sim.png

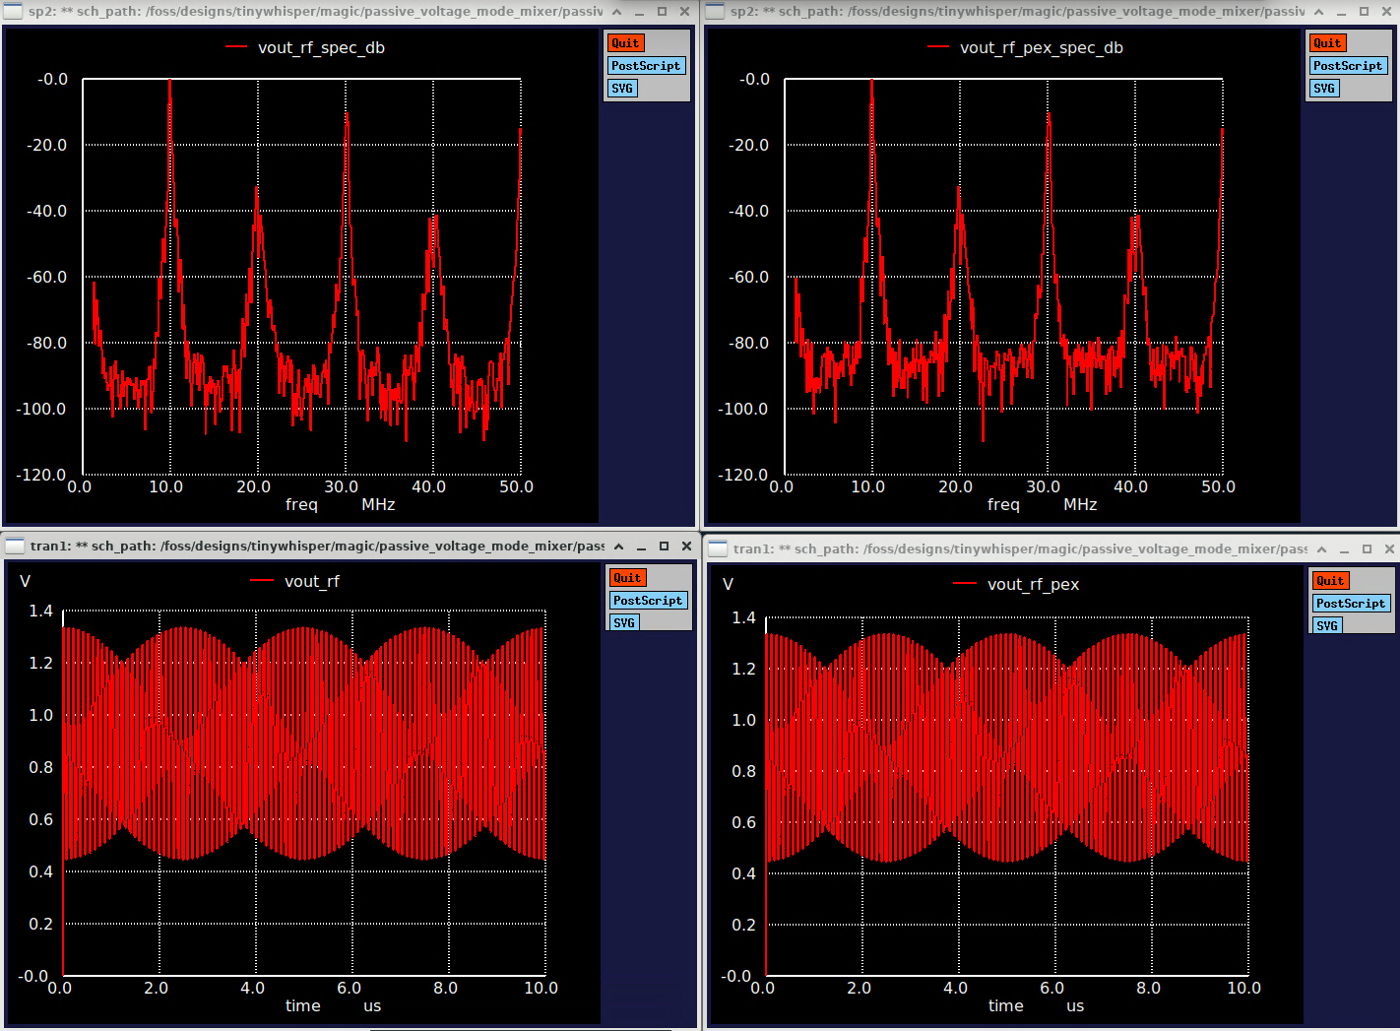
sky130/macros/iqmod/schematic/figures/simulations/wspr_tx_iqmod_mixer_ideal_vs_post-layout_tran_sim.png
