iic-jku/TinyWhisper/sky130/macros/iqmod/schematic/figures/simulations/wspr_tx_top_ideal_vs_post-layout_ac_sim.png

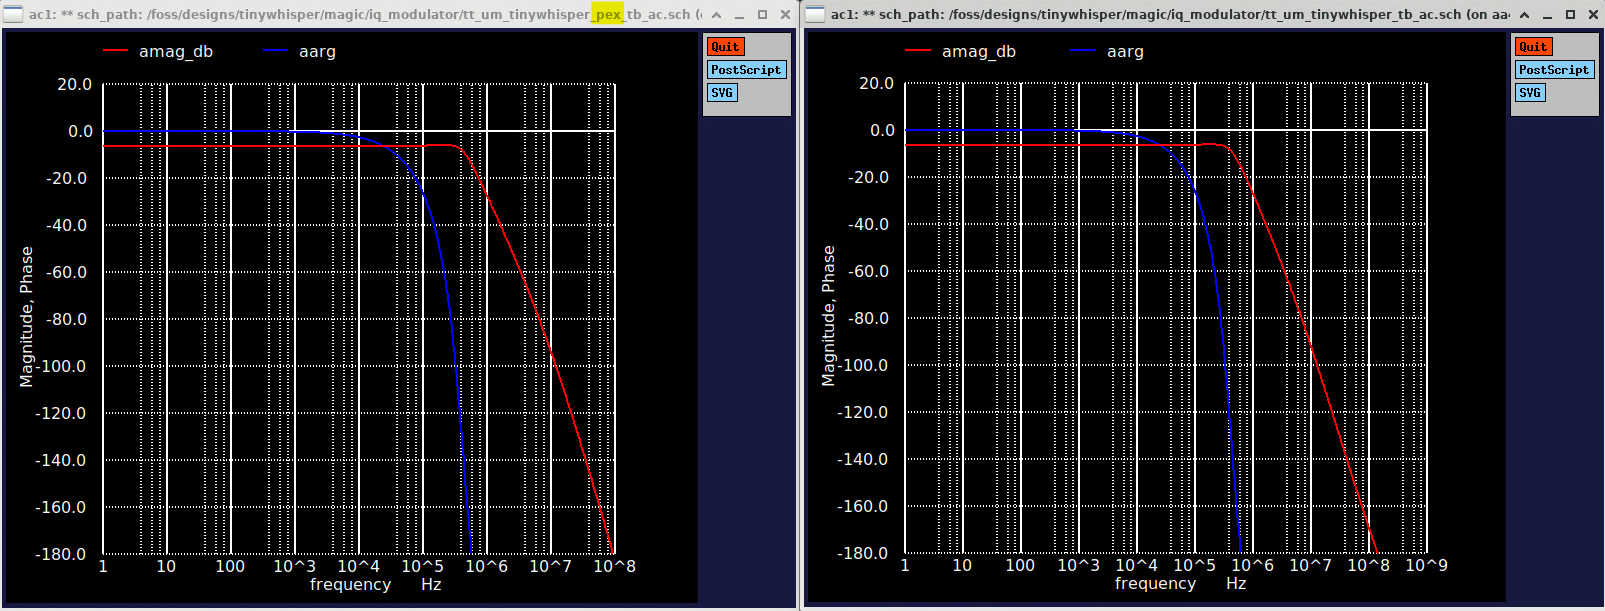
sky130/macros/iqmod/schematic/figures/simulations/wspr_tx_top_ideal_vs_post-layout_ac_sim.png
