iic-jku/TinyWhisper/sky130/macros/iqmod/schematic/figures/simulations/wspr_tx_top_ideal_vs_post-layout_tran_sim_pwm.png

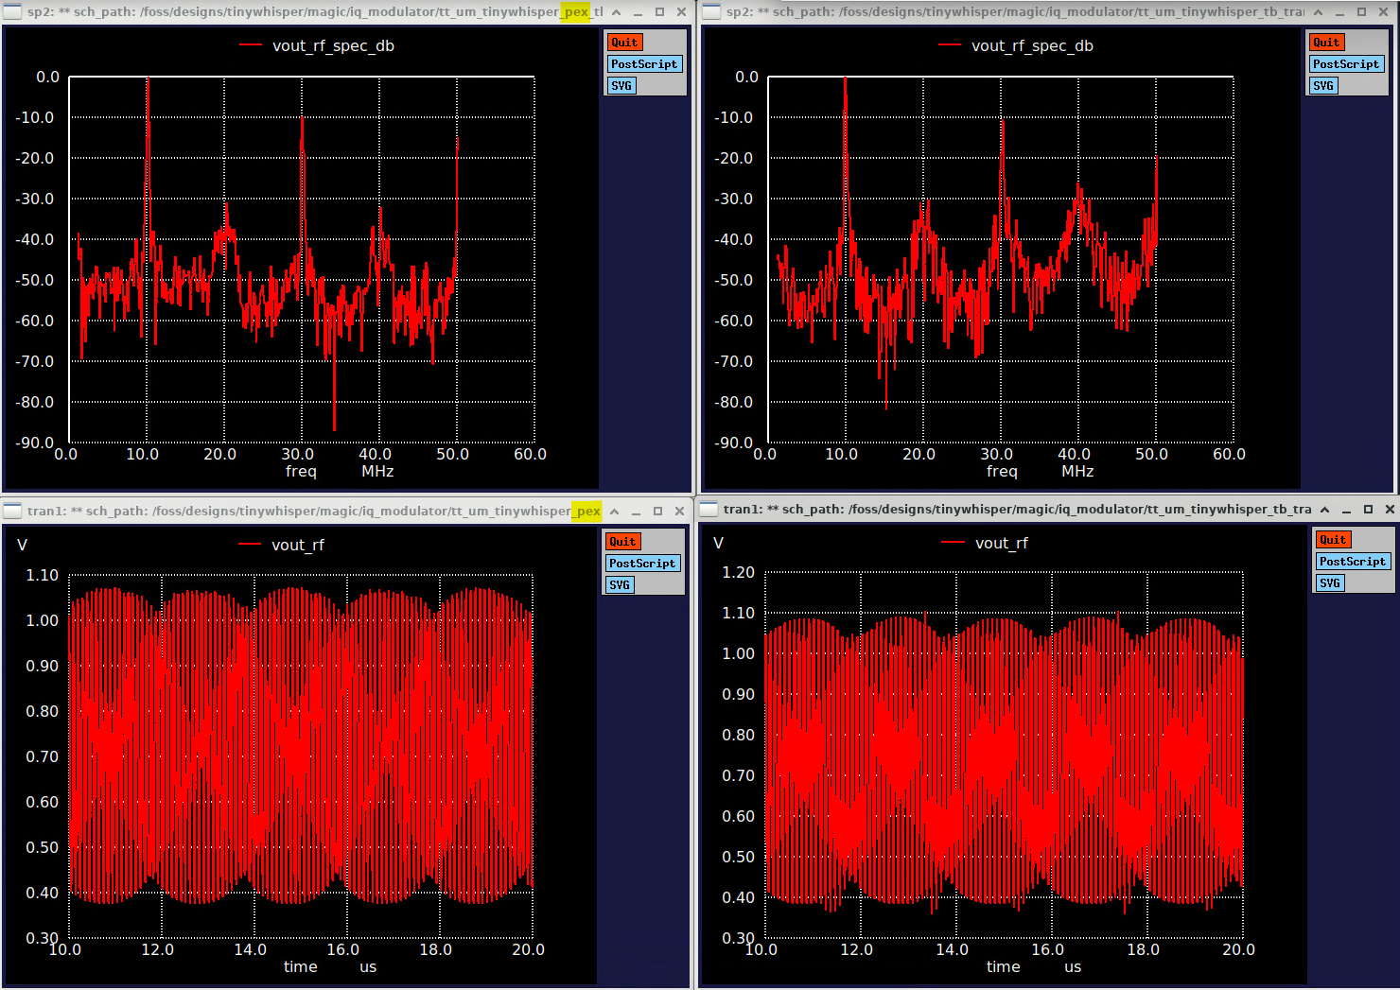
sky130/macros/iqmod/schematic/figures/simulations/wspr_tx_top_ideal_vs_post-layout_tran_sim_pwm.png
