iic-jku/TinyWhisper/measurements/README.md

# Measurements

- TBD (Simon)
    - Transfer Function of MFB Filter
    - THD of MFB Filter
    - Output Amplitude (per ham radio band)
    - FFT (per ham radio band)
    - WSPR online map

## sky130A TinyWhisper

- Test and characterize TinyTapeout `TTSKY25b` run:
    - Digital Core: https://tinytapeout.com/chips/ttsky25b/tt_um_cejmu_wspr
    - Analog Front-End: https://tinytapeout.com/chips/ttsky25b/tt_um_TinyWhisper

## gf180mcuD TinyWhisper

- Test and characterize wafer.space run: https://github.com/iic-jku/gf180mcu-jku-projects

## ihp-sg13g2 TinyWhisper

- ToDo
