iic-jku/TinyWhisper/ihp130/macros/iqmod/testbenches/xschem/plot_simulations/figures/iqmod_mfb_lpf_riscv_tb_dsm.pdf

0.00 | 0.25 | 0.50 | 0.75 | 1.00 | 1.25 | 1.50 | 1.75 | 2.00
| | | | Time (µs)

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
Voltage (V)

### MFB LPF – Delta-Sigma Modulator Output

DSM
