iic-jku/TinyWhisper/ihp130/macros/iqmod/testbenches/xschem/plot_simulations/figures/iqmod_mfb_lpf_riscv_tb_tran_period.pdf

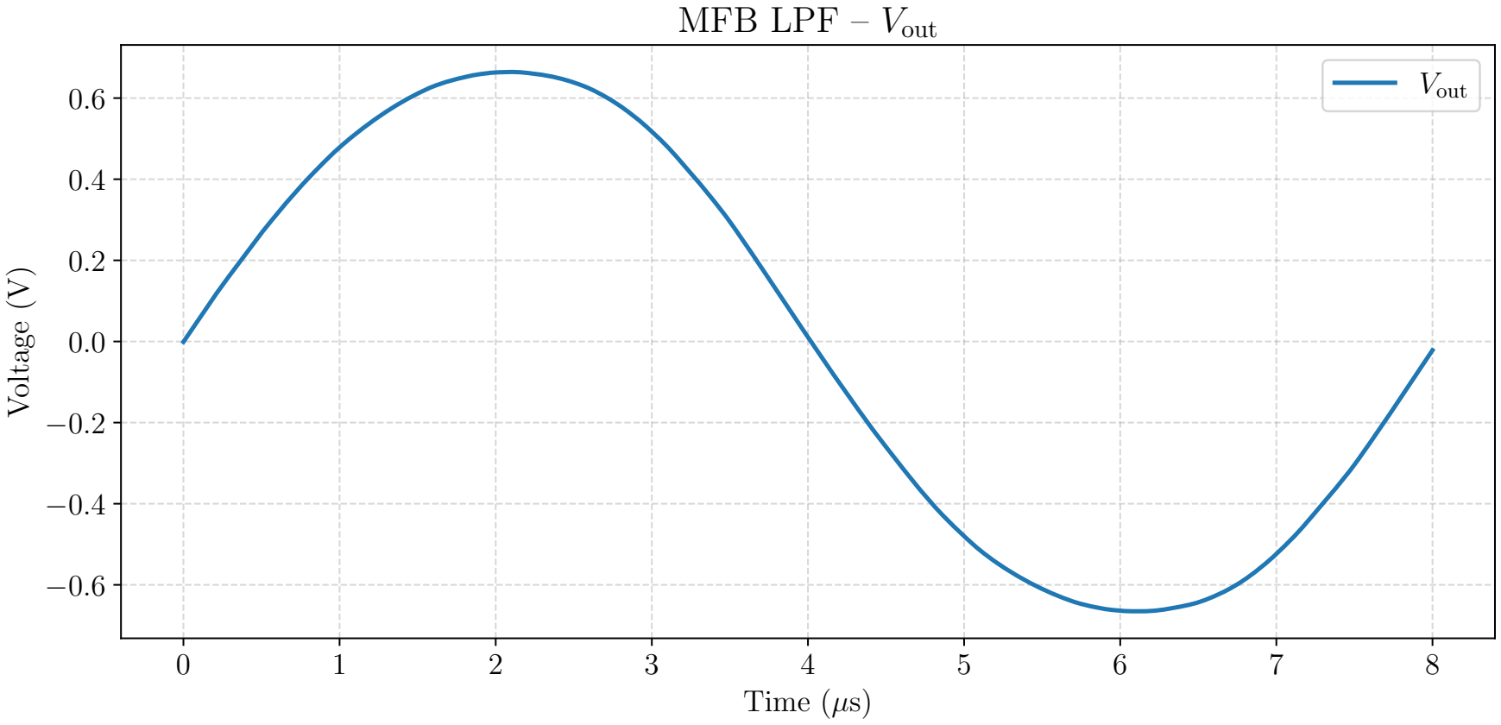
[picture p96: figure]
Time (; Voltage (V); MFB LPF –; Vout
