iic-jku/TinyWhisper/ihp130/macros/iqmod/testbenches/xschem/plot_simulations/figures/iqmod_mfb_lpf_tb_ac_cl.pdf

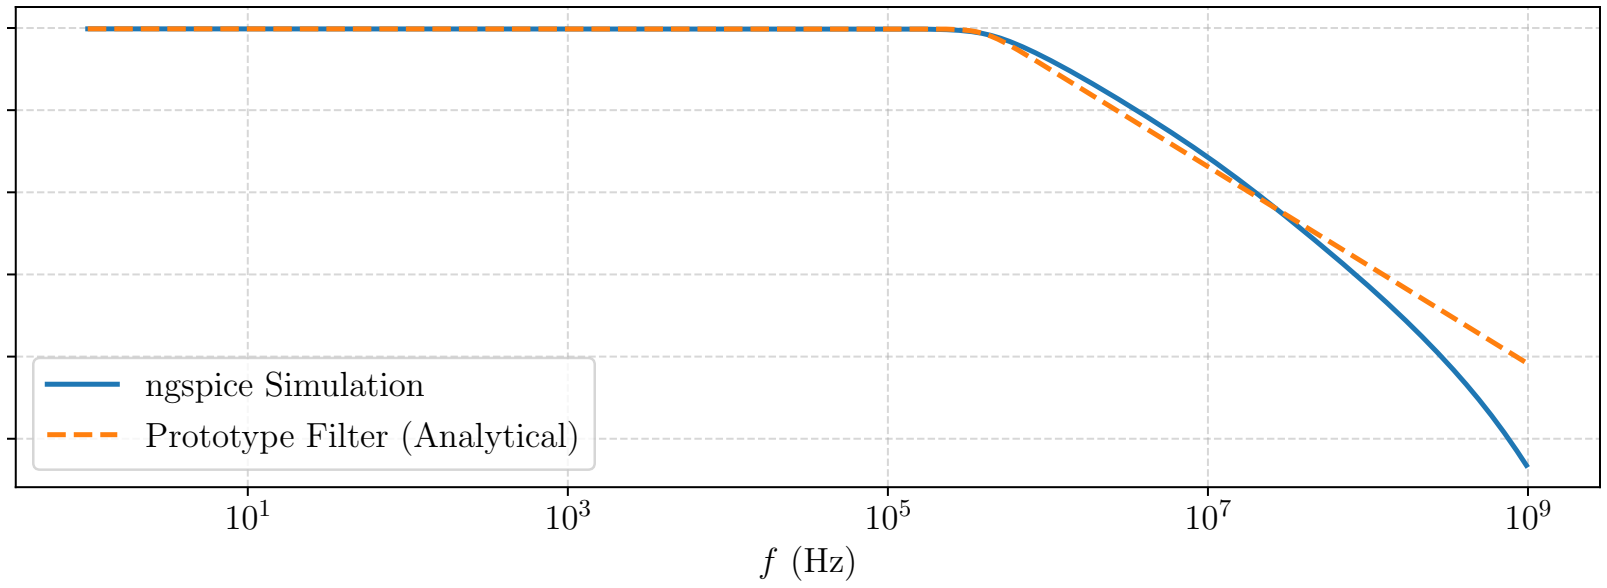
[picture p97: figure]
ngspice Simulation Prototype Filter (Analytical)

−250 −200 −150 −100 −500

Magnitude (dB)

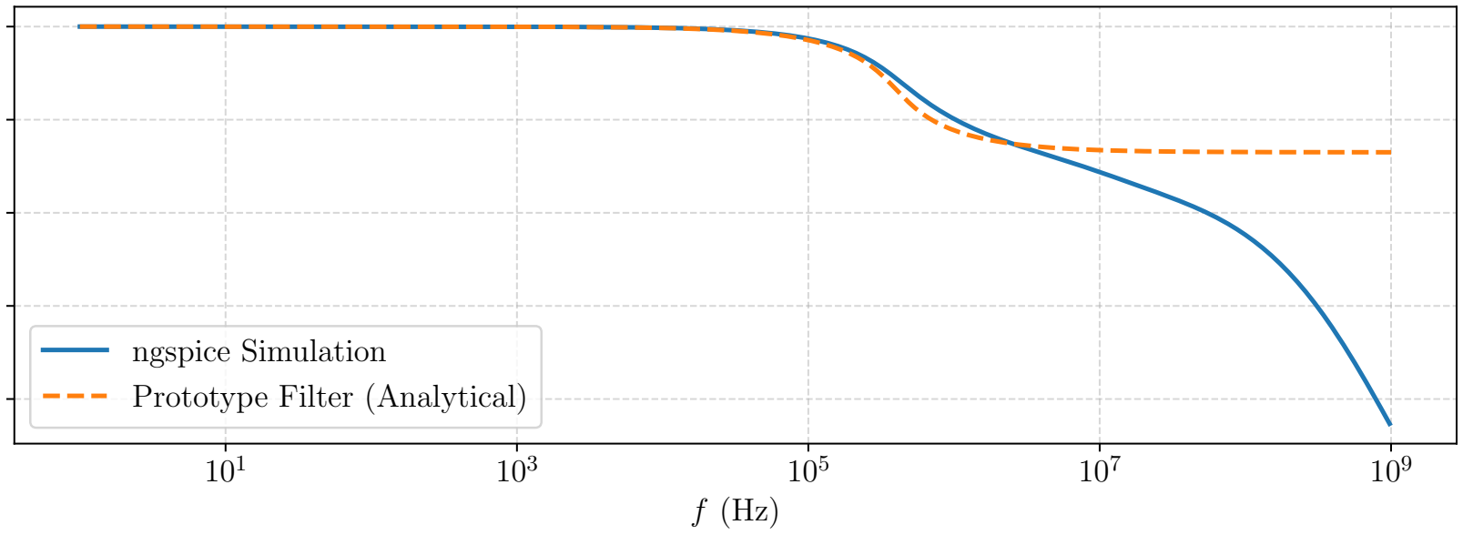
[picture p98: figure]
ngspice Simulation Prototype Filter (Analytical)

−800 −600 −400 −2000

### Phase (◦)
