iic-jku/TinyWhisper/ihp130/packaging/result.md

# Bondplan Report - tinywhisper v.2.0.0

Generated by `scripts/run_bondplan.py` on 2026-11-11.

Bondplan

## Summary

| | |
|---|---|
| Design | tinywhisper |
| Package | OP_QFN48_A4_FIT |
| Die size | 2.00 x 2.00 mm |
| Pad pitch / opening | 96 / 65.8 um |
| Bondwires | 60 (44 pad to lead, 12 pad to cavity, 4 lead to cavity) |
| Wire width | 25 um |
| Wire length | 2068 .. 2751 um |
| Min wire-to-wire gap | 49 um |
| Max lead skew | 3.2 deg |

## Bond Table

| Pin | Die pad | Die x/y (um) | Package x/y (um) | Length (um) | Angle (deg) | Skew (deg) | Min gap (um) |
|---|---|---|---|---|---|---|---|
| 1 | clk_PAD | 3845.0 / 9886.8 | 1778.5 / 11702.2 | 2750.6 | 138.7 | 1.8 | 53.1 |
| 2 | rst_n_PAD | 3845.0 / 9790.8 | 1778.5 / 11269.7 | 2541.2 | 144.4 | 1.5 | 53.1 |
| 3 | input_PAD[5] | 3845.0 / 9694.8 | 1778.5 / 10825.3 | 2355.5 | 151.3 | 0.9 | 59.2 |
| 4 | output_PAD[8] | 3845.0 / 9598.8 | 1778.5 / 10380.9 | 2209.5 | 159.3 | 0.0 | 64.8 |
| 5 | output_PAD[7] | 3845.0 / 9502.8 | 1778.5 / 9936.5 | 2111.5 | 168.1 | 1.0 | 69.0 |
| 6 | output_PAD[6] | 3845.0 / 9406.8 | 1778.5 / 9492.1 | 2068.3 | 177.6 | 2.1 | 70.9 |
| 7 | IOVDD | 3845.0 / 9310.8 | 1778.5 / 9033.3 | 2085.0 | -172.4 | 3.2 | 70.1 |
| 8 | VDD | 3845.0 / 9118.8 | 1778.5 / 8588.9 | 2133.4 | -165.6 | 1.6 | 68.0 |
| 9 | bidir_PAD[8] | 3845.0 / 8926.8 | 1778.5 / 8144.5 | 2209.6 | -159.3 | 0.0 | 64.8 |
| 10 | output_PAD[5] | 3845.0 / 8830.8 | 1778.5 / 7700.1 | 2355.6 | -151.3 | 0.9 | 59.2 |
| 11 | input_PAD[4] | 3845.0 / 8734.8 | 1778.5 / 7255.7 | 2541.3 | -144.4 | 1.5 | 53.1 |
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
| EPAD | VSS | 5635.0 / 9022.8 | 6111.7 / 8872.0 | 500.0 | -17.6 | - | 66.5 |
| EPAD | VSS | 5635.0 / 9502.8 | 6111.7 / 9653.6 | 500.0 | 17.6 | - | 66.5 |
| EPAD | VSS | 5635.0 / 9694.8 | 6075.8 / 9930.8 | 500.0 | 28.2 | - | 59.6 |
