iic-jku/TinyWhisper/ihp130/testbenches/cocotb/i2c_mc_test.txt

93
00
00
00
13
01
00
00
93
01
00
00
13
02
00
00
93
02
00
00
13
03
00
00
93
03
00
00
13
04
00
00
93
04
00
00
13
05
00
00
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
FB
13
01
01
FF
23
20
01
00
23
22
01
00
23
24
01
00
23
26
01
00
EF
00
00
04
6F
00
00
00
13
01
41
FF
23
24
11
00
23
22
81
00
13
04
C1
00
93
07
05
00
A3
0B
F4
FE
83
A7
81
80
03
47
74
FF
23
80
E7
00
13
00
00
00
83
20
81
00
03
24
41
00
13
01
C1
00
67
80
00
00
13
01
81
FE
23
2A
11
00
23
28
81
00
13
04
81
01
EF
00
00
69
B7
77
00
00
13
85
07
99
EF
00
00
65
83
A7
C1
80
13
07
A0
05
23
80
E7
00
83
A7
81
85
13
07
10
00
23
80
E7
00
83
A7
C1
86
23
80
07
00
83
A7
41
86
13
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
FE
83
27
44
FF
E3
84
07
FE
83
A7
81
87
83
C7
07
00
93
F7
F7
0F
93
F7
47
00
23
28
F4
FE
83
27
04
FF
63
84
07
00
6F
F0
5F
FE
13
00
00
00
83
A7
C1
86
13
07
10
00
23
80
E7
00
83
A7
41
86
13
07
20
00
23
A0
E7
00
83
A7
01
87
13
07
B0
FA
23
80
E7
00
83
A7
C1
85
13
07
20
01
23
90
E7
00
83
A7
81
86
13
07
10
00
23
80
E7
00
83
A7
81
86
23
80
07
00
83
A7
81
87
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
FE
83
27
C4
FE
63
94
07
00
6F
F0
5F
FE
13
00
00
00
83
A7
41
88
13
07
10
00
23
80
E7
00
83
A7
01
87
13
07
D0
FC
23
80
E7
00
83
A7
81
87
83
C7
07
00
93
F7
F7
0F
93
F7
17
00
23
24
F4
FE
83
27
84
FE
E3
84
07
FE
6F
00
00
00
13
01
41
FC
23
2C
11
02
23
2A
81
02
23
28
91
02
13
04
C1
03
23
26
A4
FC
23
28
B4
FC
93
07
06
00
A3
05
F4
FC
93
07
44
FF
23
22
F4
FC
83
27
44
FC
93
87
07
FE
93
87
77
00
93
D7
37
00
93
94
37
00
B7
77
00
00
03
A7
87
9D
83
A7
C7
9D
23
A8
E4
00
23
AA
F4
00
83
47
B4
FC
13
07
30
00
63
8A
E7
06
13
07
30
00
63
42
F7
08
13
07
20
00
63
86
E7
04
13
07
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
20
55
00
00
40
54
00
00
20
54
00
00
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
CB
FF
FF
84
06
00
00
00
44
0E
2C
4C
81
01
88
02
89
03
03
60
01
0A
C1
44
C8
44
C9
4C
0E
00
44
0B
00
00
00
28
00
00
00
44
00
00
00
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
FF
FF
18
06
00
00
00
44
0E
34
4C
88
02
81
01
89
03
03
4C
01
0A
C1
44
C8
44
C9
44
0E
00
44
0B
00
00
00
00
00
80
00
01
00
80
00
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
