iic-jku/TinyWhisper/ihp130/testbenches/cocotb/wspr_test.txt

93
00
00
00
13
01
00
00
93
01
00
00
13
02
00
00
93
02
00
00
13
03
00
00
93
03
00
00
13
04
00
00
93
04
00
00
13
05
00
00
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
FB
13
01
01
FF
23
20
01
00
23
22
01
00
23
24
01
00
23
26
01
00
EF
50
00
4C
6F
00
00
00
13
01
81
FE
23
2A
11
00
23
22
B1
00
23
28
81
00
23
26
91
00
13
04
05
00
93
04
00
00
EF
00
80
7C
EF
00
C0
61
EF
00
40
65
83
27
41
00
13
87
F7
FF
63
CA
E4
00
93
84
14
00
33
04
94
00
23
00
04
00
6F
00
80
03
EF
00
40
62
E3
0E
05
FE
EF
00
C0
77
23
20
A1
00
EF
00
40
62
83
27
01
00
93
06
D0
00
33
07
94
00
63
96
D7
02
37
55
00
00
23
00
07
00
13
05
85
60
EF
20
C0
21
83
20
41
01
03
24
01
01
13
85
04
00
83
24
C1
00
13
01
81
01
67
80
00
00
83
25
01
00
37
55
00
00
13
05
C5
60
23
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
EF
20
00
1F
83
27
01
00
03
27
81
00
93
84
14
00
23
00
F7
00
6F
F0
5F
F7
83
A7
81
8F
23
80
A7
00
67
80
00
00
13
01
81
FD
23
22
11
02
23
20
51
02
23
2E
61
00
23
2C
71
00
23
26
C1
00
23
24
D1
00
23
22
E1
00
23
20
F1
00
23
28
B1
00
23
2A
A1
00
EF
00
80
6D
93
05
05
00
37
55
00
00
13
05
C5
60
EF
20
00
19
EF
00
40
57
83
20
41
02
83
22
01
02
03
23
C1
01
83
23
81
01
03
25
41
01
83
25
01
01
03
26
C1
00
83
26
81
00
03
27
41
00
83
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
FF
23
20
81
00
13
05
00
00
23
22
11
00
23
A2
01
90
EF
00
C0
5A
13
05
10
00
EF
00
40
5A
13
05
00
00
EF
00
40
5B
13
05
20
00
EF
00
00
5F
13
05
00
00
EF
00
40
60
13
05
00
00
EF
00
C0
61
03
A7
41
90
B7
67
00
00
93
87
87
98
B3
87
E7
00
03
C7
07
00
93
87
81
90
13
17
27
00
B3
87
E7
00
03
A5
07
00
EF
00
C0
5A
83
A7
01
90
13
07
F0
FF
37
85
01
00
23
80
E7
00
13
05
05
6A
93
05
00
00
EF
00
C0
52
13
05
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
00
00
E0
3F
FF
FF
FF
FF
FF
FF
EF
7F
FF
FF
FF
FF
FF
FF
EF
FF
FB
79
9F
50
13
44
D3
3F
B3
C8
60
8B
28
8A
C6
3F
00
00
00
00
00
00
F8
3F
61
43
6F
63
A7
87
D2
3F
71
A3
79
09
4F
93
0A
40
16
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
BB
B1
6B
02
40
EF
39
FA
FE
42
2E
E6
3F
00
00
00
00
00
00
2C
40
00
00
00
00
00
00
24
40
00
00
00
00
00
00
18
40
2D
43
1C
EB
E2
36
1A
3F
00
00
00
00
80
84
2E
41
00
00
00
00
65
CD
CD
C1
38
00
80
00
34
00
80
00
30
00
80
00
2C
00
80
00
28
00
80
00
24
00
80
00
22
00
80
00
21
00
80
00
20
00
80
00
1C
00
80
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
