iic-jku/TinyWhisper/ihp130/testbenches/cocotb/gpio_test.txt

93
00
00
00
13
01
00
00
93
01
00
00
13
02
00
00
93
02
00
00
13
03
00
00
93
03
00
00
13
04
00
00
93
04
00
00
13
05
00
00
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
FB
13
01
01
FF
23
20
01
00
23
22
01
00
23
24
01
00
23
26
01
00
EF
00
80
00
6F
00
00
00
83
26
00
0C
03
27
40
0C
83
C7
06
00
93
87
17
00
23
00
F7
00
6F
F0
5F
FF
2C
00
80
00
28
00
80
00
24
00
80
00
22
00
80
00
21
00
80
00
20
00
80
00
1C
00
80
00
18
00
80
00
14
00
80
00
10
00
80
00
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
