iic-jku/TinyWhisper/ihp130/testbenches/cocotb/i2c_rw_test.txt

93
00
00
00
13
01
00
00
93
01
00
00
13
02
00
00
93
02
00
00
13
03
00
00
93
03
00
00
13
04
00
00
93
04
00
00
13
05
00
00
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
FB
13
01
01
FF
23
20
01
00
23
22
01
00
23
24
01
00
23
26
01
00
EF
00
80
00
6F
00
00
00
83
27
40
11
13
07
A0
05
B7
56
34
12
23
80
E7
00
03
27
C0
10
93
07
10
00
93
86
86
67
23
00
F7
00
83
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
