iic-jku/TinyWhisper/ihp130/testbenches/cocotb/uart_rx_test.txt

93
00
00
00
13
01
00
00
93
01
00
00
13
02
00
00
93
02
00
00
13
03
00
00
93
03
00
00
13
04
00
00
93
04
00
00
13
05
00
00
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
FB
13
01
01
FF
23
20
01
00
23
22
01
00
23
24
01
00
23
26
01
00
EF
50
40
41
6F
00
00
00
13
01
81
FE
23
2A
11
00
23
20
A1
00
23
22
B1
00
23
28
81
00
23
26
91
00
EF
00
00
72
EF
00
C0
5D
EF
00
40
61
03
24
01
00
93
04
00
00
83
27
41
00
13
87
F7
FF
63
CC
E4
00
83
27
01
00
13
85
14
00
33
84
A7
00
23
00
04
00
6F
00
80
03
EF
00
80
5D
E3
0E
05
FE
23
24
81
00
EF
00
40
6C
23
00
A4
00
EF
00
40
5D
03
46
04
00
93
06
D0
00
13
04
14
00
03
27
81
00
63
10
D6
02
13
85
04
00
23
00
07
00
83
20
41
01
03
24
01
01
83
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
FD
23
22
11
02
23
20
51
02
23
2E
61
00
23
2C
71
00
23
26
C1
00
23
24
D1
00
23
22
E1
00
23
20
F1
00
23
28
B1
00
23
2A
A1
00
EF
00
80
64
93
05
05
00
37
55
00
00
13
05
05
4E
EF
20
00
10
EF
00
C0
54
83
20
41
02
83
22
01
02
03
23
C1
01
83
23
81
01
03
25
41
01
83
25
01
01
03
26
C1
00
83
26
81
00
03
27
41
00
83
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
FF
23
20
81
00
13
05
00
00
23
22
11
00
23
AC
01
8E
EF
00
40
58
13
05
10
00
EF
00
C0
57
13
05
00
00
EF
00
C0
58
13
05
20
00
EF
00
80
5C
03
A7
81
8F
B7
67
00
00
93
87
07
87
B3
87
E7
00
03
C7
07
00
93
87
C1
8F
13
17
27
00
B3
87
E7
00
03
A5
07
00
EF
00
40
59
37
15
7D
00
13
05
05
FA
93
05
00
00
EF
00
00
52
13
05
00
00
93
05
00
00
EF
00
C0
4E
13
05
10
00
EF
00
80
53
03
24
01
00
83
20
41
00
13
01
81
00
6F
00
80
3E
13
01
81
FD
23
22
11
02
23
20
51
02
23
2E
61
00
23
2C
71
00
23
2A
A1
00
23
28
B1
00
23
26
C1
00
23
24
D1
00
23
22
E1
00
23
20
F1
00
EF
00
80
3C
EF
F0
5F
F4
83
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
6B
02
40
EF
39
FA
FE
42
2E
E6
3F
00
00
00
00
00
00
2C
40
00
00
00
00
00
00
24
40
00
00
00
00
00
00
18
40
2D
43
1C
EB
E2
36
1A
3F
00
00
00
00
80
84
2E
41
00
00
00
00
65
CD
CD
C1
2C
00
80
00
28
00
80
00
24
00
80
00
22
00
80
00
21
00
80
00
20
00
80
00
1C
00
80
00
18
00
80
00
14
00
80
00
10
00
80
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
