iic-jku/TinyWhisper/ihp130/macros/iqmod/testbenches/xschem/plot_simulations/figures/iqmod_mfb_lpf_riscv_tb_tran_fft.pdf

### MFB LPF – RISC-V DSM Output Spectrum (FFT)

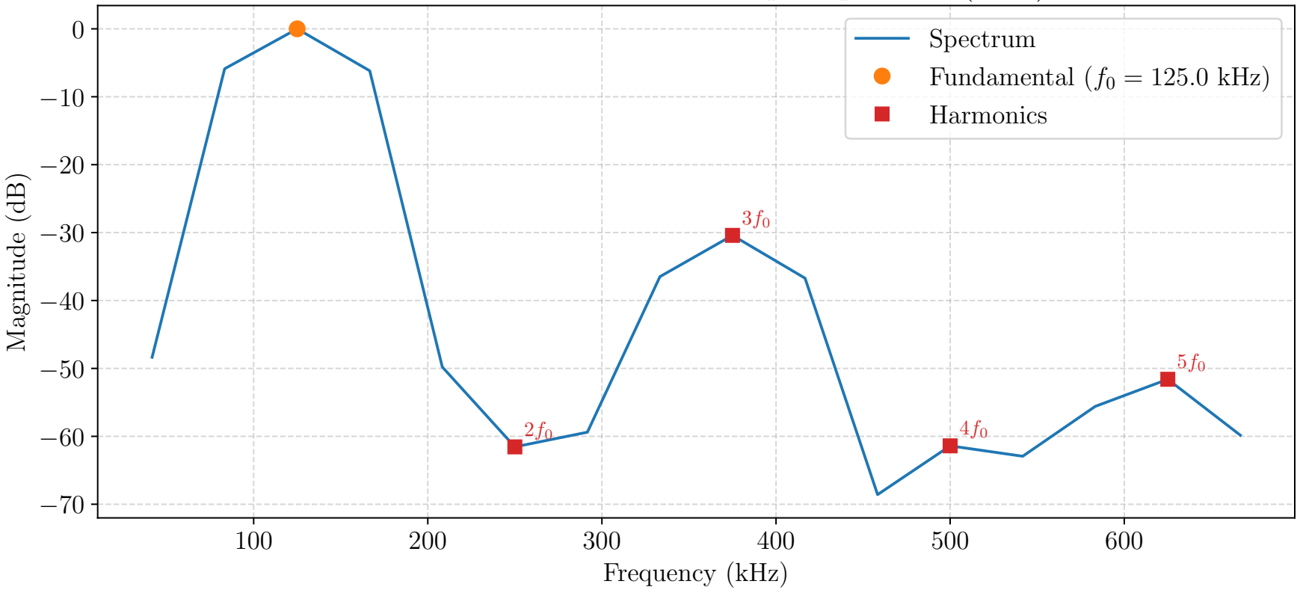
[picture p99: figure]
Frequency (kHz); Magnitude (dB); Spectrum Fundamental (f0; = 125.0 kHz); Harmonics
