iic-jku/TinyWhisper/ihp130/macros/iqmod/verification/cace/scripts/iqmod_mfb_lpf_ota_core_tb_ac.csv

Adc_ol_dB_arr | fcu_arr | CMRR_dc_dB_arr
2.712320000000000064e+01 | 4.326280000000000000e+06 | 6.184960000000000235e+01
2.780170000000000030e+01 | 3.767660000000000000e+06 | 6.496380000000000621e+01
2.715469999999999828e+01 | 4.356810000000000000e+06 | 6.406860000000000355e+01
2.754909999999999926e+01 | 4.009150000000000000e+06 | 6.506459999999999866e+01
2.743459999999999965e+01 | 3.985110000000000000e+06 | 6.799559999999999604e+01
2.738639999999999830e+01 | 3.941680000000000000e+06 | 8.409319999999999595e+01
2.806940000000000168e+01 | 3.519650000000000000e+06 | 6.225739999999999696e+01
2.808510000000000062e+01 | 3.442800000000000000e+06 | 6.475769999999999982e+01
2.655249999999999844e+01 | 4.562770000000000000e+06 | 6.031139999999999901e+01
2.797129999999999939e+01 | 3.563560000000000000e+06 | 6.810949999999999704e+01
2.694900000000000162e+01 | 4.289810000000000000e+06 | 6.456570000000000675e+01
2.761169999999999902e+01 | 3.901710000000000000e+06 | 7.627280000000000371e+01
2.664780000000000015e+01 | 4.772780000000000000e+06 | 6.116479999999999961e+01
2.781279999999999930e+01 | 3.686850000000000000e+06 | 7.087510000000000332e+01
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
