iic-jku/TinyWhisper/ihp130/macros/iqmod/verification/cace/scripts/iqmod_mfb_lpf_tb_ac.csv

Adc_cl_dB_arr | fcu_arr | CMRR_dc_dB_arr
-5.749579999999999691e-01 | 4.136160000000000000e+05 | 3.957699999999999818e+01
-5.232369999999999521e-01 | 4.355710000000000000e+05 | 4.863889999999999958e+01
-5.745460000000000012e-01 | 4.658750000000000000e+05 | 4.175450000000000017e+01
-5.434189999999999854e-01 | 3.997540000000000000e+05 | 4.459790000000000276e+01
-5.492289999999999672e-01 | 4.479680000000000000e+05 | 4.504160000000000252e+01
-5.485700000000000021e-01 | 3.740660000000000000e+05 | 6.358870000000000289e+01
-5.035509999999999708e-01 | 3.986640000000000000e+05 | 4.526709999999999923e+01
-4.976610000000000200e-01 | 3.839920000000000000e+05 | 4.856909999999999883e+01
-6.104699999999999571e-01 | 3.539020000000000000e+05 | 3.887239999999999895e+01
-5.101179999999999604e-01 | 3.873130000000000000e+05 | 4.772570000000000334e+01
-5.798940000000000206e-01 | 3.825870000000000000e+05 | 4.345120000000000005e+01
-5.370479999999999698e-01 | 3.949190000000000000e+05 | 6.160549999999999926e+01
-6.101269999999999749e-01 | 4.113920000000000000e+05 | 3.908370000000000033e+01
-5.233740000000000059e-01 | 4.101990000000000000e+05 | 4.666879999999999740e+01
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
