iic-jku/TinyWhisper/sky130/macros/iqmod/verification/cace/scripts/wspr_tx_iqmod_mfb_lpf_ota_core_tb_ac.csv

Adc_ol_dB_arr | fcu_arr | CMRR_dc_dB_arr
3.105750000000000099e+01 | 5.075610000000000000e+05 | 4.336590000000000344e+01
3.105740000000000123e+01 | 5.092250000000000000e+05 | 4.345649999999999835e+01
3.108599999999999852e+01 | 5.075410000000000000e+05 | 4.348949999999999960e+01
3.107260000000000133e+01 | 5.079190000000000000e+05 | 4.350110000000000099e+01
3.108510000000000062e+01 | 5.073050000000000000e+05 | 4.342649999999999721e+01
3.103200000000000003e+01 | 5.097990000000000000e+05 | 4.338300000000000267e+01
3.108119999999999905e+01 | 5.058000000000000000e+05 | 4.349430000000000263e+01
3.105379999999999896e+01 | 5.089100000000000000e+05 | 4.348530000000000229e+01
3.106889999999999930e+01 | 5.073280000000000000e+05 | 4.348590000000000089e+01
3.106640000000000157e+01 | 5.071340000000000000e+05 | 4.346320000000000050e+01
3.106569999999999965e+01 | 5.069580000000000000e+05 | 4.342759999999999820e+01
3.106800000000000139e+01 | 5.067750000000000000e+05 | 4.342060000000000031e+01
3.106469999999999843e+01 | 5.075440000000000000e+05 | 4.344809999999999661e+01
3.107819999999999894e+01 | 5.065240000000000000e+05 | 4.339929999999999666e+01
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
