iic-jku/TinyWhisper/sky130/macros/iqmod/verification/cace/scripts/wspr_tx_iqmod_mfb_lpf_tb_ac.csv

Adc_cl_dB_arr | fcu_arr | CMRR_dc_dB_arr
-2.686799999999999744e-01 | 4.367600000000000000e+05 | 1.563589999999999947e+01
-2.686839999999999784e-01 | 4.352690000000000000e+05 | 1.570889999999999986e+01
-2.684980000000000144e-01 | 4.373920000000000000e+05 | 1.567820000000000036e+01
-2.696259999999999768e-01 | 4.349080000000000000e+05 | 1.569280000000000008e+01
-2.684630000000000072e-01 | 4.380820000000000000e+05 | 1.571419999999999995e+01
-2.680179999999999785e-01 | 4.390070000000000000e+05 | 1.555930000000000035e+01
-2.682300000000000240e-01 | 4.374650000000000000e+05 | 1.568110000000000070e+01
-2.689849999999999741e-01 | 4.365410000000000000e+05 | 1.570040000000000013e+01
-2.671589999999999798e-01 | 4.358470000000000000e+05 | 1.567370000000000019e+01
-2.683010000000000117e-01 | 4.356940000000000000e+05 | 1.566009999999999991e+01
-2.692200000000000149e-01 | 4.406280000000000000e+05 | 1.558590000000000053e+01
-2.687089999999999756e-01 | 4.344180000000000000e+05 | 1.558290000000000042e+01
-2.688659999999999939e-01 | 4.365300000000000000e+05 | 1.568999999999999950e+01
-2.678969999999999962e-01 | 4.385160000000000000e+05 | 1.571049999999999969e+01
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
