iic-jku/TinyWhisper/ihp130/macros/iqmod/testbenches/xschem/plot_simulations/data/biquad_mfb_lpf_prototype_bode.csv

frequency | mag_dB | phase_deg
1.000000000000000000e+00 | -4.999999999999978906e-01 | -2.025692284689245700e-04
1.020939483707679951e+00 | -4.999999999999998890e-01 | -2.068109235281451598e-04
1.042317429393304185e+00 | -4.999999999999998890e-01 | -2.111414374919523909e-04
1.064143018224316117e+00 | -4.999999999999998890e-01 | -2.155626301823519199e-04
1.086425623617065517e+00 | -4.999999999999998890e-01 | -2.200764003650618617e-04
1.109174815262401026e+00 | -4.999999999999998890e-01 | -2.246846865649742848e-04
1.132400363235557039e+00 | -4.999999999999998890e-01 | -2.293894678986916973e-04
1.156112242192098849e+00 | -4.999999999999978906e-01 | -2.341927649244962041e-04
1.180320635651729733e+00 | -4.999999999999978906e-01 | -2.390966405101173863e-04
1.205035940371797398e+00 | -4.999999999999998890e-01 | -2.441032007186698925e-04
1.230268770812381618e+00 | -4.999999999999978906e-01 | -2.492145957131429749e-04
1.256029963694874851e+00 | -4.999999999999978906e-01 | -2.544330206798283821e-04
1.282330582656021400e+00 | -4.999999999999978906e-01 | -2.597607167710855119e-04
1.309181922999407055e+00 | -4.999999999999998890e-01 | -2.651999720678473648e-04
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
