iic-jku/TinyWhisper/ihp130/macros/iqmod/testbenches/xschem/plot_simulations/figures/dsm_sine_data.csv

Time_s | Sine_Amplitude | PWM_Amplitude
0.0 | 0.0 | 1.2
0.0001 | 0.0006283184893762572 | 1.2
0.0002 | 0.0012566367307023255 | 1.2
0.00030000000000000003 | 0.0018849544759281139 | 1.2
0.0004 | 0.0025132714770037265 | 1.2
0.0005 | 0.0031415874858795635 | 1.2
0.0006000000000000001 | 0.0037699022545064137 | 1.2
0.0007 | 0.004398215534835557 | 1.2
0.0008 | 0.005026527078818862 | 1.2
0.0009000000000000001 | 0.005654836638408882 | 1.2
0.001 | 0.006283143965558951 | 1.2
0.0011 | 0.006911448812223289 | 1.2
0.0012000000000000001 | 0.007539750930357092 | 1.2
0.0013000000000000002 | 0.008168050071916635 | 1.2
0.0014 | 0.008796345988859365 | 1.2
0.0015 | 0.009424638433144006 | 1.2
0.0016 | 0.010052927156730652 | 1.2
0.0017000000000000001 | 0.010681211911580866 | 1.2
0.0018000000000000002 | 0.011309492449657772 | 1.2
0.0019 | 0.011937768522926166 | 1.2
0.002 | 0.012566039883352607 | 1.2
0.0021000000000000003 | 0.013194306282905513 | 1.2
0.0022 | 0.01382256747355525 | 1.2
0.0023 | 0.014450823207274257 | 1.2
0.0024000000000000002 | 0.01507907323603712 | 1.2
0.0025 | 0.015707317311820675 | 1.2
0.0026000000000000003 | 0.016335555186604112 | 1.2
0.0027 | 0.016963786612369067 | 1.2
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
