iic-jku/TinyWhisper/ihp130/macros/iqmod/testbenches/xschem/plot_simulations/figures/iqmod_mfb_lpf_riscv_tb_dsm.csv

time_us | dsm
0.000000000000000000e+00 | 1.480462079999999903e+00
1.739999999959091978e-05 | 1.454411520000000069e+00
5.210000000052759234e-05 | 1.402310399999999957e+00
1.216000000006461045e-04 | 1.298108159999999955e+00
2.605000000009438958e-04 | 1.089703679999999952e+00
5.383999999997846455e-04 | 6.728947229999999724e-01
8.223000000000615668e-04 | 2.470638480000000026e-01
1.006599999999876257e-03 | -0.000000000000000000e+00
1.165999999999575145e-03 | -0.000000000000000000e+00
1.335999999999609202e-03 | -0.000000000000000000e+00
1.493800000000280364e-03 | -0.000000000000000000e+00
1.809599999999807196e-03 | -0.000000000000000000e+00
2.191699999999703347e-03 | -0.000000000000000000e+00
2.767100000000720979e-03 | -0.000000000000000000e+00
3.585100000000007291e-03 | -0.000000000000000000e+00
5.215700000000167598e-03 | -0.000000000000000000e+00
6.968500000000609623e-03 | -0.000000000000000000e+00
6.969500000000001735e-03 | -0.000000000000000000e+00
6.971500000000480785e-03 | -0.000000000000000000e+00
6.975499999999744058e-03 | -0.000000000000000000e+00
6.978499999999615219e-03 | -0.000000000000000000e+00
6.979300000000823040e-03 | -0.000000000000000000e+00
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
