iic-jku/TinyWhisper/ihp130/macros/iqmod/testbenches/xschem/plot_simulations/figures/iqmod_mfb_lpf_riscv_tb_tran_period.csv

time_us | vout
0.000000000000000000e+00 | -1.011386530000000020e-03
2.883700000001017307e-03 | 6.288289660000000473e-04
3.240800000000858532e-03 | 8.318555790000000142e-04
3.955100000000480107e-03 | 1.237877830000000011e-03
4.790800000000868669e-03 | 1.712872880000000002e-03
4.933700000000430276e-03 | 1.794062799999999970e-03
5.040800000001417064e-03 | 1.854954729999999923e-03
5.069400000000978332e-03 | 1.871192499999999991e-03
5.090800000001526916e-03 | 1.883370789999999975e-03
5.096600000001390122e-03 | 1.886618340000000005e-03
5.108000000001239153e-03 | 1.893113419999999927e-03
5.130800000000937215e-03 | 1.906103570000000028e-03
5.140799999999941944e-03 | 1.911786740000000033e-03
5.145400000000535656e-03 | 1.914384770000000053e-03
5.154600000000026522e-03 | 1.919580809999999957e-03
5.172800000000825696e-03 | 1.929972889999999981e-03
5.190800000000051796e-03 | 1.940202569999999920e-03
5.194500000001192087e-03 | 1.942280970000000032e-03
5.201800000000143462e-03 | 1.946437789999999959e-03
5.216400000001435860e-03 | 1.954751419999999854e-03
5.240800000000161649e-03 | 1.968618259999999932e-03
5.243800000000032810e-03 | 1.970280980000000022e-03
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
