iic-jku/TinyWhisper/ihp130/release/v.1.0.0/doc/MPW-rejection-test-statistics.pdf

Device Statistic
devStat revision: 1.0.0
Check Finished: 30-MAR-2026 18:48:17 Top cell name: SoC4219
Technology: SG13
BEOL: AL-BEOL
290729 nmos transistors
2535 nmosHV transistors
290835 pmos transistor
1485 pmosHV transistor
Digital gates: 100000 nmos, 143469 pmos
Resistors: 100 rhigh, 32 rppd, 301 rsil
10 MIM capacitors with a total area of 36 um2
Total PAD: 56 (standard PAD: 56, Solder Bumps PAD: 0, Copper Pillar PAD: 0) ,
Unbenanntes Dokument | https://dk.ihp-microelectronics.com/DownloadBereich/d...
1 of 1 | 3/30/26, 18:56
