iic-jku/TinyWhisper/ihp130/release/v.1.0.0/doc/MPW-rejection-test-drc.pdf

Tape In Check Results

Layout: | SoC4219_5.gds.gz
Tape In Check Status: OK
File: | OK
Topcelle: | OK
Layertable: | OK
Sealring: | OK
LBE: | OK
Dimension: | OK
Rev: | PDK Version: UNKNOWN

Tape In Checks and DRC runs with no errors.

Name: Pretl
Firstname: Harald
Company: Johannes Kepler Uni Linz --> extern File name: SoC4219_5.gds.gz
Top cell name: SoC4219
Testfield: unknown_testfield
Check Summe: 1ae88675097f8dd8c7bb68c965c5a6d4 Sent: 30-03-2026, 18:25:10
registered size: (None mm X None mm )
calculated size: (1.936 mm X 1.936 mm))
ID (use this as reference for questions): 59423

******************************** Tape-In-Check
******************************** DRC revision: rev250109
LayVer Version: 5.8.154
Unbenanntes Dokument | https://dk.ihp-microelectronics.com/DownloadBereich/s...
1 of 2 | 3/30/26, 18:56

No DRC errors found.

Unbenanntes Dokument | https://dk.ihp-microelectronics.com/DownloadBereich/s...
2 of 2 | 3/30/26, 18:56
