iic-jku/TinyWhisper/ihp130/macros/iqmod/verification/cace/results/iqmod_mfb_lpf_ota_core/Adc_ol_dB_mm.png

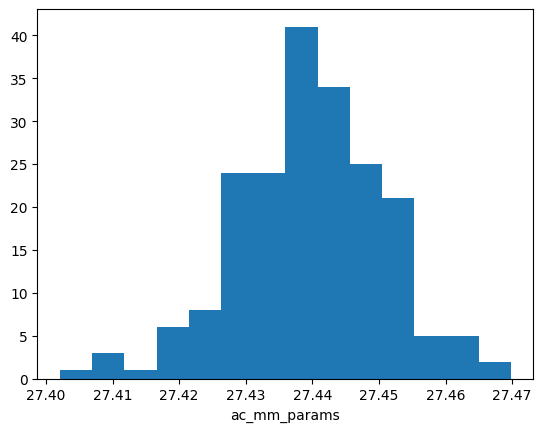
ihp130/macros/iqmod/verification/cace/results/iqmod_mfb_lpf_ota_core/Adc_ol_dB_mm.png
