iic-jku/TinyWhisper/ihp130/macros/iqmod/verification/cace/results/iqmod_mfb_lpf_ota_core/CMRR_dc_dB_mc.png

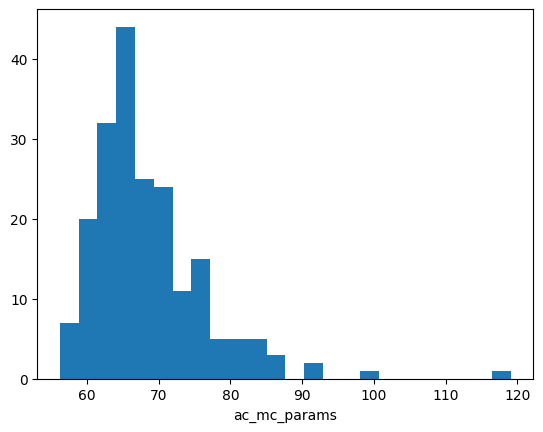
ihp130/macros/iqmod/verification/cace/results/iqmod_mfb_lpf_ota_core/CMRR_dc_dB_mc.png
