iic-jku/TinyWhisper/ihp130/macros/iqmod/verification/cace/results/iqmod_mfb_lpf_ota_core/fcu_vs_vdd.png

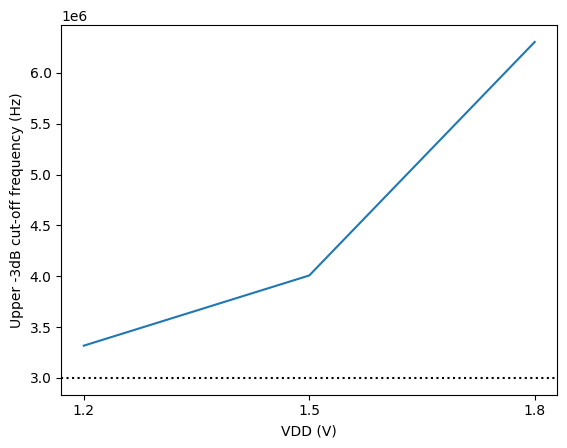
ihp130/macros/iqmod/verification/cace/results/iqmod_mfb_lpf_ota_core/fcu_vs_vdd.png
