iic-jku/TinyWhisper/ihp130/macros/riscv/testbenches/cocotb/dsmod/results/psd/dsmod_analog_ord2_osr64_amp-3dBFS.png

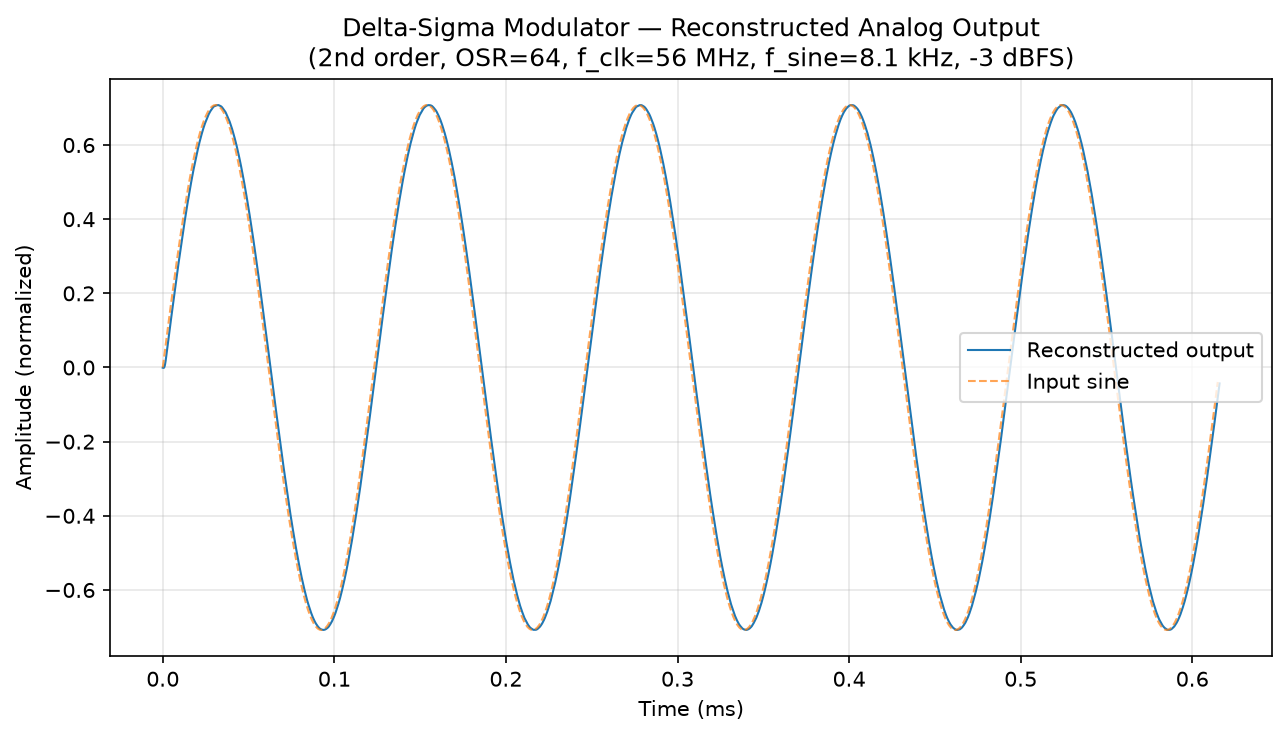
ihp130/macros/riscv/testbenches/cocotb/dsmod/results/psd/dsmod_analog_ord2_osr64_amp-3dBFS.png
