iic-jku/TinyWhisper/ihp130/macros/riscv/testbenches/cocotb/dsmod/results/ramp/dsmod_ramp_ord2_osr64.png

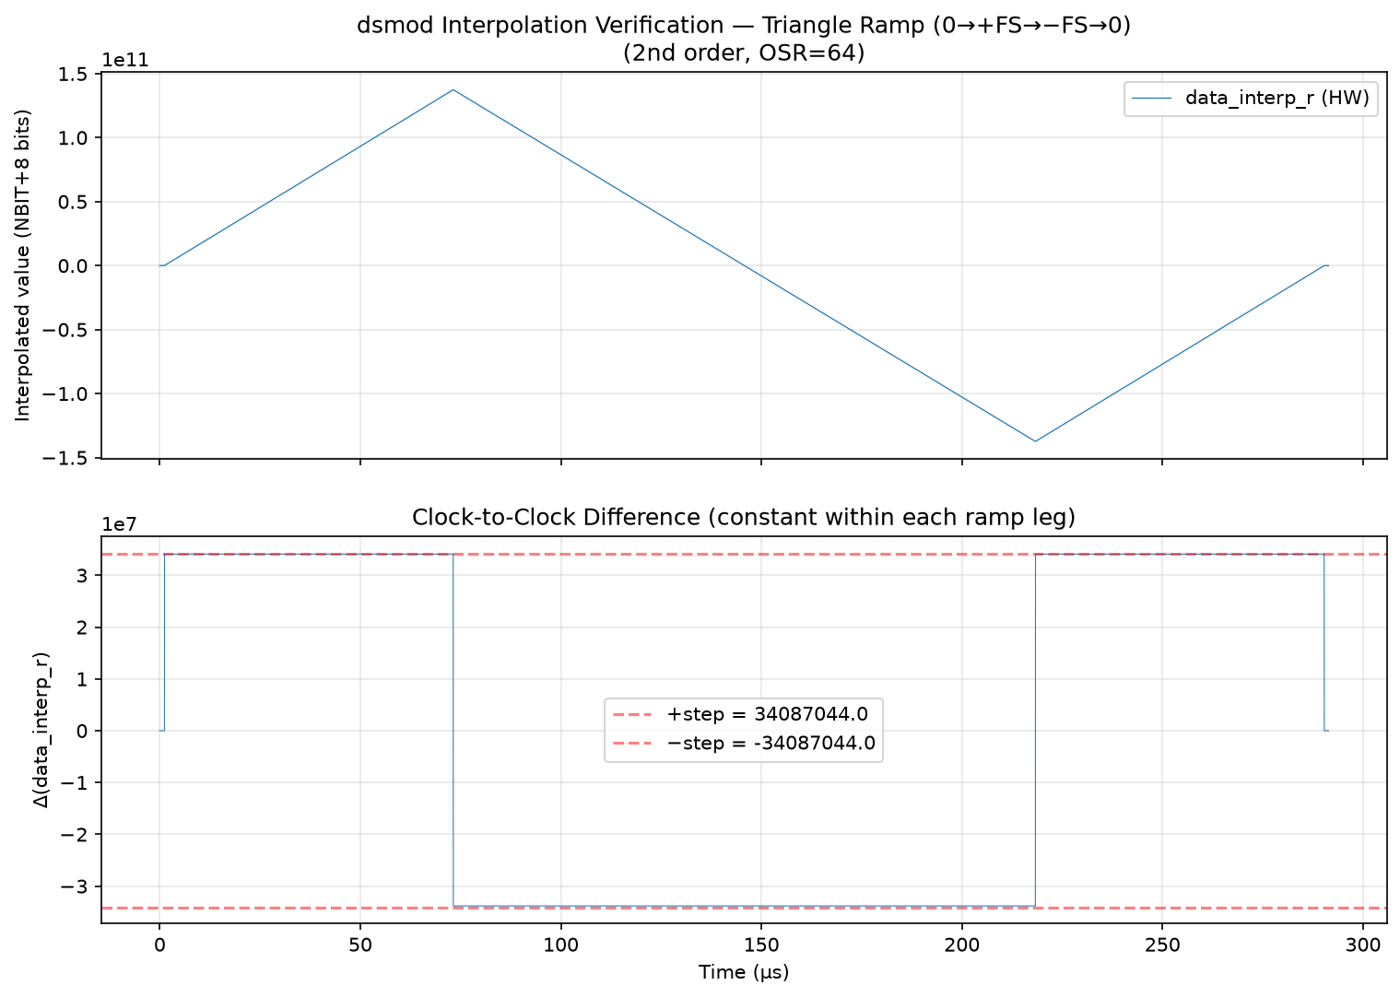
ihp130/macros/riscv/testbenches/cocotb/dsmod/results/ramp/dsmod_ramp_ord2_osr64.png
