iic-jku/TinyWhisper/ihp130/macros/riscv/testbenches/cocotb/dsmod/results/sndr/dsmod_sndr_ord2_osr64.png

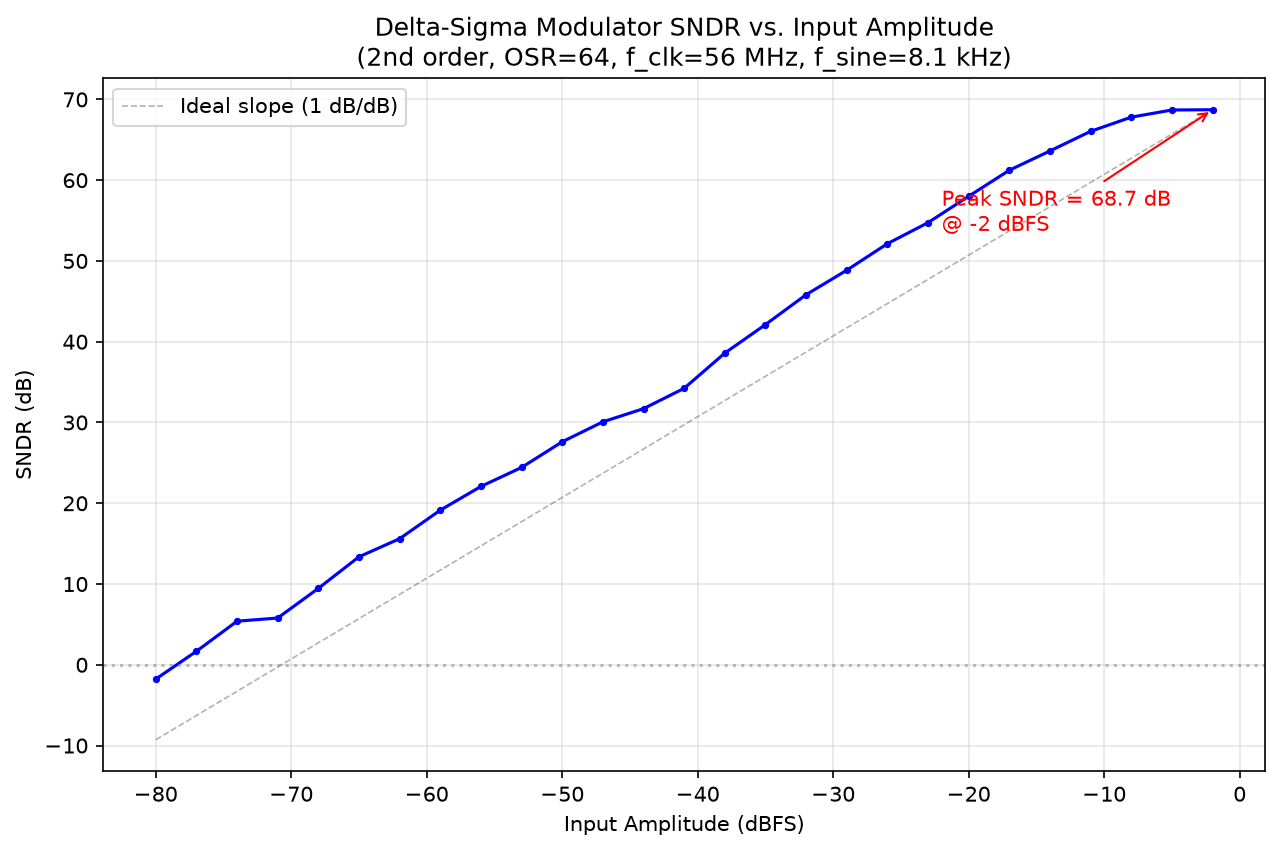
ihp130/macros/riscv/testbenches/cocotb/dsmod/results/sndr/dsmod_sndr_ord2_osr64.png
