iic-jku/TinyWhisper/sky130/macros/iqmod/verification/cace/results/wspr_tx_iqmod_mfb_lpf/Adc_cl_dB_mc.png

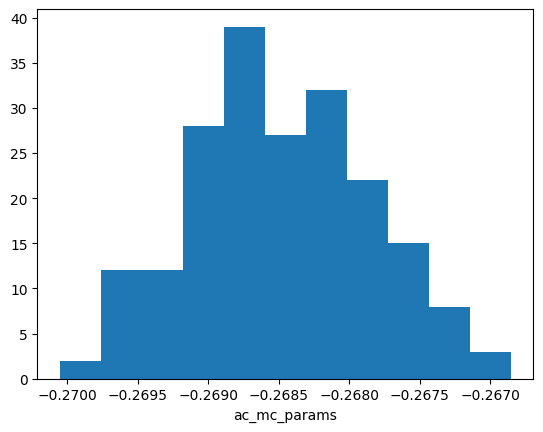
sky130/macros/iqmod/verification/cace/results/wspr_tx_iqmod_mfb_lpf/Adc_cl_dB_mc.png
