iic-jku/TinyWhisper/sky130/macros/iqmod/verification/cace/results/wspr_tx_iqmod_mfb_lpf/CMRR_dc_dB_mc.png

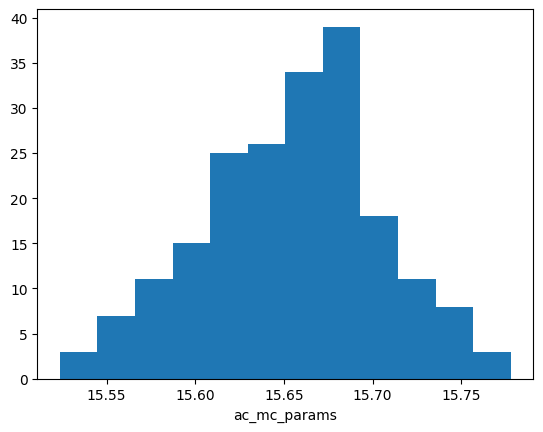
sky130/macros/iqmod/verification/cace/results/wspr_tx_iqmod_mfb_lpf/CMRR_dc_dB_mc.png
