iic-jku/TinyWhisper/sky130/macros/iqmod/verification/cace/results/wspr_tx_iqmod_mfb_lpf/fcu_tt_mm.png

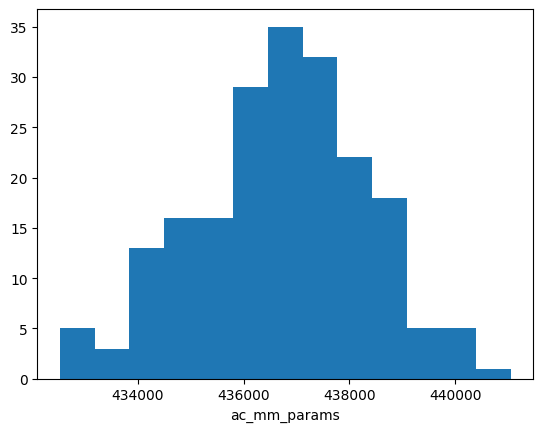
sky130/macros/iqmod/verification/cace/results/wspr_tx_iqmod_mfb_lpf/fcu_tt_mm.png
