iic-jku/TinyWhisper/sky130/macros/iqmod/verification/cace/results/wspr_tx_iqmod_mfb_lpf_ota_core/Adc_ol_dB_tt_mm.png

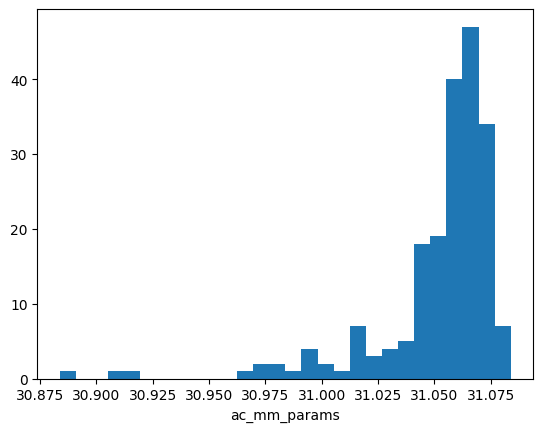
sky130/macros/iqmod/verification/cace/results/wspr_tx_iqmod_mfb_lpf_ota_core/Adc_ol_dB_tt_mm.png
