iic-jku/TinyWhisper/sky130/macros/iqmod/verification/cace/results/wspr_tx_iqmod_mfb_lpf_ota_core/CMRR_dc_dB_mc.png

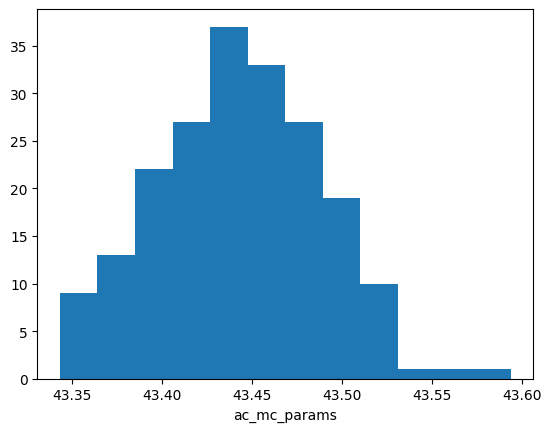
sky130/macros/iqmod/verification/cace/results/wspr_tx_iqmod_mfb_lpf_ota_core/CMRR_dc_dB_mc.png
