iic-jku/TinyWhisper/ihp130/macros/iqmod/scripts/filter_designer/3rd_order_mfb_lpf_designer.pdf

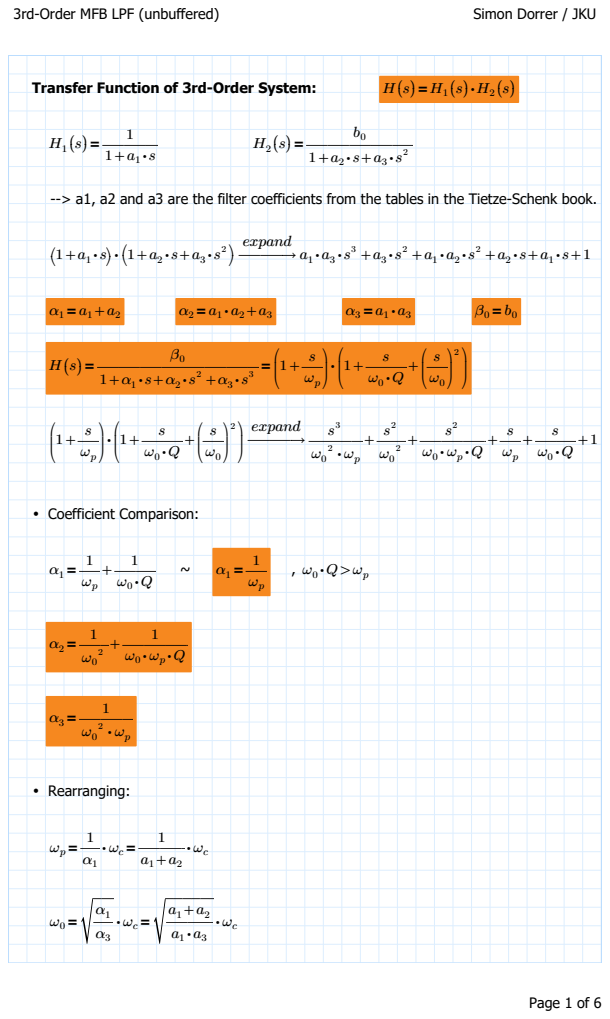
[picture p125: page 1]
3rd-Order MFB LPF (unbuffered); Simon Dorrer / JKU; Transfer Function of 3rd-Order System:; expand; Coefficient Comparison:; Rearranging:; Page 1 of 6

--> a1, a2 and a3 are the filter coefficients from the tables in the Tietze-Schenk book.

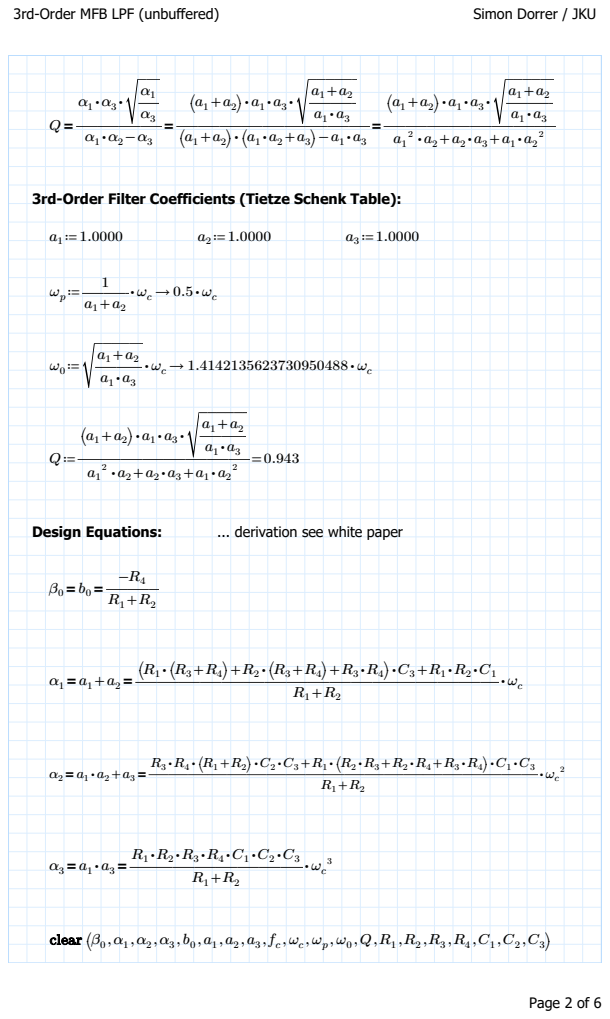
[picture p126: page 2]
Design Equations:; ... derivation see white paper; clear ⎛⎝β; Page 2 of 6

3rd-Order Filter Coefficients (Tietze Schenk Table):

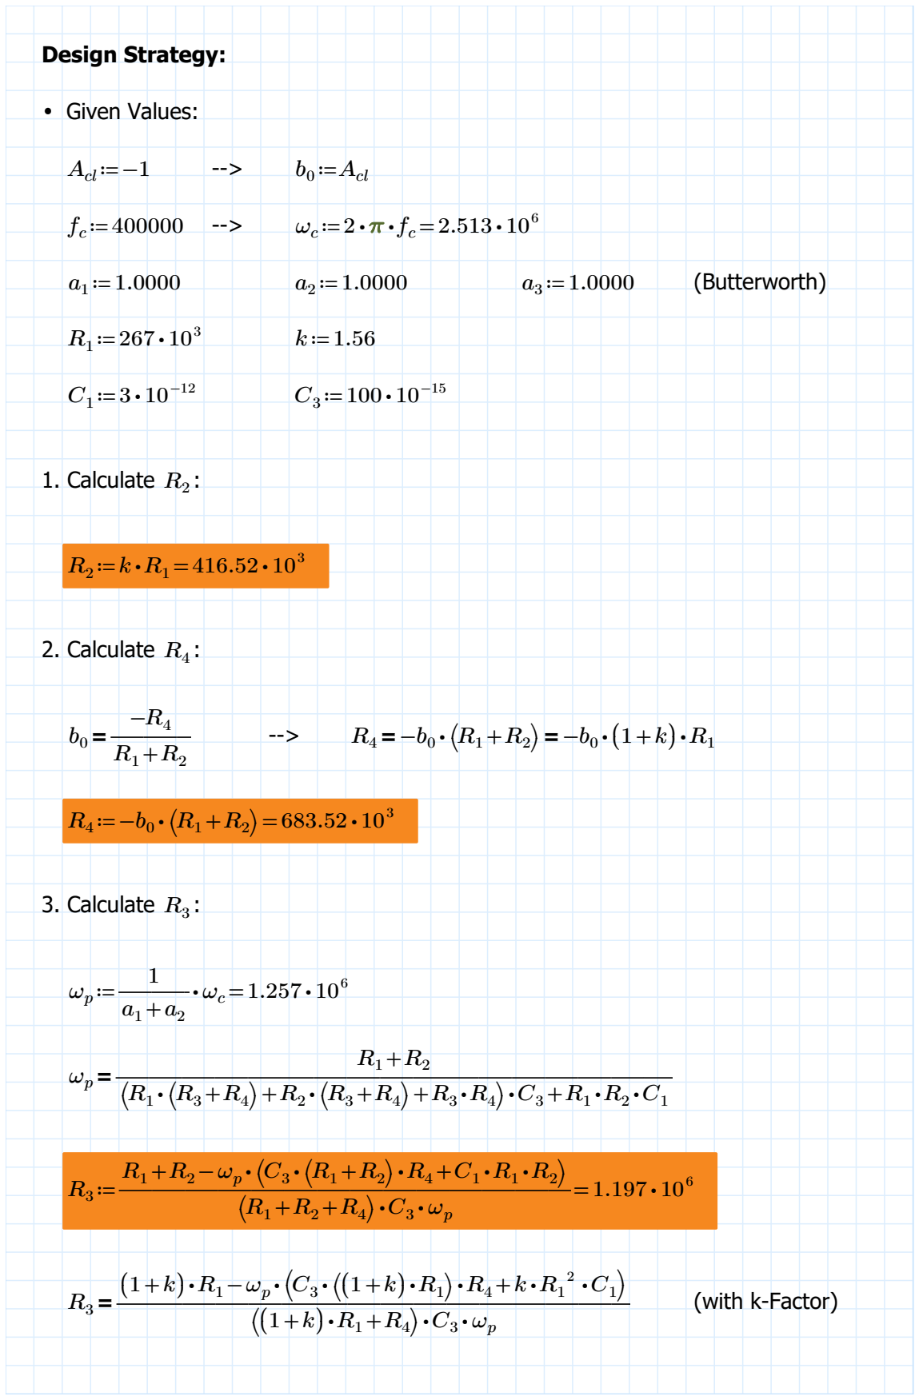
[picture p127: figure]
Design Strategy:; Given Values:; Acl≔-1; b0≔Acl; (Butterworth); 1. Calculate R : 2; 2. Calculate R : 4; 3. Calculate R : 3; (with k-Factor)

Page 3 of 6

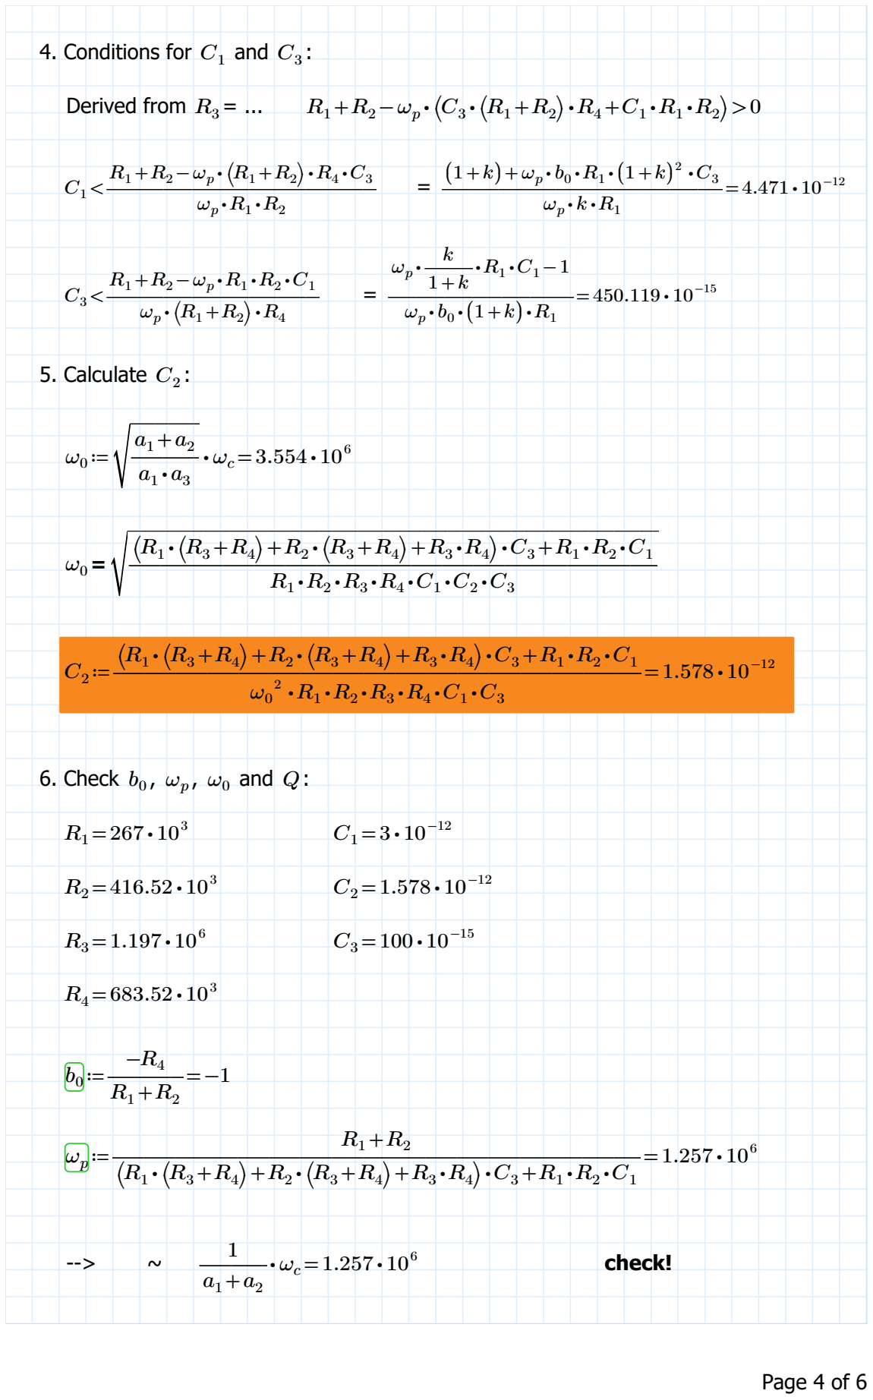
[picture p128: figure]
4. Conditions for; and; Derived from; 5. Calculate C : 2; 6. Check b; check!; Page 4 of 6
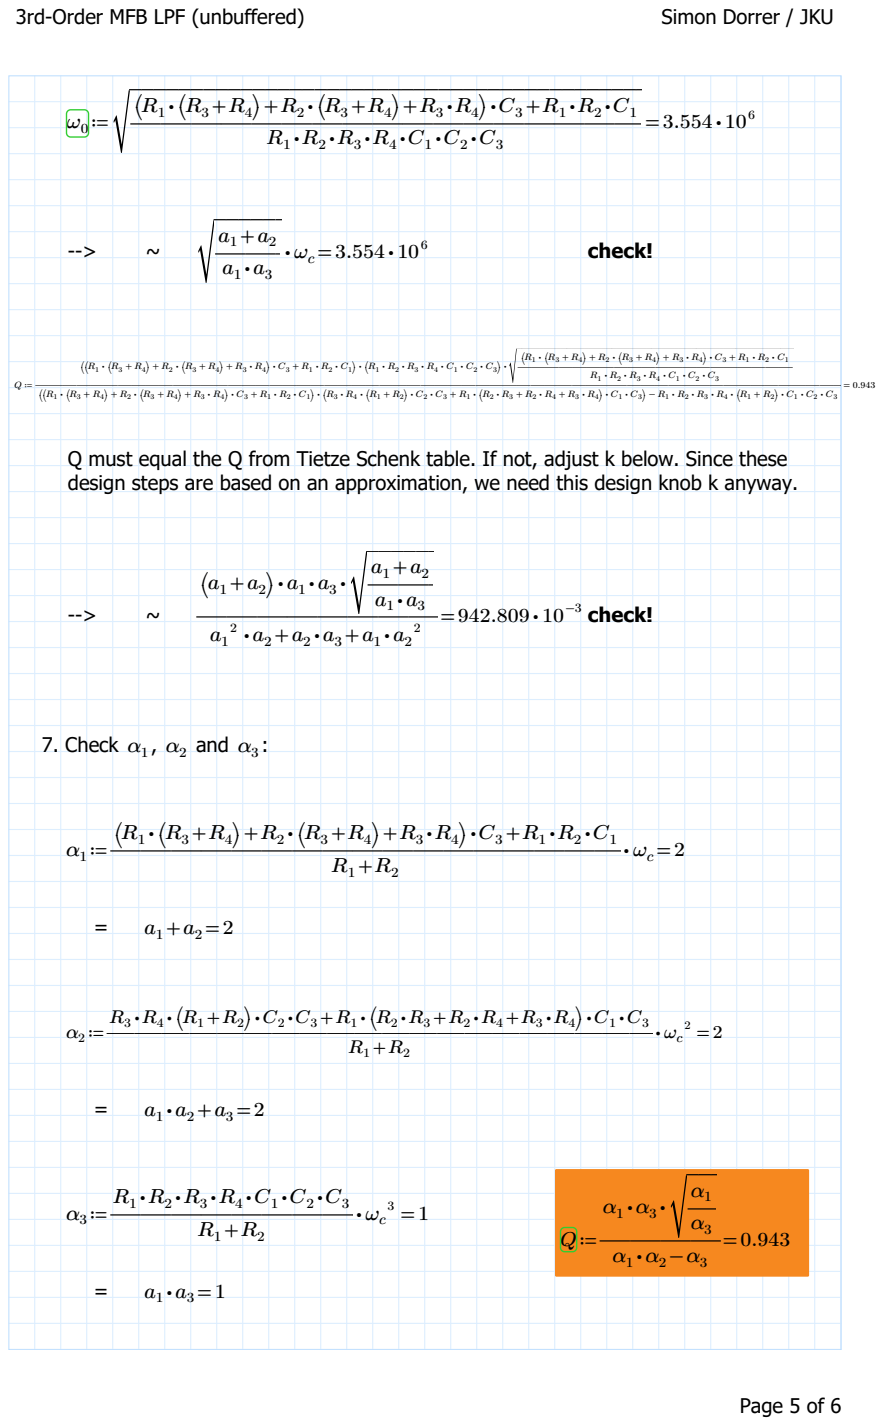
[picture p129: page 5]
check!; 942.809 ⋅ 10⁻³ check!; 7. Check α; and; Page 5 of 6

Q must equal the Q from Tietze Schenk table. If not, adjust k below. Since these
design steps are based on an approximation, we need this design knob k anyway.

8.) Fine-Tuning:

Instead of a single massive equation Q(k), use this recommended iterative design:

1.
2.
3.
Input | R | , | , | , | and the desired filter coefficients | , | , 1 C1 | C3 | k | a1 a2 | a3
Go through steps 1 to 6.
Adjust k:

If calculated Q is too high, decrease k. If calculated Q is too low, increase k.

In the end, the Q in 6.) has to equal the Q from the coefficient formula in 7.). In this case, Q＝0.943 . The calculated value of Q deviates a little from the theoretical value, since it has been approximated, as shown above. However, with the k-factor, the correct filter approximation can still be achieved. When this is the case, all the coefficients in 7.) also equal the theoretical value, coming from Tietze Schenk tables.

9.) Input Impedance:

The input impedance at dc can be approximated with Zin0≔R1+R2+R3=1.88 ⋅ 10⁶

The input impedance transfer function will be derived soon...

Page 6 of 6
