iic-jku/TinyWhisper/ihp130/macros/iqmod/testbenches/xschem/plot_simulations/figures/iqmod_mfb_lpf_riscv_tb_tran.pdf

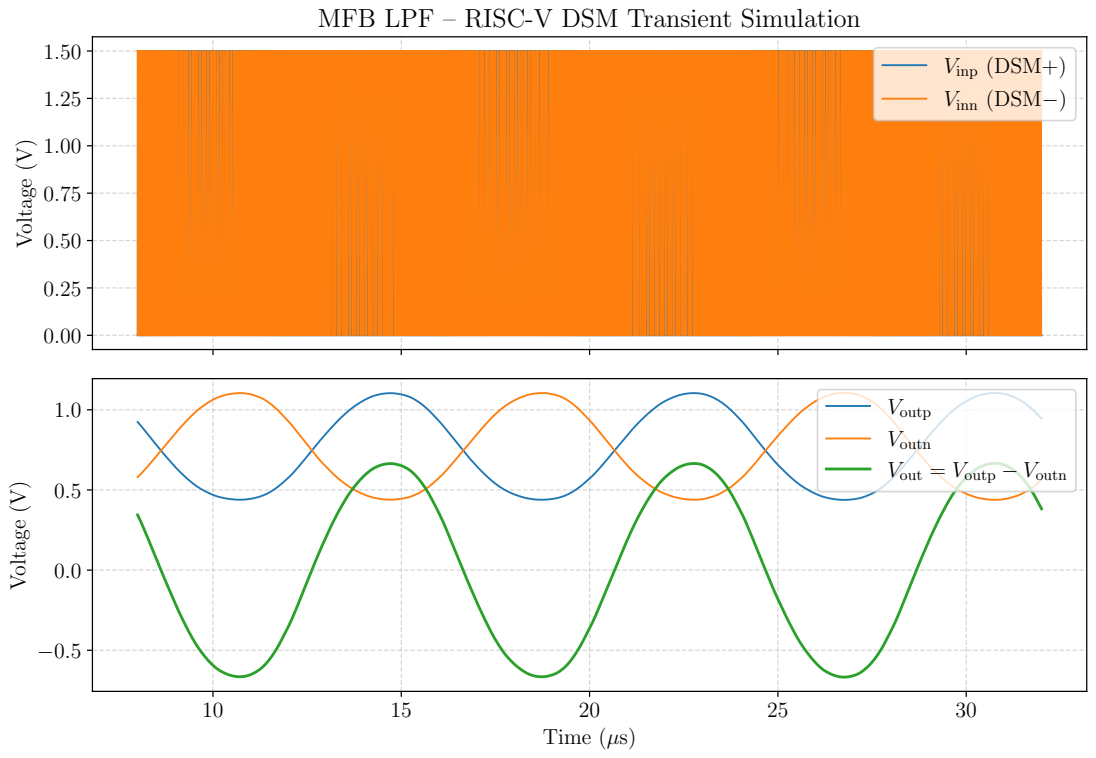
[picture p130: page 1]
Voltage (V); Time (µs)

MFB LPF – RISC-V DSM Transient Simulation

Vinp (DSM+)
Vinn (DSM−)

Voutp

Voutn Vout = Voutp − Voutn
