iic-jku/TinyWhisper/ihp130/macros/iqmod/scripts/filter_designer/figures/3rd_order_mfb_lpf_circuit.pdf

R

R

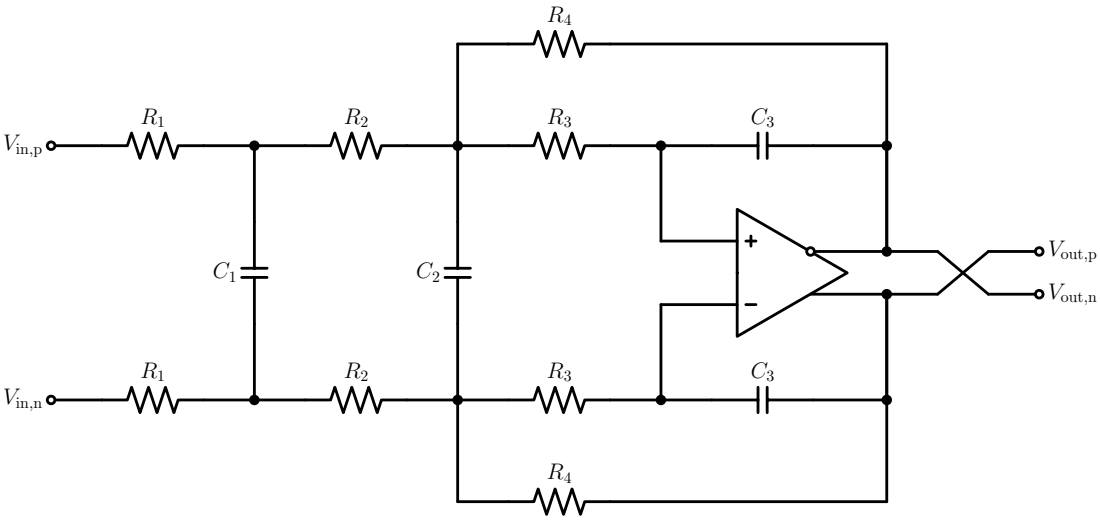
[picture p131: page 1]
Vin; Vout
