iic-jku/TinyWhisper/ihp130/macros/iqmod/scripts/filter_designer/figures/biquad_mfb_lpf_circuit.pdf

R

R

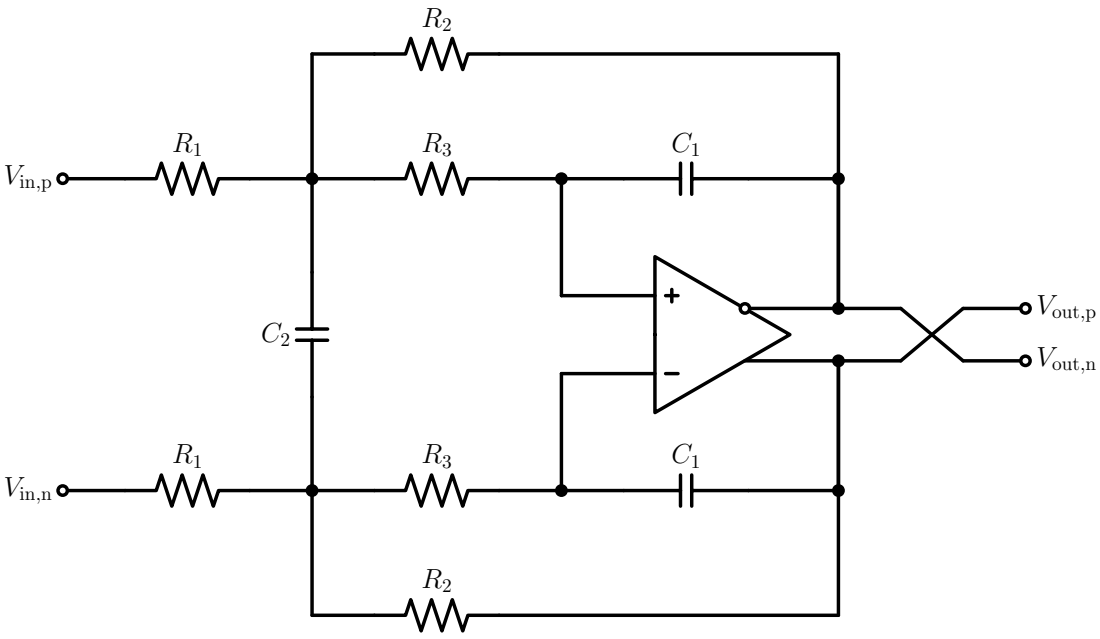
[picture p132: page 1]
Vin; Vout
