iic-jku/TinyWhisper/ihp130/macros/iqmod/scripts/sizing/figures/inverter_based_ota_barthelemy_circuit.pdf

A

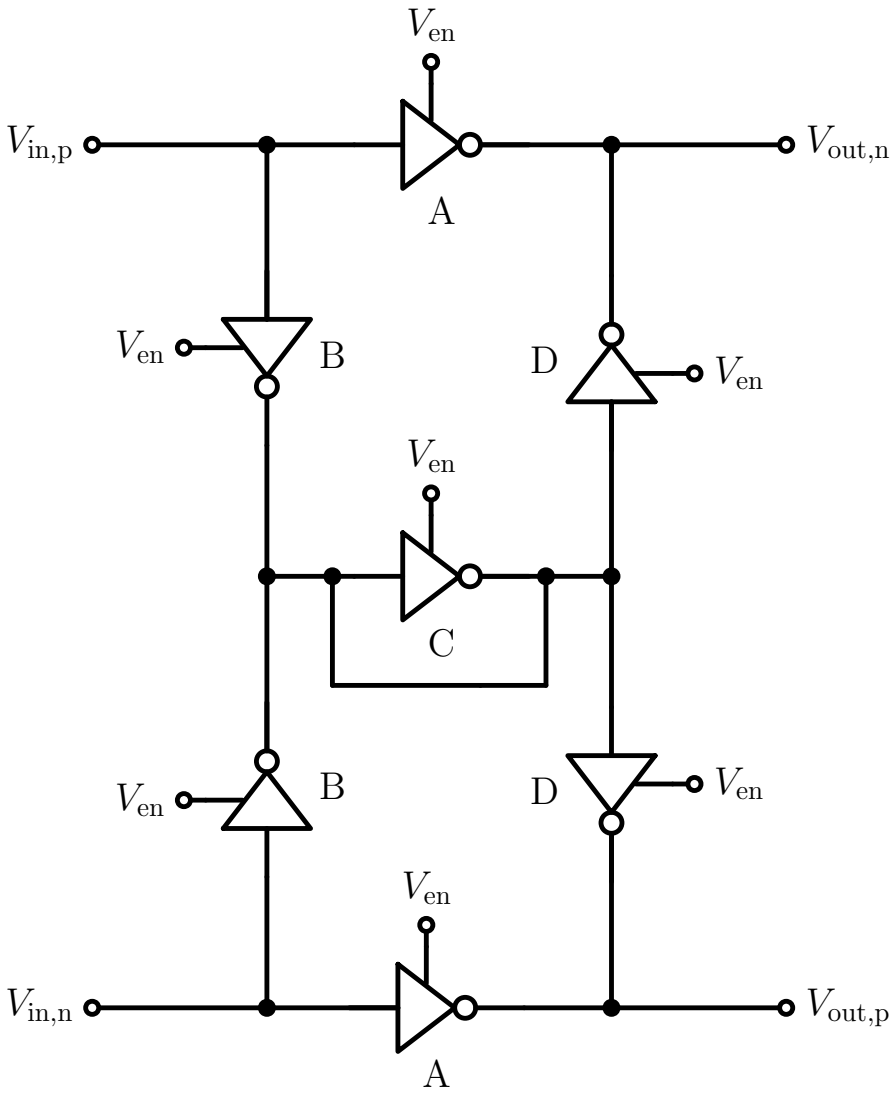
[picture p133: page 1]
Ven; Vout,n; Vout,p; Vin,n; Vin,p
