iic-jku/TinyWhisper/ihp130/macros/iqmod/scripts/sizing/figures/inverter_based_ota_hybrid_bm_circuit.pdf

# AVen

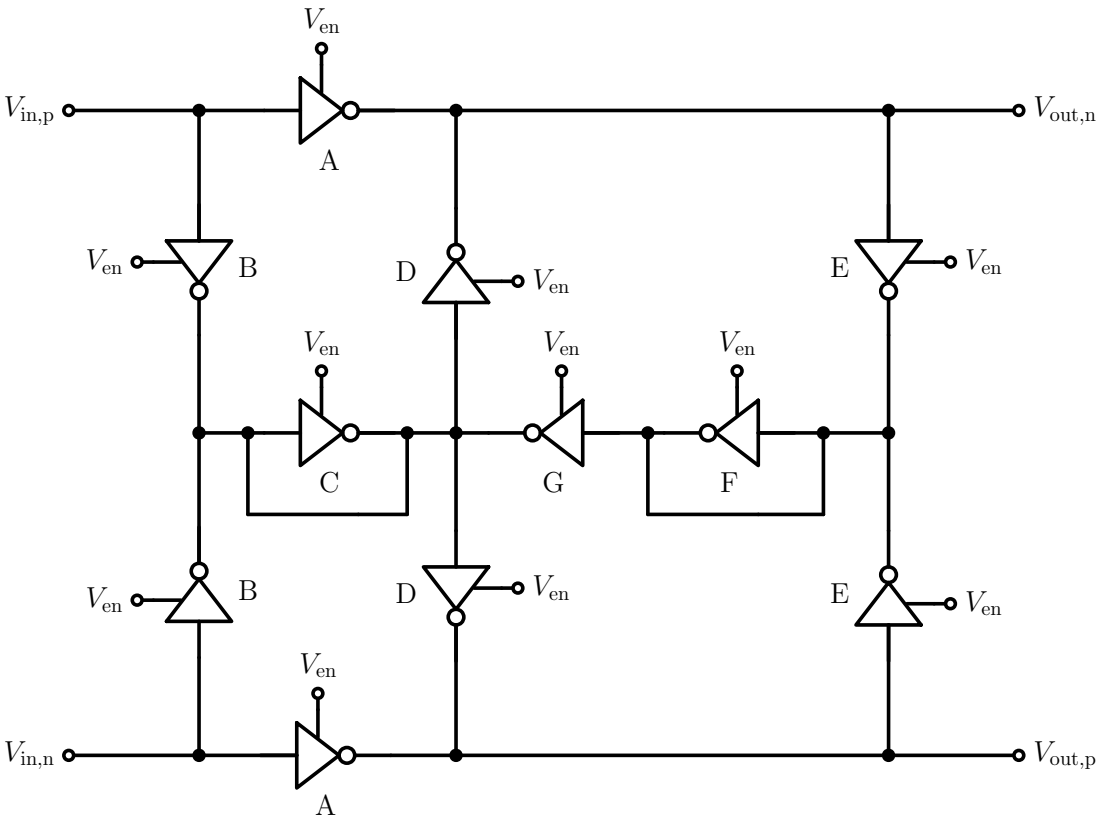
[picture p134: page 1]
Ven; AVen; Vin; CVen; GVen; FVen; Vout
