iic-jku/TinyWhisper/ihp130/macros/iqmod/scripts/sizing/figures/inverter_based_ota_hybrid_bn_circuit.pdf

# AVen

# EVen

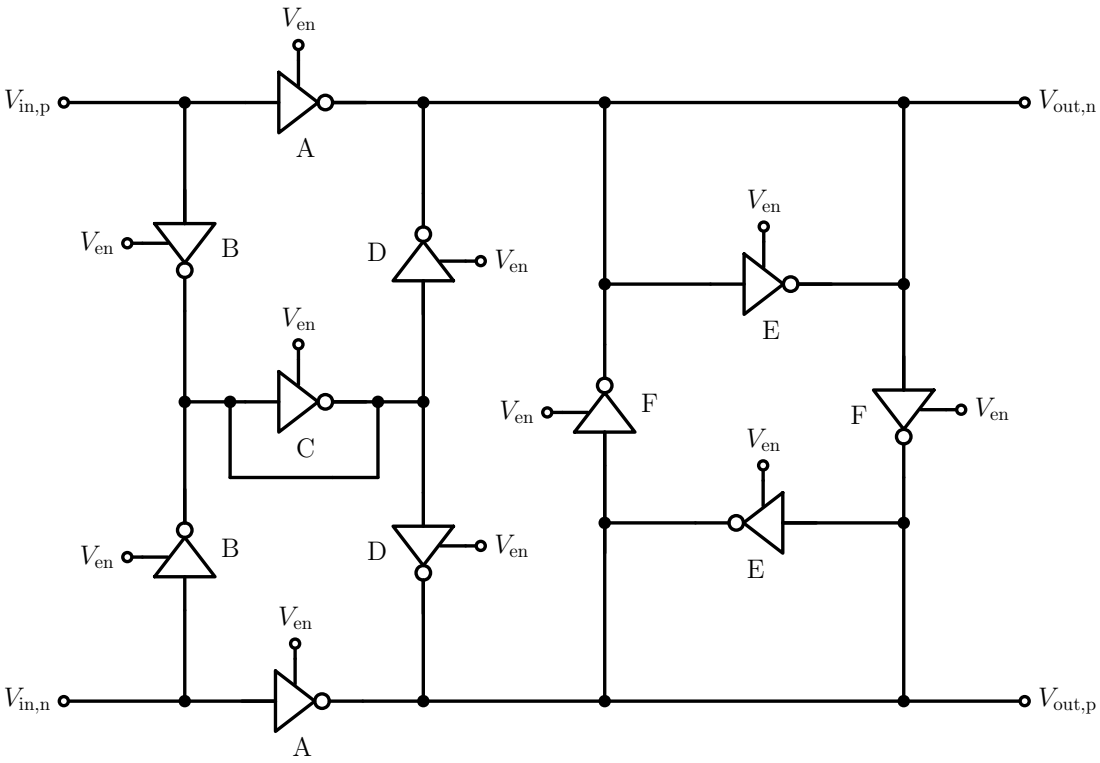
[picture p135: page 1]
Ven; AVen; Vin; CVen; EVen; Vout
