iic-jku/TinyWhisper/ihp130/macros/iqmod/scripts/sizing/figures/inverter_based_ota_manfredini_circuit.pdf

# AVen

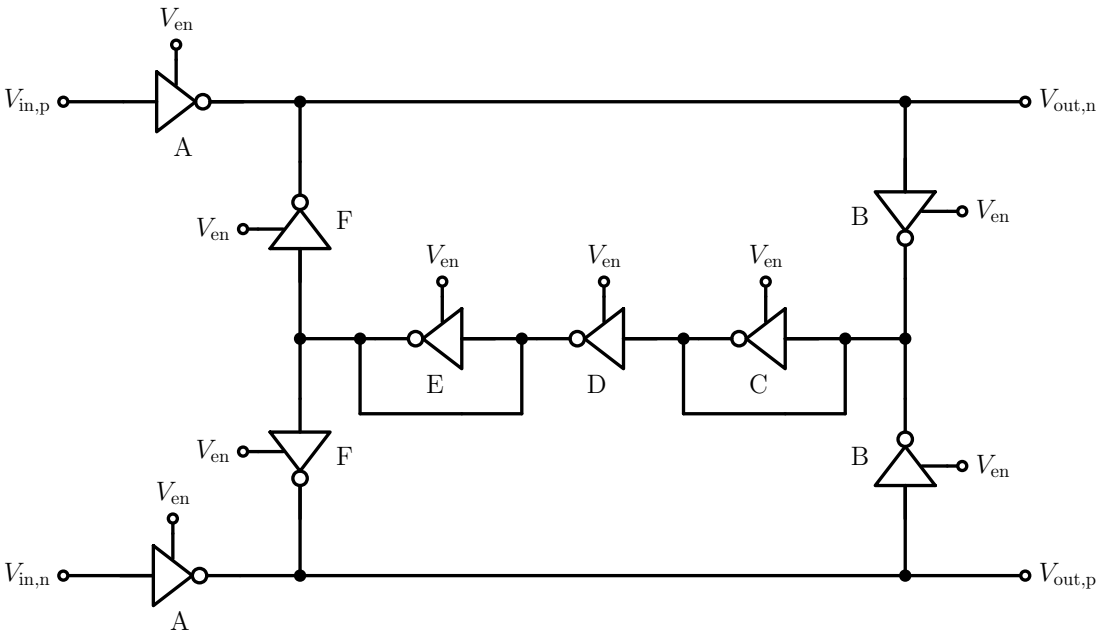
[picture p136: page 1]
en Ven; AVen; Vin; EVen; DVen; CVen; Ven; Vout
