iic-jku/TinyWhisper/ihp130/macros/iqmod/scripts/sizing/figures/inverter_based_ota_nauta_circuit.pdf

# AVen

# BVen

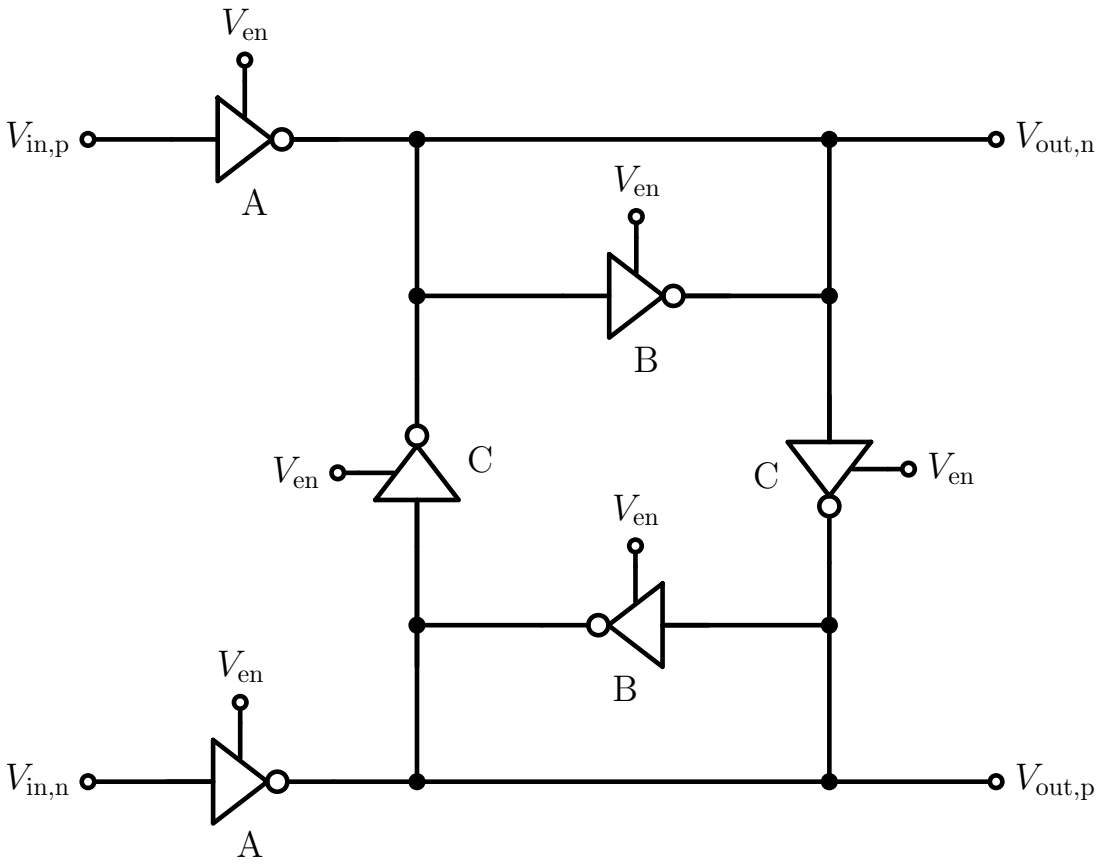
[picture p137: page 1]
AVen; Vin; BVen; Vout; Ven
