iic-jku/TinyWhisper/sky130/macros/iqmod/scripts/filter_designer/figures/3rd_order_mfb_lpf_circuit.pdf

R

R

Vin; Vout
