iic-jku/TinyWhisper/sky130/macros/iqmod/scripts/filter_designer/figures/biquad_mfb_lpf_circuit.pdf

R

R

Vin; Vout
