iic-jku/TinyWhisper/ihp130/macros/iqmod/netlist/pex/iqmod_mixer_tg_pex.spice

* PEX produced on Sat Mar 28 07:06:41 PM CET 2026 using /foss/tools/sak/sak-pex.sh with m=1 and s=1
* NGSPICE file created from iqmod_mixer_tg_pex.ext - technology: ihp-sg13g2

.subckt iqmod_mixer_tg_pex VDD di_tg_ctrl VSS v_b v_a di_tg_ctrl_n
X0 v_b di_tg_ctrl_n v_b VSS sg13_lv_nmos ad=0.57p pd=3.38u as=93.24p ps=0.91908m w=3u l=0.13u
X1 v_b di_tg_ctrl v_b VDD sg13_lv_pmos ad=1.71p pd=9.38u as=0 ps=0 w=9u l=0.13u
X2 v_b di_tg_ctrl v_a VSS sg13_lv_nmos ad=0.57p pd=3.38u as=0.57p ps=3.38u w=3u l=0.13u
X3 v_a di_tg_ctrl v_b VSS sg13_lv_nmos ad=0.57p pd=3.38u as=0.57p ps=3.38u w=3u l=0.13u
X4 v_b di_tg_ctrl v_b VDD sg13_lv_pmos ad=1.71p pd=9.38u as=0 ps=0 w=9u l=0.13u
X5 v_b di_tg_ctrl_n v_b VSS sg13_lv_nmos ad=0.57p pd=3.38u as=0 ps=0 w=3u l=0.13u
X6 v_a di_tg_ctrl v_b VSS sg13_lv_nmos ad=0.57p pd=3.38u as=0.57p ps=3.38u w=3u l=0.13u
X7 v_b di_tg_ctrl v_a VSS sg13_lv_nmos ad=0.57p pd=3.38u as=0.57p ps=3.38u w=3u l=0.13u
X8 v_b di_tg_ctrl v_b VDD sg13_lv_pmos ad=1.71p pd=9.38u as=0 ps=0 w=9u l=0.13u
X9 v_b di_tg_ctrl v_b VDD sg13_lv_pmos ad=1.71p pd=9.38u as=0 ps=0 w=9u l=0.13u
X10 v_b di_tg_ctrl_n v_a VDD sg13_lv_pmos ad=1.71p pd=9.38u as=1.71p ps=9.38u w=9u l=0.13u
X11 v_b di_tg_ctrl_n v_a VDD sg13_lv_pmos ad=1.71p pd=9.38u as=1.71p ps=9.38u w=9u l=0.13u
X12 v_b di_tg_ctrl_n v_b VSS sg13_lv_nmos ad=0.57p pd=3.38u as=0 ps=0 w=3u l=0.13u
X13 v_b di_tg_ctrl v_a VSS sg13_lv_nmos ad=0.57p pd=3.38u as=0.57p ps=3.38u w=3u l=0.13u
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
X96 v_a di_tg_ctrl_n v_b VDD sg13_lv_pmos ad=1.71p pd=9.38u as=1.71p ps=9.38u w=9u l=0.13u
X97 v_a di_tg_ctrl_n v_b VDD sg13_lv_pmos ad=1.71p pd=9.38u as=1.71p ps=9.38u w=9u l=0.13u
X98 v_b di_tg_ctrl_n v_b VSS sg13_lv_nmos ad=0.57p pd=3.38u as=0 ps=0 w=3u l=0.13u
X99 v_b di_tg_ctrl_n v_a VDD sg13_lv_pmos ad=1.71p pd=9.38u as=1.71p ps=9.38u w=9u l=0.13u
X100 v_b di_tg_ctrl v_a VSS sg13_lv_nmos ad=0.57p pd=3.38u as=0.57p ps=3.38u w=3u l=0.13u
X101 v_a di_tg_ctrl_n v_b VDD sg13_lv_pmos ad=1.71p pd=9.38u as=1.71p ps=9.38u w=9u l=0.13u
X102 v_b di_tg_ctrl_n v_a VDD sg13_lv_pmos ad=1.71p pd=9.38u as=1.71p ps=9.38u w=9u l=0.13u
X103 v_a di_tg_ctrl_n v_b VDD sg13_lv_pmos ad=1.71p pd=9.38u as=1.71p ps=9.38u w=9u l=0.13u
X104 v_b di_tg_ctrl_n v_b VSS sg13_lv_nmos ad=0.57p pd=3.38u as=0 ps=0 w=3u l=0.13u
X105 v_a di_tg_ctrl v_b VSS sg13_lv_nmos ad=0.57p pd=3.38u as=0.57p ps=3.38u w=3u l=0.13u
X106 v_b di_tg_ctrl v_a VSS sg13_lv_nmos ad=0.57p pd=3.38u as=0.57p ps=3.38u w=3u l=0.13u
X107 v_a di_tg_ctrl_n v_b VDD sg13_lv_pmos ad=1.71p pd=9.38u as=1.71p ps=9.38u w=9u l=0.13u
C0 v_a VSS 53.518f
C1 v_b VSS 86.7685f
C2 di_tg_ctrl VSS 16.3123f
C3 di_tg_ctrl_n VSS 17.6566f
C4 VDD VSS 13.3327f
.ends
