iic-jku/TinyWhisper/ihp130/macros/iqmod/netlist/layout/iqmod_top_klayout.cir

* Extracted by KLayout with SG13G2 LVS runset on : 25/07/2026 19:28

.SUBCKT iqmod_top VDD VSS di_analog_en di_ds_I_n di_ds_I_p di_ds_Q_n di_ds_Q_p
+ di_lo_I di_lo_Ix di_lo_Q di_lo_Qx di_spdt_ctrl_I di_spdt_ctrl_Q vinn_I vinn_Q
+ vinp_I vinp_Q voutn_I_RF voutn_Q_RF voutp_I_RF voutp_Q_RF
X$1 VSS di_ds_Q_n di_lo_Qx vinn_Q VDD voutn_Q_RF di_ds_Q_p di_analog_en
+ di_spdt_ctrl_Q vinp_Q voutp_Q_RF di_lo_Q iqmod_top_half
X$2 VSS di_ds_I_n di_lo_Ix vinn_I VDD voutn_I_RF di_ds_I_p di_analog_en
+ di_spdt_ctrl_I vinp_I voutp_I_RF di_lo_I iqmod_top_half
.ENDS iqmod_top

.SUBCKT iqmod_top_half VSS di_ds_I_n di_lo_Ix vinn_I VDD voutn_I_RF di_ds_I_p
+ di_analog_en di_spdt_ctrl_I vinp_I voutp_I_RF di_lo_I
X$1 di_spdt_ctrl_I \$47 vinp_I di_ds_I_p VSS VDD iqmod_spdt_switch
X$3 \$22 VDD di_lo_Ix VSS voutn_I_RF di_lo_I voutp_I_RF \$42 iqmod_mixer
X$8 di_spdt_ctrl_I \$21 vinn_I di_ds_I_n VSS VDD iqmod_spdt_switch
X$16 di_analog_en VSS \$47 \$21 VDD \$42 \$22 iqmod_mfb_lpf
.ENDS iqmod_top_half

.SUBCKT iqmod_mixer vinn_IF VDD vinn_LO VSS voutn_RF vinp_LO voutp_RF vinp_IF
M$1 voutn_RF \$I208 vinn_IF VSS sg13_lv_nmos L=0.13u W=108u AS=20.97p AD=20.52p
+ PS=124.98u PD=121.68u rfmode=0
M$37 voutn_RF \$I207 voutn_RF VSS sg13_lv_nmos L=0.13u W=54u AS=10.26p
+ AD=10.71p PS=60.84u PD=64.14u rfmode=0
M$55 voutp_RF \$I210 vinp_IF VSS sg13_lv_nmos L=0.13u W=108u AS=20.97p
+ AD=20.52p PS=124.98u PD=121.68u rfmode=0
M$91 voutp_RF \$I209 voutp_RF VSS sg13_lv_nmos L=0.13u W=54u AS=10.26p
+ AD=10.71p PS=60.84u PD=64.14u rfmode=0
M$109 voutn_RF \$I207 vinn_IF VDD sg13_lv_pmos L=0.13u W=324u AS=62.91p
+ AD=61.56p PS=346.98u PD=337.68u rfmode=0
M$145 voutn_RF \$I208 voutn_RF VDD sg13_lv_pmos L=0.13u W=162u AS=30.78p
+ AD=32.13p PS=168.84u PD=178.14u rfmode=0
M$163 voutp_RF \$I209 vinp_IF VDD sg13_lv_pmos L=0.13u W=324u AS=62.91p
+ AD=61.56p PS=346.98u PD=337.68u rfmode=0
M$199 voutp_RF \$I210 voutp_RF VDD sg13_lv_pmos L=0.13u W=162u AS=30.78p
+ AD=32.13p PS=168.84u PD=178.14u rfmode=0
M$217 VSS VSS VSS VSS sg13_lv_nmos L=0.13u W=52u AS=13.78p AD=13.78p PS=105.56u
+ PD=105.56u rfmode=0
M$218 VSS \$I219 \$I208 VSS sg13_lv_nmos L=0.13u W=54u AS=10.26p AD=10.26p
+ PS=74.52u PD=74.52u rfmode=0
M$274 VSS \$I222 \$I210 VSS sg13_lv_nmos L=0.13u W=54u AS=10.26p AD=10.26p
+ PS=74.52u PD=74.52u rfmode=0
M$329 VDD VDD VDD VDD sg13_lv_pmos L=0.13u W=156u AS=41.34p AD=41.34p
+ PS=261.56u PD=261.56u rfmode=0
M$330 VDD \$I219 \$I208 VDD sg13_lv_pmos L=0.13u W=162u AS=30.78p AD=30.78p
+ PS=182.52u PD=182.52u rfmode=0
M$386 VDD \$I222 \$I210 VDD sg13_lv_pmos L=0.13u W=162u AS=30.78p AD=30.78p
+ PS=182.52u PD=182.52u rfmode=0
M$442 VSS \$I218 \$I219 VSS sg13_lv_nmos L=0.13u W=18u AS=3.42p AD=3.42p
+ PS=24.84u PD=24.84u rfmode=0
M$462 VSS \$I221 \$I222 VSS sg13_lv_nmos L=0.13u W=18u AS=3.42p AD=3.42p
+ PS=24.84u PD=24.84u rfmode=0
M$482 VDD \$I218 \$I219 VDD sg13_lv_pmos L=0.13u W=54u AS=10.26p AD=10.26p
+ PS=60.84u PD=60.84u rfmode=0
M$502 VDD \$I221 \$I222 VDD sg13_lv_pmos L=0.13u W=54u AS=10.26p AD=10.26p
+ PS=60.84u PD=60.84u rfmode=0
M$522 VDD vinn_LO \$I213 VDD sg13_lv_pmos L=0.13u W=12u AS=2.28p AD=2.28p
+ PS=13.52u PD=13.52u rfmode=0
M$526 VDD \$I212 \$I211 VDD sg13_lv_pmos L=0.13u W=6u AS=1.14p AD=1.14p
+ PS=6.76u PD=6.76u rfmode=0
M$530 VDD vinp_LO \$I216 VDD sg13_lv_pmos L=0.13u W=12u AS=2.28p AD=2.28p
+ PS=13.52u PD=13.52u rfmode=0
M$534 VDD \$I215 \$I214 VDD sg13_lv_pmos L=0.13u W=6u AS=1.14p AD=1.14p
+ PS=6.76u PD=6.76u rfmode=0
M$538 VSS vinn_LO \$I213 VSS sg13_lv_nmos L=0.13u W=4u AS=0.76p AD=0.76p
+ PS=5.52u PD=5.52u rfmode=0
M$542 VSS \$I212 \$I211 VSS sg13_lv_nmos L=0.13u W=2u AS=0.38p AD=0.38p
+ PS=2.76u PD=2.76u rfmode=0
M$546 VSS vinp_LO \$I216 VSS sg13_lv_nmos L=0.13u W=4u AS=0.76p AD=0.76p
+ PS=5.52u PD=5.52u rfmode=0
M$550 VSS \$I215 \$I214 VSS sg13_lv_nmos L=0.13u W=2u AS=0.38p AD=0.38p
+ PS=2.76u PD=2.76u rfmode=0
M$554 VSS \$I217 \$I212 VSS sg13_lv_nmos L=0.13u W=6u AS=1.14p AD=1.14p
+ PS=8.28u PD=8.28u rfmode=0
M$562 VSS \$I213 \$I217 VSS sg13_lv_nmos L=0.13u W=6u AS=1.14p AD=1.14p
+ PS=8.28u PD=8.28u rfmode=0
M$570 VSS \$I212 \$I218 VSS sg13_lv_nmos L=0.13u W=6u AS=1.14p AD=1.14p
+ PS=8.28u PD=8.28u rfmode=0
M$578 VSS \$I220 \$I215 VSS sg13_lv_nmos L=0.13u W=6u AS=1.14p AD=1.14p
+ PS=8.28u PD=8.28u rfmode=0
M$586 VSS \$I216 \$I220 VSS sg13_lv_nmos L=0.13u W=6u AS=1.14p AD=1.14p
+ PS=8.28u PD=8.28u rfmode=0
M$594 VSS \$I215 \$I221 VSS sg13_lv_nmos L=0.13u W=6u AS=1.14p AD=1.14p
+ PS=8.28u PD=8.28u rfmode=0
M$602 VDD \$I217 \$I212 VDD sg13_lv_pmos L=0.13u W=18u AS=3.42p AD=3.42p
+ PS=20.28u PD=20.28u rfmode=0
M$610 VDD \$I213 \$I217 VDD sg13_lv_pmos L=0.13u W=18u AS=3.42p AD=3.42p
+ PS=20.28u PD=20.28u rfmode=0
M$618 VDD \$I212 \$I218 VDD sg13_lv_pmos L=0.13u W=18u AS=3.42p AD=3.42p
+ PS=20.28u PD=20.28u rfmode=0
M$626 VDD \$I220 \$I215 VDD sg13_lv_pmos L=0.13u W=18u AS=3.42p AD=3.42p
+ PS=20.28u PD=20.28u rfmode=0
M$634 VDD \$I216 \$I220 VDD sg13_lv_pmos L=0.13u W=18u AS=3.42p AD=3.42p
+ PS=20.28u PD=20.28u rfmode=0
M$642 VDD \$I215 \$I221 VDD sg13_lv_pmos L=0.13u W=18u AS=3.42p AD=3.42p
+ PS=20.28u PD=20.28u rfmode=0
M$649 \$I213 VDD \$I225 VSS sg13_lv_nmos L=0.13u W=6u AS=1.29p AD=1.29p
+ PS=9.58u PD=9.58u rfmode=0
M$655 \$I216 VDD \$I228 VSS sg13_lv_nmos L=0.13u W=6u AS=1.29p AD=1.29p
+ PS=9.58u PD=9.58u rfmode=0
M$661 \$I213 VSS \$I225 VDD sg13_lv_pmos L=0.13u W=18u AS=3.87p AD=3.87p
+ PS=23.58u PD=23.58u rfmode=0
M$667 \$I216 VSS \$I228 VDD sg13_lv_pmos L=0.13u W=18u AS=3.87p AD=3.87p
+ PS=23.58u PD=23.58u rfmode=0
M$674 VSS \$I224 \$I207 VSS sg13_lv_nmos L=0.13u W=54u AS=10.26p AD=10.26p
+ PS=74.52u PD=74.52u rfmode=0
M$730 VSS \$I227 \$I209 VSS sg13_lv_nmos L=0.13u W=54u AS=10.26p AD=10.26p
+ PS=74.52u PD=74.52u rfmode=0
M$786 VDD \$I224 \$I207 VDD sg13_lv_pmos L=0.13u W=162u AS=30.78p AD=30.78p
+ PS=182.52u PD=182.52u rfmode=0
M$842 VDD \$I227 \$I209 VDD sg13_lv_pmos L=0.13u W=162u AS=30.78p AD=30.78p
+ PS=182.52u PD=182.52u rfmode=0
M$898 VSS \$I223 \$I224 VSS sg13_lv_nmos L=0.13u W=18u AS=3.42p AD=3.42p
+ PS=24.84u PD=24.84u rfmode=0
M$918 VSS \$I226 \$I227 VSS sg13_lv_nmos L=0.13u W=18u AS=3.42p AD=3.42p
+ PS=24.84u PD=24.84u rfmode=0
M$938 VDD \$I223 \$I224 VDD sg13_lv_pmos L=0.13u W=54u AS=10.26p AD=10.26p
+ PS=60.84u PD=60.84u rfmode=0
M$958 VDD \$I226 \$I227 VDD sg13_lv_pmos L=0.13u W=54u AS=10.26p AD=10.26p
+ PS=60.84u PD=60.84u rfmode=0
M$982 VDD \$I211 \$I212 VDD sg13_lv_pmos L=0.13u W=6u AS=1.14p AD=1.14p
+ PS=6.76u PD=6.76u rfmode=0
M$990 VDD \$I214 \$I215 VDD sg13_lv_pmos L=0.13u W=6u AS=1.14p AD=1.14p
+ PS=6.76u PD=6.76u rfmode=0
M$998 VSS \$I211 \$I212 VSS sg13_lv_nmos L=0.13u W=2u AS=0.38p AD=0.38p
+ PS=2.76u PD=2.76u rfmode=0
M$1006 VSS \$I214 \$I215 VSS sg13_lv_nmos L=0.13u W=2u AS=0.38p AD=0.38p
+ PS=2.76u PD=2.76u rfmode=0
M$1010 VSS \$I225 \$I211 VSS sg13_lv_nmos L=0.13u W=6u AS=1.14p AD=1.14p
+ PS=8.28u PD=8.28u rfmode=0
M$1018 VSS \$I211 \$I223 VSS sg13_lv_nmos L=0.13u W=6u AS=1.14p AD=1.14p
+ PS=8.28u PD=8.28u rfmode=0
M$1026 VSS \$I228 \$I214 VSS sg13_lv_nmos L=0.13u W=6u AS=1.14p AD=1.14p
+ PS=8.28u PD=8.28u rfmode=0
M$1034 VSS \$I214 \$I226 VSS sg13_lv_nmos L=0.13u W=6u AS=1.14p AD=1.14p
+ PS=8.28u PD=8.28u rfmode=0
M$1042 VDD \$I225 \$I211 VDD sg13_lv_pmos L=0.13u W=18u AS=3.42p AD=3.42p
+ PS=20.28u PD=20.28u rfmode=0
M$1050 VDD \$I211 \$I223 VDD sg13_lv_pmos L=0.13u W=18u AS=3.42p AD=3.42p
+ PS=20.28u PD=20.28u rfmode=0
M$1058 VDD \$I228 \$I214 VDD sg13_lv_pmos L=0.13u W=18u AS=3.42p AD=3.42p
+ PS=20.28u PD=20.28u rfmode=0
M$1066 VDD \$I214 \$I226 VDD sg13_lv_pmos L=0.13u W=18u AS=3.42p AD=3.42p
+ PS=20.28u PD=20.28u rfmode=0
.ENDS iqmod_mixer

.SUBCKT iqmod_spdt_switch di_spdt_ctrl v_c v_a v_b VSS VDD
M$1 v_b \$8 v_c VSS sg13_lv_nmos L=0.13u W=6u AS=1.29p AD=1.29p PS=9.58u
+ PD=9.58u rfmode=0
M$7 v_a \$7 v_c VSS sg13_lv_nmos L=0.13u W=6u AS=1.29p AD=1.29p PS=9.58u
+ PD=9.58u rfmode=0
M$13 v_b \$7 v_c VDD sg13_lv_pmos L=0.13u W=36u AS=7.74p AD=7.74p PS=44.58u
+ PD=44.58u rfmode=0
M$19 v_a \$8 v_c VDD sg13_lv_pmos L=0.13u W=36u AS=7.74p AD=7.74p PS=44.58u
+ PD=44.58u rfmode=0
M$25 VDD VDD VDD VDD sg13_lv_pmos L=0.13u W=24u AS=6.36p AD=6.36p PS=38.12u
+ PD=38.12u rfmode=0
M$26 VDD di_spdt_ctrl \$8 VDD sg13_lv_pmos L=0.13u W=12u AS=2.28p AD=2.28p
+ PS=12.76u PD=12.76u rfmode=0
M$30 VDD \$8 \$7 VDD sg13_lv_pmos L=0.13u W=12u AS=2.28p AD=2.28p PS=12.76u
+ PD=12.76u rfmode=0
M$33 VSS VSS VSS VSS sg13_lv_nmos L=0.13u W=4u AS=1.06p AD=1.06p PS=8.12u
+ PD=8.12u rfmode=0
M$34 VSS di_spdt_ctrl \$8 VSS sg13_lv_nmos L=0.13u W=2u AS=0.38p AD=0.38p
+ PS=2.76u PD=2.76u rfmode=0
M$38 VSS \$8 \$7 VSS sg13_lv_nmos L=0.13u W=2u AS=0.38p AD=0.38p PS=2.76u
+ PD=2.76u rfmode=0
.ENDS iqmod_spdt_switch
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
