iic-jku/TinyWhisper/ihp130/macros/iqmod/netlist/pex/iqmod_mfb_lpf_pex_MODE1.spice

* PEX produced on Sat Mar 28 10:02:44 PM CET 2026 using /foss/tools/sak/sak-pex.sh with m=1 and s=1
* NGSPICE file created from iqmod_mfb_lpf_pex.ext - technology: ihp-sg13g2

.subckt iqmod_mfb_lpf_pex voutp vinp voutn vinn VDD VSS di_filter_en
X0 VSS iqmod_mfb_lpf_pex_half_0.iqmod_mfb_lpf_pex_ota_core_hybrid_bm_half_0.iqmod_mfb_lpf_pex_ota_core_inv_NF20$1_1.vin voutn VSS sg13_lv_nmos ad=0.19p pd=1.38u as=0.19p ps=1.38u w=1u l=1u
X1 VSS iqmod_mfb_lpf_pex_half_1.iqmod_mfb_lpf_pex_ota_core_hybrid_bm_half_0.iqmod_mfb_lpf_pex_ota_core_tg$1_0.v_b voutn VSS sg13_lv_nmos ad=0.19p pd=1.38u as=0.19p ps=1.38u w=1u l=1u
X2 iqmod_mfb_lpf_pex_half_1.iqmod_mfb_lpf_pex_ota_core_hybrid_bm_half_0.iqmod_mfb_lpf_pex_ota_core_tg$1_0.v_b iqmod_mfb_lpf_pex_half_1.iqmod_mfb_lpf_pex_ota_core_hybrid_bm_half_0.iqmod_mfb_lpf_pex_ota_core_tg$1_0.v_a VDD VDD sg13_lv_pmos ad=1.14p pd=6.38u as=1.14p ps=6.38u w=6u l=1u
X3 VSS VSS VSS VSS sg13_lv_nmos ad=0.34p pd=2.68u as=2.362n ps=3.33876m w=1u l=1u
X4 iqmod_mfb_lpf_pex_half_1.iqmod_mfb_lpf_pex_ota_core_hybrid_bm_half_0.iqmod_mfb_lpf_pex_ota_core_inv_NF20$1_0.vout voutp VSS VSS sg13_lv_nmos ad=0.19p pd=1.38u as=0.19p ps=1.38u w=1u l=1u
X5 VDD voutn iqmod_mfb_lpf_pex_half_1.iqmod_mfb_lpf_pex_ota_core_hybrid_bm_half_0.iqmod_mfb_lpf_pex_ota_core_inv_NF20$1_0.vout VDD sg13_lv_pmos ad=1.14p pd=6.38u as=1.14p ps=6.38u w=6u l=1u
X6 voutn iqmod_mfb_lpf_pex_half_0.iqmod_mfb_lpf_pex_ota_core_hybrid_bm_half_0.iqmod_mfb_lpf_pex_ota_core_inv_NF20$1_1.vin VDD VDD sg13_lv_pmos ad=1.14p pd=6.38u as=1.14p ps=6.38u w=6u l=1u
X7 iqmod_mfb_lpf_pex_half_1.iqmod_mfb_lpf_pex_ota_core_hybrid_bm_half_0.iqmod_mfb_lpf_pex_ota_core_tg$1_0.v_b iqmod_mfb_lpf_pex_half_1.iqmod_mfb_lpf_pex_ota_core_hybrid_bm_half_0.iqmod_mfb_lpf_pex_ota_core_tg$1_0.di_tg_ctrl_n iqmod_mfb_lpf_pex_half_1.iqmod_mfb_lpf_pex_ota_core_hybrid_bm_half_0.iqmod_mfb_lpf_pex_ota_core_tg$1_0.v_a VDD sg13_lv_pmos ad=1.14p pd=6.38u as=1.14p ps=6.38u w=6u l=0.13u
X8 VSS VSS VSS rhigh l=27u w=0.5u
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
