iic-jku/TinyWhisper/ihp130/macros/riscv/rtl/i2c_master_mc.sv

// SPDX-FileCopyrightText: 2025-2026 The TinyWhisper Team
// SPDX-License-Identifier: Apache-2.0 WITH SHL-2.1
/*
 * Original Author: Chance Reimer
 * Adapted by Jonathan Hager to better fit the TinyWhisper project
 * Date: 4/12/2020
 **********************************************************************************************************************************************************
 * Purpose: Create I2C Master used for writing and reading addresses from the device. Camera Control Interface (CCI) is built off of fast I2C (40KHz clock)
 *          This master module must be fed a 100MHz clock, and must be given the information to send. Any different input clocks will require modification
 *          to the clock divider.
 **********************************************************************************************************************************************************
 * Notes:   * For writing, this module expects the number of reads and writes to be explicit, i.e, how long until termination
 *          * Note that all $display is non-sythesizable, and is removed during synthesis, no need to comment out
 *          * Second Note: This code doesn't currently monitor if the lines are busy, therefore not multimaster friendly
 **********************************************************************************************************************************************************
 * Specific info:
 *          * We are targeting ADT7420, look at minimum hold time for start, stop, and data hold times
 *          * For start indication need 0.6 uS or 60 clocks of 100MHz, before negedge of idle to first low of scl (minimum so this time could be immediate)
 *          * For stop indication need 0.6us or 60 clocks of 100MHz,  before going low to high on sda
 *          * Want at least 0.02us for data setup time, which is 2 clock cycles after negedge of scl
 *          * Finally, for data hld time (before we change clock) minumum is 0.03 second before posedge scl, which is 3 clock cycles
 *
 **********************************************************************************************************************************************************
 * How it works: The input clock is 100MHz for this module, and the output scl is tied to the clock line only during transmission
 *               SDA line only changes on negedge of 400kHz clock
 *               SCL line is tied directly to the 400kHz clock generated by this module
 */
/* verilator lint_off WIDTHEXPAND */
module i2c_master_mc (
    input i_clk,  //input clock to the module @100MHz (or whatever crystal you have on the board)
    input reset_n,  //reset for creating a known start condition
    input [15:0] clock_division,
    input [7:0]      i_addr_w_rw,//7 bit address, LSB is the read write bit, with 0 being write, 1 being read
    input [15:0] i_sub_addr,  //contains sub addr to send to slave, partition is decided on bit_sel
    input            i_sub_len,//denotes whether working with an 8 bit or 16 bit sub_addr, 0 is 8bit, 1 is 16 bit
    input [23:0]     i_byte_len,//denotes whether a single or sequential read or write will be performed (denotes number of bytes to read or write)
    input [7:0] i_data_write,  //Data to write if performing write action
    input req_trans,  //denotes when to start a new transaction
    input next_chunk_ready,
    input read_next_byte,
    input force_stop,
    input use_subaddr,

    /** For Reads **/
    output reg [7:0] data_out,
    output reg       valid_out,
    output reg byte_ready,

    /** I2C Lines **/
    output logic scl_o,  //i2c clck line, output by this module, 400 kHz
    input  logic sda_i,
    output logic sda_o,
    output logic sda_oe,

    /** Comms to Master Module **/
    output reg req_data_chunk,  //Request master to send new data chunk in i_data_write
    output reg busy,  //denotes whether module is currently communicating with a slave
    output reg       nack            //denotes whether module is encountering a nack from slave (only activates when master is attempting to contact device)
);

  reg [3:0] state;
  reg [3:0] next_state;
  reg reg_sda_o;
  reg [7:0] addr;
  reg rw;
  reg [15:0] sub_addr;
  reg sub_len;
  reg [23:0] byte_len;
  reg en_scl;
  reg byte_sent;
  reg [23:0] num_byte_sent;
  reg [2:0] cntr;
  reg [7:0] byte_sr;
  reg read_sub_addr_sent_flag;
  reg [7:0] data_to_write;
  reg [7:0] data_in_sr;

  //For generation of 400KHz clock
  reg clk_i2c;
  reg [15:0] clk_i2c_cntr;

  //For taking a sample of the scl and sda
  reg [1:0] sda_curr;    //So this one is asynchronous especially with replies from the slave, must have synchronization chain of 2
  reg sda_prev;
  reg scl_prev, scl_curr;  //master will always drive this line, so it doesn't matter

  reg ack_in_prog;  //For sending acks during read
  reg ack_nack;
  reg en_end_indicator;

  reg grab_next_data;
  reg scl_is_high;
  reg scl_is_low;

  reg handled_force_stop;

  //For state machine
  localparam [3:0] IDLE        = 4'd0,
                 START       = 4'd1,
                 RESTART     = 4'd2,
                 SLAVE_ADDR  = 4'd3,
                 SUB_ADDR    = 4'd4,

                 READ        = 4'd5,
                 WRITE       = 4'd6,
                 GRAB_DATA   = 4'd7,
                 ACK_NACK_RX = 4'd8,
                 ACK_NACK_TX = 4'd9,
                 STOP        = 4'hA,
                 RELEASE_BUS = 4'hB,
                 READ_IDLE   = 4'hC;

  //Modify These Parameters for other targets
  // localparam [15:0] DIV_100MHZ = 16'd125;         //desire 400KHz, have 100MHz, thus (1/(400*10^3)*100*10^6)/2, note div by 2 is for need to change in cycle
  localparam [7:0] START_IND_SETUP = 20,  //Time before negedge of scl
  DATA_HOLD_TIME = 3,  //Time after negedge that scl is held
  STOP_IND_SETUP = 15;  //Time after posedge of scl before stop occurs

  //clk_i2c 400KHz is synchronous to i_clk, so no need for 2 reg synchronization chain in other blocks
  //Note: For other input clks (125MHz) use fractional clock divider
  always @(posedge i_clk) begin
    if (!reset_n) {clk_i2c_cntr, clk_i2c} <= 17'b1;
    else if (!en_scl) {clk_i2c_cntr, clk_i2c} <= 17'b1;
    else if (state == GRAB_DATA || state == READ_IDLE) begin
       // Nothing
      clk_i2c_cntr <= clk_i2c_cntr;
    end
    else begin
      clk_i2c_cntr <= clk_i2c_cntr + 1;
      if (clk_i2c_cntr == clock_division - 1) begin
        clk_i2c <= !clk_i2c;
        clk_i2c_cntr <= 0;
      end
    end
  end

  //Main FSM
  always @(posedge i_clk) begin
    if (!reset_n) begin
      {data_out, valid_out} <= 0;
      {req_data_chunk, busy, nack} <= 0;
      {addr, rw, sub_addr, sub_len, byte_len, en_scl} <= 0;
      {byte_sent, num_byte_sent, cntr, byte_sr} <= 0;
      {read_sub_addr_sent_flag, data_to_write, data_in_sr} <= 0;
      {ack_nack, ack_in_prog, en_end_indicator} <= 0;
      {scl_is_high, scl_is_low, grab_next_data} <= 0;
      reg_sda_o <= 1'b1;
      sda_oe <= 1'b1;
      state <= IDLE;
      next_state <= IDLE;
      handled_force_stop <= 1'b0;
    end else begin
      // valid_out <= 1'b0;
      req_data_chunk <= 1'b0;
      case (state)
        /***
             * State: IDLE
             * Purpose: Moniter the master of this module's readiness to begin a new transaction
             * How it works: clock generation of 400KHz clock is directly tied to beginning the enable line.
             *               The 400KHz clock's cycle begins at high, 125 100MHz clock cyles pass before it is driven low,
             *               therefore next state will seek to drive sda line low, signaling a start bit.
             */
        IDLE: begin
          reg_sda_o <= 1'b1;
          sda_oe <= 1'b1;
          if (req_trans & !busy) begin
            //set busy
            busy <= 1'b1;
            //Set FSM in motion
            state <= START;
            next_state <= SLAVE_ADDR;

            //Set all master inputs to local registers to modify and or reference later
            addr <= i_addr_w_rw;
            rw <= i_addr_w_rw[0];
            sub_addr <= i_sub_len ? i_sub_addr : {i_sub_addr[7:0], 8'b0};
            sub_len <= i_sub_len;
            data_to_write <= i_data_write;
            byte_len <= i_byte_len;

            //begin the 400kHz generation
            en_scl <= 1'b1;
            reg_sda_o <= 1'b1;
            sda_oe <= 1'b1;

            //Reset flags and or counters
            nack <= 1'b0;
            read_sub_addr_sent_flag <= 1'b0;
            num_byte_sent <= 0;
            byte_sent <= 1'b0;
            handled_force_stop <= 1'b0;
          end
        end

        /***
             * State: START
             * Purpose: Enable the start signal and move to next appropriate address
             * How it works: Since this will only be utilized when starting a write or read,
             *               we know that if read_sub_addr_sent_flag is high, then we are performing a
             *               read, and that information would have been sent in the input addr. Else,
             *               even if it was a write, it does not matter.
             */
        START: begin
          if(scl_prev & scl_curr & clk_i2c_cntr == START_IND_SETUP) begin   //check that scl is high, and that a necessary wait time is held
            reg_sda_o <= 1'b0;                                       //set start bit for negedge of clock, and toggle for the clock to begin
            if (use_subaddr) begin
               byte_sr <= {
               addr[7:1], 1'b0
               };  //Don't need to check read or write, will always have write in a read request as well
            end else begin
            byte_sr <= addr;
            end
            state <= SLAVE_ADDR;
          end
        end

        /***
             * State: restart
             * Purpose: To toggle a repeat start
             * How it works: Must await the negedge of clk, and drive the line high.
             */
        RESTART: begin
          if (!scl_curr & scl_prev) begin
            reg_sda_o <= 1'b1;  //Set line high
          end

          if (!scl_prev & scl_curr) begin  //so i2c cntr has reset
            scl_is_high <= 1'b1;
          end

          if (scl_is_high) begin
            if (clk_i2c_cntr == START_IND_SETUP) begin  //Must wait minimum setup time
              scl_is_high <= 1'b0;
              reg_sda_o <= 1'b0;
              state <= SLAVE_ADDR;
              byte_sr <= addr;
            end
          end
        end

        /***
             * State: SLAVE_ADDR
             * Purpose: Write slave addr and based on state of system, move to sub_addr or read
             * How it works: We know that this state will go to either read or to writing the sub addr.
             *               If we reach this state again, the flag will be set, and we know we are performing
             *               a read. The setup time is inconsequential, simply need to account for hold time
             */
        SLAVE_ADDR: begin
          //When scl has fallen, we can change sda
          if (byte_sent & cntr[0]) begin
            byte_sent <= 1'b0;  //deassert the flag
            if (use_subaddr) begin
               next_state <= read_sub_addr_sent_flag ? READ : SUB_ADDR;    //Check to see if sub addr was sent, we ony reach this state again if doing a read
               byte_sr <= sub_addr[15:8];              //regardless of sub addr length, higher byte will be sent first
            end else begin
               next_state <= rw ? READ : WRITE;    //Check to see if sub addr was sent, we ony reach this state again if doing a read
               byte_sr <= rw ? byte_sr : data_to_write; //if write, want to setup the data to write to device
            end
            state <= ACK_NACK_RX;  //await for nack_ack
            // reg_sda_o <= 1'bz;  //release sda line
            sda_oe <= 1'b0;
            cntr <= 0;
          end else begin
            if (!scl_curr & scl_prev) begin
              scl_is_low <= 1'b1;
            end

            if (scl_is_low) begin
              if (clk_i2c_cntr == DATA_HOLD_TIME) begin
                {byte_sent, cntr} <= {byte_sent, cntr} + 1;       //incr cntr, with overflow being caught (due to overflow, no need to set cntr to 0)
                reg_sda_o <= byte_sr[7];  //send MSB
                sda_oe <= 1'b1;
                byte_sr <= {byte_sr[6:0], 1'b0};  //shift out MSB
                scl_is_low <= 1'b0;
              end
            end
          end
        end

        /***
             * State: Sub_addr
             * Purpose: to grab a sub address
             * How it Works: Send out the MSB of the sub_addr. If it is 16 bit sub_addr, toggle the flag,
             *               and then send MSB after receiving ACK. Once this state has finished sending
             *               sub addr, set the associated flag high, so other states may move to appropriate
             *               states.
             */
        SUB_ADDR: begin
          if (byte_sent & cntr[0]) begin
            if (sub_len) begin  //1 for 16 bit
              state      <= ACK_NACK_RX;
              next_state <= SUB_ADDR;
              sub_len    <= 1'b0;  //denote only want 8 bit next time
              byte_sr    <= sub_addr[7:0];  //set the byte shift register
            end else begin
              next_state <= rw ? RESTART : WRITE;  //move to appropriate state
              byte_sr <= rw ? byte_sr : data_to_write; //if write, want to setup the data to write to device
              read_sub_addr_sent_flag <= 1'b1;  //For dictating state of machine
            end

            cntr      <= 0;
            byte_sent <= 1'b0;  //deassert the flag
            state     <= ACK_NACK_RX;  //await for nack_ack
            // reg_sda_o <= 1'bz;  //release sda line
            sda_oe    <= 1'b0;
          end else begin
            if (!scl_curr & scl_prev) begin
              scl_is_low <= 1'b1;
            end

            if (scl_is_low) begin
              if (clk_i2c_cntr == DATA_HOLD_TIME) begin
                scl_is_low <= 1'b0;
                {byte_sent, cntr} <= {byte_sent, cntr} + 1;  //incr cntr, with overflow being caught
                reg_sda_o <= byte_sr[7];  //send MSB
                sda_oe <= 1'b1;
                byte_sr <= {byte_sr[6:0], 1'b0};  //shift out MSB
              end
            end
          end
        end

        /***
             * State: Reads
             * Purpose: Read 1 byte messages that are set on posedge of i2c_clk
             * How it Works: Need to read all 8 bits, on posedge of clock. SDA will be
             *               stable high before this occurs, thus it's fine to grab sda_prev,
             *               which is synchronous to i_clk. Every
             */
        READ: begin
          if (byte_sent) begin
            byte_sent <= 1'b0;  //reset flag
            data_out <= data_in_sr;  //put information in valid output
            valid_out <= 1'b1;  //Let master know valid output
            state <= ACK_NACK_TX;  //Send ack
            next_state <= (num_byte_sent == byte_len - 1) ? STOP : READ_IDLE;  //Have we read all bytes?
            ack_nack <= num_byte_sent == byte_len - 1;  //If true, then 1, which is a nack
            num_byte_sent <= num_byte_sent + 1;  //Incr number of bytes read
            ack_in_prog <= 1'b1;
          end else begin
            if (!scl_prev & scl_curr) begin
              scl_is_high <= 1'b1;
            end

            if (scl_is_high) begin
              if (clk_i2c_cntr == START_IND_SETUP) begin
                valid_out <= 1'b0;
                {byte_sent, cntr} <= cntr + 1;
                data_in_sr <= {data_in_sr[6:0], sda_prev};  //MSB first
                scl_is_high <= 1'b0;
              end
            end
          end
        end

        READ_IDLE: begin
          if (read_next_byte) begin
            state   <= READ;
          end
        end

        /***
             * State: Write
             * Purpose: Write specified data words starting from address and incrementing by 1
             * How it Works: Simply send data out 1 byte at a time, with corresponding acks form slave.
             *               When all bytes are written, quit comms.
             */
        WRITE: begin
          if (byte_sent & cntr[0]) begin
            cntr <= 0;
            byte_sent <= 1'b0;
            state <= ACK_NACK_RX;
            // reg_sda_o <= 1'bz;
            sda_oe <= 1'b0;
            next_state <= (num_byte_sent == byte_len - 1) ? STOP : GRAB_DATA;
            num_byte_sent <= num_byte_sent + 1'b1;
            grab_next_data <= 1'b1;
          end else begin
            if (!scl_curr & scl_prev) begin
              scl_is_low <= 1'b1;
            end

            if (scl_is_low) begin  //negedge
              if (clk_i2c_cntr == DATA_HOLD_TIME) begin
                {byte_sent, cntr} <= {byte_sent, cntr} + 1;
                reg_sda_o         <= byte_sr[7];
                sda_oe            <= 1'b1;
                byte_sr           <= {byte_sr[6:0], 1'b0};  //shift out MSB
                scl_is_low        <= 1'b0;
              end
            end
          end
        end

        /***
             * State: GRAB_DATA
             * Purpose: Grab next 8 bit segment as needed
             * How it works: dequeue data, then grab the word requested (dequeue is req_data_chunk)
             */
        GRAB_DATA: begin
          if (grab_next_data) begin
            req_data_chunk <= 1'b1;
            grab_next_data <= 1'b0;
          end else if (next_chunk_ready == 1'b0) begin
            // Next chunk not ready yet. We idle and keep req == 1, so the memory module can use it to set
            // next_chunk_ready back to 0 once we've accepted the new chunk
            req_data_chunk <= 1'b1;
          end else begin
            state   <= WRITE;
            byte_sr <= i_data_write;
          end
        end

        /***
             * State: ACK_NACK_RX
             * Purpose: Receive ack_nack from slave
             * How it works: sda is already freed, simply look at posedges of scl, and look at data
             *               remember low is considered an ack, and high is a nack
             */
        ACK_NACK_RX: begin
          if (!scl_prev & scl_curr) begin
            scl_is_high <= 1'b1;
          end

          if (scl_is_high) begin
            if (clk_i2c_cntr == START_IND_SETUP) begin
              if (!sda_prev) begin  //checking for the ack condition (its low)
                state <= next_state;
              end else begin
                nack <= 1'b1;
                busy <= 1'b0;
                // reg_sda_o <= 1'bz;
                sda_oe <= 1'b0;
                en_scl <= 1'b0;
                state <= IDLE;
              end
              scl_is_high <= 1'b0;
            end
          end
        end

        /***
             * State: ACK_NACK_TX
             * Purpose: Take hold of SDA to acknowledge the read
             * How it works: On first negedge, since previous state will move on posedge, 
             *               pull the line low for an ack. On second negedge, release sda.
             */
        ACK_NACK_TX: begin
          sda_oe <= 1'b1;
          if (!scl_curr & scl_prev) begin
            scl_is_low <= 1'b1;
          end
          if (scl_is_low) begin  //negedge
            if (clk_i2c_cntr == DATA_HOLD_TIME) begin
              if (ack_in_prog) begin
                reg_sda_o   <= ack_nack;  //write ack until negedge of clk
                ack_in_prog <= 1'b0;
              end else begin
                // reg_sda_o <= next_state == STOP ? 1'b0 : 1'bz;
                sda_oe <= next_state == STOP ? 1'b1 : 1'b0;
                en_end_indicator <= next_state == STOP ? 1'b1 : en_end_indicator;
                state <= next_state;
              end
              scl_is_low <= 1'b0;
            end
          end
        end

        /***
             * State: STOP
             * Purpose: Pulls bus low on negedge, and waits for scl to be high
             *          drive sda to high from low, which is stop indication
             */
        STOP: begin
          if (!scl_curr & scl_prev & !rw) begin  //negedge only if we are writing
            reg_sda_o        <= 1'b0;  //Set to low
            sda_oe           <= 1'b1;
            en_end_indicator <= 1'b1;
          end

          //Note addition of counter, needed to ensure that there is enough delay for target device
          if (scl_curr & scl_prev & en_end_indicator) begin
            scl_is_high <= 1'b1;
            en_end_indicator <= 1'b0;
          end

          if (scl_is_high) begin
            if (clk_i2c_cntr == STOP_IND_SETUP) begin
              reg_sda_o <= 1'b1;
              sda_oe <= 1'b1;
              state <= RELEASE_BUS;
              scl_is_high <= 1'b0;
            end
          end
        end

        /***
             * State: Release bus
             * Purpose: Release the bus
             * How it works: Turn off 400KHz out and release the sda line, go back to idle
             */
        RELEASE_BUS: begin
          if (clk_i2c_cntr == clock_division - 3) begin
            en_scl <= 1'b0;
            state <= IDLE;
            // reg_sda_o <= 1'bz;
            sda_oe <= 1'b0;
            busy <= 1'b0;
          end
        end

        default: state <= IDLE;
      endcase

      if (force_stop == 1'b1 && handled_force_stop == 1'b0) begin
         state <= STOP;
         handled_force_stop <= 1'b1;
      end
    end
  end

  /*
 * Purpose: grabbing sda from slave
 */
  always @(negedge i_clk) begin
    if (!reset_n) begin
      {sda_curr, sda_prev} <= 0;
      {scl_curr, scl_prev} <= 0;
    end else begin
      sda_curr <= {sda_curr[0], sda_i};  //2 flip flop synchronization chain
      sda_prev <= sda_curr[1];
      scl_curr <= clk_i2c;
      scl_prev <= scl_curr;
    end
  end

  //inout cannot be reg
  assign sda_o = reg_sda_o;
  assign scl_o = clk_i2c;  //the line will be pulled up to VCC so 1'bz is high

  assign byte_ready = state == (READ_IDLE) ? 1 : 0;
endmodule

/* verilator lint_on WIDTHEXPAND */
