iic-jku/TinyWhisper/ihp130/macros/riscv/rtl/uart_tx.v

// SPDX-FileCopyrightText: 2025-2026 The TinyWhisper Team
// SPDX-License-Identifier: Apache-2.0 WITH SHL-2.1
// SPDX-FileCopyrightText: 2021 Ben Marshall
// SPDX-License-Identifier: MIT
//
// Module: uart_tx (taken from https://github.com/ben-marshall/uart)
//
// Notes:
// - UART transmitter module.
//

module uart_tx (
    input  wire        clk,            // Top level system clock input.
    input  wire        resetn,         // Asynchronous active low reset.
    output wire        uart_txd,       // UART transmit pin.
    output wire        uart_tx_busy,   // Module busy sending previous item.
    input  wire        uart_tx_en,     // Send the data on uart_tx_data
    input  wire [ 7:0] uart_tx_data,   // The data to be sent
    input  wire [15:0] CYCLES_PER_BIT
);

  // --------------------------------------------------------------------------- 
  // External parameters.
  //

  //
  // Input bit rate of the UART line.
  // parameter BIT_RATE = 115_200;  // bits / sec
  // localparam BIT_P = 1_000_000_000 * 1 / BAUD;  // nanoseconds

  // //
  // // Clock frequency in hertz.
  // // parameter CLK_HZ = 12_000_000;
  // localparam CLK_P = 1_000_000_000 * 1 / CLK_FREQ;  // nanoseconds

  //
  // Number of data bits recieved per UART packet.
  // parameter PAYLOAD_BITS = 8;

  //
  // Number of stop bits indicating the end of a packet.
  parameter STOP_BITS = 1;

  // --------------------------------------------------------------------------- 
  // Internal parameters.
  //

  //
  // Number of clock cycles per uart bit.
  // localparam CYCLES_PER_BIT = BIT_P / CLK_P;

  //
  // Size of the registers which store sample counts and bit durations.
  // localparam COUNT_REG_LEN = 1 + $clog2(CYCLES_PER_BIT);
  localparam COUNT_REG_LEN = 16;

  // --------------------------------------------------------------------------- 
  // Internal registers.
  //

  //
  // Internally latched value of the uart_txd line. Helps break long timing
  // paths from the logic to the output pins.
  reg txd_reg;

  //
  // Storage for the serial data to be sent.
  reg [7:0] data_to_send;

  //
  // Counter for the number of cycles over a packet bit.
  reg [COUNT_REG_LEN-1:0] cycle_counter;

  //
  // Counter for the number of sent bits of the packet.
  reg [3:0] bit_counter;

  //
  // Current and next states of the internal FSM.
  reg [2:0] fsm_state;
  reg [2:0] n_fsm_state;

  localparam FSM_IDLE = 0;
  localparam FSM_START = 1;
  localparam FSM_SEND = 2;
  localparam FSM_STOP = 3;


  // --------------------------------------------------------------------------- 
  // FSM next state selection.
  //

  assign uart_tx_busy = fsm_state != FSM_IDLE;
  assign uart_txd     = txd_reg;

  wire next_bit = cycle_counter == CYCLES_PER_BIT;
  wire payload_done = bit_counter == 8;
  wire stop_done = bit_counter == STOP_BITS && fsm_state == FSM_STOP;

  //
  // Handle picking the next state.
  always @(*) begin : p_n_fsm_state
    case (fsm_state)
      FSM_IDLE:  n_fsm_state = uart_tx_en ? FSM_START : FSM_IDLE;
      FSM_START: n_fsm_state = next_bit ? FSM_SEND : FSM_START;
      FSM_SEND:  n_fsm_state = payload_done ? FSM_STOP : FSM_SEND;
      FSM_STOP:  n_fsm_state = stop_done ? FSM_IDLE : FSM_STOP;
      default:   n_fsm_state = FSM_IDLE;
    endcase
  end

  // --------------------------------------------------------------------------- 
  // Internal register setting and re-setting.
  //

  //
  // Handle updates to the sent data register.
  always @(posedge clk) begin : p_data_to_send
    if (!resetn) begin
      data_to_send <= 8'b0;
    end else if (fsm_state == FSM_IDLE && uart_tx_en) begin
      data_to_send <= uart_tx_data;
    end else if (fsm_state == FSM_SEND && next_bit) begin
      data_to_send[0] <= data_to_send[1];
      data_to_send[1] <= data_to_send[2];
      data_to_send[2] <= data_to_send[3];
      data_to_send[3] <= data_to_send[4];
      data_to_send[4] <= data_to_send[5];
      data_to_send[5] <= data_to_send[6];
      data_to_send[6] <= data_to_send[7];
    end
  end


  /* verilator lint_off WIDTHTRUNC */
  //
  // Increments the bit counter each time a new bit frame is sent.
  always @(posedge clk) begin : p_bit_counter
    if (!resetn) begin
      bit_counter <= 4'b0;
    end else if (fsm_state != FSM_SEND && fsm_state != FSM_STOP) begin
      bit_counter <= {COUNT_REG_LEN{1'b0}};
    end else if (fsm_state == FSM_SEND && n_fsm_state == FSM_STOP) begin
      bit_counter <= {COUNT_REG_LEN{1'b0}};
    end else if (fsm_state == FSM_STOP && next_bit) begin
      bit_counter <= bit_counter + 1'b1;
    end else if (fsm_state == FSM_SEND && next_bit) begin
      bit_counter <= bit_counter + 1'b1;
    end
  end
  /* verilator lint_on WIDTHTRUNC */


  //
  // Increments the cycle counter when sending.
  always @(posedge clk) begin : p_cycle_counter
    if (!resetn) begin
      cycle_counter <= {COUNT_REG_LEN{1'b0}};
    end else if (next_bit) begin
      cycle_counter <= {COUNT_REG_LEN{1'b0}};
    end else if (fsm_state == FSM_START || fsm_state == FSM_SEND || fsm_state == FSM_STOP) begin
      cycle_counter <= cycle_counter + 1'b1;
    end
  end


  //
  // Progresses the next FSM state.
  always @(posedge clk) begin : p_fsm_state
    if (!resetn) begin
      fsm_state <= FSM_IDLE;
    end else begin
      fsm_state <= n_fsm_state;
    end
  end


  //
  // Responsible for updating the internal value of the txd_reg.
  always @(posedge clk) begin : p_txd_reg
    if (!resetn) begin
      txd_reg <= 1'b1;
    end else if (fsm_state == FSM_IDLE) begin
      txd_reg <= 1'b1;
    end else if (fsm_state == FSM_START) begin
      txd_reg <= 1'b0;
    end else if (fsm_state == FSM_SEND) begin
      txd_reg <= data_to_send[0];
    end else if (fsm_state == FSM_STOP) begin
      txd_reg <= 1'b1;
    end
  end

endmodule
