iic-jku/TinyWhisper/(commit log)

2026-05-02 added `enclosure` folder
2026-05-02 added `pcb` folder
2026-05-02 added `sky130` folder
    [amplifier_core_simplified_tb_ac_ol.csv, lc_bp_filter.sch, lc_bp_filter_tb_ac.sch, pin_order.cfg, single2cm.sch, single2dm.sch, wspr_tx_iqmod.sch, wspr_tx_iqmod_mfb_lpf.sch]
2026-05-02 added `ihp130` folder
    [3rd_order_mfb_lpf_prototype_bode.csv, SG13G2_os_layout_cheatsheet.xlsx, biquad_mfb_lpf_prototype_bode.csv, coupled_resonator_lc_bpf_1k_1k.sch, coupled_resonator_lc_bpf_1k_50R.sch, coupled_resonator_lc_bpf_tb_ac.sch, dsm_sine_data.csv, dsmod_params.txt]
2026-05-02 added software submodules `oled_96` and `printf`
2026-05-03 updated testbenches write `.raw` paths with `@schname\\\\.raw`
    [iqmod_mfb_lpf_ota_core_inv_tb_Vout.sch, iqmod_mfb_lpf_ota_core_inv_tb_ac_ol.sch, iqmod_mfb_lpf_ota_core_inv_tb_tran.sch, iqmod_mfb_lpf_ota_core_tb_CMRR.sch, iqmod_mfb_lpf_ota_core_tb_PSRR.sch, iqmod_mfb_lpf_ota_core_tb_Rin.sch, iqmod_mfb_lpf_ota_core_tb_Rout.sch, iqmod_mfb_lpf_ota_core_tb_Vout.sch]
2026-05-06 fixed CACE templates due to renaming of corners in IHP Open-PDK
    see COMMIT: https://github.com/IHP-GmbH/IHP-Open-PDK/commit/58d1f3d864f1165a643cba4669e4973851fb1bc5
    [iqmod_mfb_lpf_tb_ac.sch]
2026-05-22 added custom diode lib for better top-level convergence
2026-05-22 updated `tinywhisper_top_tb_tran.sch`
    [tinywhisper_top_tb_tran.sch]
2026-05-23 updated `reorder_spice_pins.py`
    Before the pin-set check the SPICE file is also reconciled against the symbol for 1-bit-bus name flattening: if the symbol declares a port `X[0]` but the SPICE file has the scalar `X` (a common Yosys/LibreLane side-effect when a Verilog bus has width 1), the scalar is renamed to `X[0]` throughout the whole SPICE file (subckt header *and* body) so all internal references stay consistent.
2026-07-07 added bondplan automation
    [tinywhisper_bondplan.csv]
2026-07-08 restructured packaging folder
    [tinywhisper_bondplan.csv]
2026-07-08 updated bondplan flow
    [tinywhisper_bondplan.csv]
2026-07-13 updated automated bondplan generation flow
    Replace the hand-drawn bondplan with a config-driven flow
    (scripts/run_bondplan.py + config.yaml, LibreLane-style):
    - generate the package sheet from the EUROPRACTICE library
    (EP_PACKAGES_08022018.gds) with lead frame auto-detection and
    removal of unwanted template texts (PACKAGE_DELETE_TEXTS)
    - detect die bondpads from Passiv openings and TopMetal2.text labels,
    no LEF needed
    - place the die into the package cavity (centered by default) and draw
    all bondwires incl. exposed-pad downbonds on Exchange0.drawing
    - fill the EUROPRACTICE title block from computed placeholders, mark
    the lid checkbox, re-align pin numbers to their wire attach point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
    [tinywhisper_bondplan.csv]
2026-07-13 reran bondplan generation flow
2026-07-15 set executable bit (+x) on tracked scripts
    core.filemode=false on Windows stored these scripts as 100644, so on a
    fresh clone/pull on Linux/macOS ./run_lvs.sh (and the helpers it calls)
    failed with "Permission denied". Set mode 100755 in the git index for all
    tracked shell/python scripts, including the top-level LVS flow scripts.
2026-07-22 Changed 80m frequency (the current WSJT-X default since v1.8 is 3.568600 MHz (changed for JT65/FT8 coexistence and Japanese band rules))
2026-07-25 removed `ntap` / `ptap` devices from schematics, symbols and testbenches
    [iqmod_mfb_lpf.sch, iqmod_mfb_lpf_R1.sch, iqmod_mfb_lpf_R2.sch, iqmod_mfb_lpf_R3.sch, iqmod_mfb_lpf_R4.sch, iqmod_mfb_lpf_half.sch, iqmod_mfb_lpf_ota_core_hybrid_bm.sch, iqmod_mfb_lpf_ota_core_hybrid_bm_half.sch]
2026-07-25 updated CACE testbenches
    [iqmod_mfb_lpf_ota_core_tb_ac.sch, iqmod_mfb_lpf_tb_ac.sch]
2026-07-27 synchronized `TinyWhisper/ihp130` with `ihp-sg13g2-ams-chip-template`
    [coupled_resonator_lc_bpf_1k_1k.sch, coupled_resonator_lc_bpf_1k_50R.sch, coupled_resonator_lc_bpf_tb_ac.sch, iqmod_mfb_lpf.sch, iqmod_mfb_lpf_R1.sch, iqmod_mfb_lpf_R2.sch, iqmod_mfb_lpf_R3.sch, iqmod_mfb_lpf_R4.sch]
2026-07-31 updated `coupled_resonator_lc_bpf/README.md`
2026-08-24 synchronized `ihp130/` with the G2 template `2026.08`
    Ported the changes of iic-jku/ihp-sg13g2-ams-chip-template 2026.07..2026.08 (a2d1b13) to `ihp130/`, keeping the TinyWhisper macros and deviations (riscv/iqmod/coupled_resonator_lc_bpf, per-cell riscv testbench folders, NIGHTLY_REGRESSION, build-macros and build-fpga commented out, magic-pex kept out of riscv `all`, custom top-level LVS flow in `verification/lvs/`, pico-ice as the only FPGA board).
    Makefiles (top level, riscv, iqmod, coupled_resonator_lc_bpf, 5 IPs):
    - `open` target with `OPEN_ARGS`, `clean` per Makefile and `clean-all` at the top level (5 IPs, 3 macros).
    - `render-gds` uses `sak-render.py` instead of the deleted `lay2img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
    [coupled_resonator_lc_bpf_tb_ac.sch, iqmod_mfb_lpf_ota_core_inv_NF10.sch, iqmod_mfb_lpf_ota_core_inv_NF20.sch, iqmod_mfb_lpf_ota_core_inv_NF6.sch, iqmod_mfb_lpf_ota_core_inv_tb_Vout.sch, iqmod_mfb_lpf_ota_core_inv_tb_ac_ol.sch, iqmod_mfb_lpf_ota_core_inv_tb_tran.sch, iqmod_mfb_lpf_ota_core_spdt_switch_inv.sch]
2026-08-25 commited `memory.sv` for simulation on server (revert in the end !!!)
    [memory.sv]
2026-08-25 [Server] executed make all in riscv
    [dsmod_params.txt, dsmod_ramp_params.txt]
2026-08-25 Added iCEBreaker and ULX3S FPGA boards, made the ECP5 ULX3S the default
    The macro no longer fits the iCE40UP5K of the pico-ice, which is why `build-fpga` was commented out in `make all`. Both iCE40 boards synthesize to 6132 ICESTORM_LCs against the 5280 the UP5K has, 116%, and nextpnr stops with `Failed to expand region`. The numbers are identical on the two boards, so the overflow is in the RTL and not in a pin map.
    `fpga/ulx3s/` adds a Lattice ECP5-85F board (CABGA381, openFPGALoader). The same design takes 5751 of the 83640 TRELLIS_COMBs, 6.9%, and closes timing at 51.0 MHz against the 25 MHz oscillator, so `build-fpga` is part of `make all` again and builds the ULX3S bitstream. `fpga/Ma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
    [icebreaker.pcf]
2026-08-25 deleted stray dsmod files
    [dsmod_params.txt]
2026-08-25 fixed the duplicate VSS pin that broke the PEX pin reorder
    `tinywhisper_top.sch` labelled all three IOVSS pads VSS and gave every supply pad a port of its own, so `tinywhisper_top.sym` carried 12 VSS, 7 VDD and 3 IOVDD pins and `sak-pin-reorder.py` aborts with a pin count mismatch of 56 against the 37 ports the extraction writes. A `.subckt` port list holds one entry per net, so the same name cannot appear twice.
    The three IOVSS pads (x8, x16, x55), their supply ring and the matching symbol pin are now labelled IOVSS, which is what `tinywhisper_top.sv`, the LibreLane netlist `netlist/spice/tinywhisper_top.spice` and the pin labels of the GDS have called it all along. The ring assignment was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
    [tinywhisper_top.sch, tinywhisper_top_tb_tran.sch]
2026-08-25 kept the full pad ring on the chip symbol and pruned only the PEX symbol
    The previous commit took the de-duplication too far: it removed 18 supply pins from `tinywhisper_top.sym`, turned their ports into net labels and pruned the testbench wiring that fed them. The chip symbol is the drawing of the pad ring, so one pin per bond pad is what it should show. Restored, along with the schematic ports and the testbench, leaving only the IOVSS rename of the three IOVSS pads, their supply ring and the three matching symbol pins.
    The de-duplication belongs to the generated symbol alone. [`scripts/prune_pex_symbol.py`](scripts/prune_pex_symbol.py) drops the pins named in `PEX_MERGED_PINS` and every r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
    [tinywhisper_top.sch, tinywhisper_top_tb_tran.sch]
2026-08-26 [Server] executed magic-pex, all and release targets
    [tinywhisper_top_tb_tran.sch]
2026-09-04 added `scripts/` folder, `Makefile` and `README.md` to `macros/` folder
    Port of ihp-sg13g2-ams-chip-template 6d63130 to ihp130/. The macros README is written for riscv, iqmod and coupled_resonator_lc_bpf, and the chip README tree and target overview point at the new Makefile.
2026-11-11 added cavity bonds (`EPAD_NETS`) to `run_bondplan.py`, a wire crossing now fails the run
    New: `EPAD_NETS` with paddle and landing checks, uncrossing of same-net wires, a seal ring skip (the old stray `vdd` pad was the seal ring) and port labels ranked over pad cell labels. A downbond aims at its own net's landing only where that clears the other wires as well as the stub parallel to its neighbours. With the old config the bond table is unchanged.
2026-11-11 raised the naked die quantity on the bondplan to 40
2026-11-11 bonded VSS and IOVSS only through the cavity and swapped pins 14 and 15
    All 12 VSS and IOVSS pads downbond to the paddle, and the leads 15 (IOVSS), 27, 34 and 46 (VSS) bond to it, so 60 wires instead of 56. Pin 14 is VDD now and pin 15 IOVSS. `PACKAGE_PADDLE` is the 5.300 mm paddle of QP's QP-QFN48-7MM-0.50MM, whose 6.325 mm cavity matches the EUROPRACTICE drawing. The lead tips stop 150 um short of it. The other 43 wires are unchanged, and the minimum gap stays 49.3 um.
2026-11-11 added TinyWhisper March 2026 TO die shots
2026-11-11 cropped die fotos
2026-11-11 added the die photo to the README and the Quarto docs
2026-11-14 added the chip dashboard doc/dashboard.html with make dashboard
    ihp130/scripts/gen_dashboard.py parses the committed iqmod AC curves, the CACE Monte Carlo samples, the riscv STA, power and stat reports, the RTL line counts and the errata, and inlines them into dashboard_template.html. The RF output power (61.9 uW, -12.1 dBm into 1 kOhm behind the 28 MHz BPF) is computed from the committed iqmod_top_tb_tran waveform. Analog supply power is listed as open, since that testbench run was never kept. The page is published as a Quarto resource with a navbar link. The target needs no PDK.
2026-11-14 added the iqmod_top supply power to the chip dashboard
    iqmod_top_tb_tran run in IIC-OSIC-TOOLS latest (ngspice-47) gives PDD = 24.4 mW at 1.5 V, Pout = 71.3 uW and 0.29 % efficiency on the schematic netlist. The same testbench with the PEX netlist fails to find an operating point (all extracted nodes NaN), so the dashboard labels the numbers as schematic level and the sign-off row as warn.
