iic-jku/TinyWhisper/(notices)

Notices in the files:
README.md:
License: Solderpad Hardware License v2.1
